cowlove/atari8EspBusBang/hardware/sidecar_smd/README.md

# sidecar_smd: the Sidecar carrier with bare modules (speculative)

The [espBusBangSidecar](../espBusBangSidecar/) carrier with both
ESP32-S3-DevKitC-1 boards replaced by bare **ESP32-S3-WROOM-1-N8R2** modules,
plus what the DevKitC boards used to provide. A sketch of where a production
board could go, not a design to build yet.

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

Layout: the modules' antennas and the microSD slot point off the top edge;
J1 runs along the bottom; the main module's support parts (J5, J6, J3, U3)
are in a left wing and the Sidecar's (J4, J7, U4) in a right wing, beside J1;
the passives sit next to the module pins they serve. The regulators U3 and
U4 are on the back, for hand soldering. Board 110.5 × 35.6 mm.

DRC leftovers: the WROOM footprint's 0.2 mm thermal vias are below the board
setup's 0.3 mm minimum hole (raise the fab capability or lower the minimum);
the modules' silkscreen overhangs the top edge with the antennas; the
"10/02/25" text from the original board sits on J1's pads; four GND pads
reach the pour through one thermal spoke instead of two (starved_thermal);
J1's footprint library ("footprints") isn't in the library table.

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

## Files

| File | |
|---|---|
| `sidecar_smd.kicad_sch` | Generated: don't edit by hand |
| `sidecar_smd.kicad_pro`, `.kicad_pcb` | Copied from espBusBangSidecar (filenames updated) |
| [`../tools/make_sidecar_smd_schematic.py`](../tools/make_sidecar_smd_schematic.py) | Builds it from the espBusBangSidecar schematic and its netlist |

```
kicad-cli sch export netlist -o /tmp/sc.net hardware/espBusBangSidecar/espBusBangSidecar.kicad_sch
python3 hardware/tools/make_sidecar_smd_schematic.py \
    hardware/espBusBangSidecar/espBusBangSidecar.kicad_sch /tmp/sc.net \
    <kicad>/share/kicad/symbols hardware/sidecar_smd/sidecar_smd.kicad_sch
```

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

## What replaced each DevKitC

| Per module | Main (U1) | Sidecar (U2) |
|---|---|---|
| Module | ESP32-S3-WROOM-1-N8R2, `RF_Module:ESP32-S3-WROOM-1` | same |
| 3.3 V regulator | U3 AP7361C-33E (SOT-223, 1 A) from the board rail `+5V` | U4, same |
| Capacitors | C1 10 µ in, C2 22 µ out, C3 100 n at the module | C5, C6, C7 |
| EN (reset) | R8 10 k to 3V3, C4 1 µ to GND: the RC power-on reset the DevKitC had | R10, C8 (`SC_EN`, also on J4) |
| IO0 (boot mode) | R9 10 k to 3V3: boots from flash (also J5 pin 6; the net is `LINK_TX`) | R11 (`SC_BOOT`, also on J4 pin 6) |
| 3V3 net | `3V3` | `SC_3V3` (also J2's SD card and R2-R6) |
| microSD | none | J2, a push-pull microSD socket (Hirose DM3AT-SF-PEJM5, `Connector_Card:microSD_HC_Hirose_DM3AT-SF-PEJM5`) in place of the DevKitC carrier's breakout header: same `SD_*` nets on IO1, IO2, IO42, IO41, IO40, IO39, R2-R6's pull-ups, VDD from `SC_3V3` with C10 100 n, shield to GND. Card detect: the socket's switch runs from GND (DET_B) to `SD_CD` (DET_A), pulled up by R14 10 k to `SC_3V3`, read on Sidecar IO14 |
| Indicator | D2, an LED on MPD_: see below | D1 (below) |
| RGB status LED | none: GPIO48 is the link's BCLK | D1 SK6812MINI (WS2812 protocol) on GPIO48 (`SC_LED`), as on the DevKitC-1 v1.0, from `SC_3V3`, with C9 100 n; DOUT unconnected |

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

## Main module: RFSH and RESET on the USB pins

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

## D2: the main module's indicator, on MPD_

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

## J7: Sidecar breakout

Every Sidecar GPIO with no other job, with power, on a 2×7 header
(`PinHeader_2x07_P2.54mm_Vertical`, odd pins in one row, even in the other).
3V3 and GND are the end pair; USB D−/D+ sit right beside them; a second GND
fills the far end.

| Pin | Net | Pin | Net |
|---|---|---|---|
| 1 | 3V3 (`SC_3V3`) | 2 | GND |
| 3 | IO19 (USB D−) | 4 | IO20 (USB D+) |
| 5 | IO3 (strapping: JTAG source; leave floating at reset) | 6 | IO8 |
| 7 | IO18 | 8 | IO21 |
| 9 | IO35 | 10 | IO36 |
| 11 | IO37 | 12 | IO38 |
| 13 | IO45 (strapping: VDD_SPI; low at reset unless the eFuse is burned) | 14 | GND |

Pins 2-4 are the Sidecar's native USB (GND, D−, D+): a USB cable breakout
there gives USB serial/JTAG without an adapter. IO35-37 are free on the
N8R2's quad PSRAM; an octal-PSRAM module (N8R8) uses them internally.

## Card detect

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

## Soldering

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

## J6: board power

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

## J4 and J5: programming headers (ESP-Prog)

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

## Power during development

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

## Flashing rules

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

## Open questions before this could be built

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
