cowlove/atari8EspBusBang/csim/a800/README.md

# Atari800 CSIM hybrid

The hybrid builds Atari800 from the `atari800` Git submodule in this directory. It configures Atari800 in-place; no separate Atari800 build directory is needed.

## Initialize the submodule

From the `atari8EspBusBang` repository root:

```sh
git submodule update --init --recursive
```

The submodule tracks Jim's `cowlove/atari800` fork on the `csim-pbi` branch.

## Generate and configure Atari800

The submodule checkout may not contain the generated `configure` script. From `csim/a800/atari800`:

```sh
./autogen.sh
CFLAGS='-g -O2 -Wno-error=unused-function' \
  ./configure --with-video=sdl2 --with-sound=sdl2 \
  --disable-audiorecording --disable-dependency-tracking
```

This is the SDL2 configuration (`VIDEO=1`). `autogen.sh` requires the autotools utilities (`aclocal`, `autoheader`, `autoconf`, and `automake`); SDL2 development files are needed for this configuration. Run both commands from the submodule root so configure creates `src/Makefile` there.

If `configure` or `src/Makefile` is missing, the Makefile generates/configures it automatically. The Makefile defaults to `VIDEO=0` (no video or sound); use `VIDEO=1` to enable SDL2:

```sh
make -C csim/a800 VIDEO=1 hybrid
```

Switching `VIDEO` automatically reconfigures Atari800 and reuses the same build and executable directories. `VIDEO=0` is already the default; use `make -C csim/a800 VIDEO=1 hybrid` for SDL2. `run.sh` launches the built emulator directly without Xvfb. If also profiling, combine variables, for example `make -C csim/a800 VIDEO=1 PROFILE=1 hybrid`.

## Build and run

From the repository root:

```sh
make -C csim/a800 hybrid
csim/a800/run.sh
```

`BOOT_CONFIG` selects the firmware boot configuration and defaults to `CSIM`.
Set it to any configuration name supported by `SysConfig`, for example:

```sh
BOOT_CONFIG="SDX_XL" make -C csim/a800
```

Changing `BOOT_CONFIG` automatically rebuilds the CSIM objects that embed the
selected configuration.

To start Atari800 under GDB, with `-xl -nopatchall` and any following arguments passed to the emulator:

```sh
csim/a800/run.sh --gdb -turbo
```

The hybrid executable is written to `csim/a800/build-atari/atari800-csim`. Additional arguments to `run.sh` are forwarded to Atari800.

CSIM uses the real `libsmb2` client from the firmware's `libsmb2` submodule,
`components/libsmb2/libsmb2`, for SMB-backed disks. Initialize it with `git
submodule update --init components/libsmb2/libsmb2`; the CSIM Makefile builds its shared library in the
separate ignored `csim/a800/build-libsmb2` directory and links both runner and hybrid
targets against it. SMB URLs must be reachable from the host running CSIM, and
the URL or configured credentials must permit access.

## CSIM scope and emulator services

CSIM runs the firmware-side code in a host process; by default it does not
itself emulate Atari hardware memory mapping (see bus-cycle mode below for
the exception). Keep the normal firmware paths compiled and
running under CSIM—do not exclude them with `#ifdef CSIM` just because their
hardware services are not implemented by the CSIM stubs. Atari800 supplies
the guest-system behavior, including cartridge mapping, extended-memory
mapping, and RAM-under-OS behavior, according to its startup configuration.

In particular, `run.sh` starts Atari800 with `-xl -nopatchall`, the
`SDX451_maxflash1.car` cartridge, `-turbo`, and `-rambo`. `-rambo` enables
Atari800's RAMBO extended-memory model; SDX's `RAMDISK.SYS` driver still has to
be installed by SDX (for example, from its configuration or a batch command)
to create a DOS-visible RAM disk. `BOOT_CONFIG` selects the firmware
configuration independently of the cartridge passed to Atari800 by `run.sh`,
so those two selections can differ.

## Bus-cycle mode (`BUS_CYCLE=1`)

`BUS_CYCLE=1 csim/a800/run.sh` builds both sides with `-DCSIM_BUS_CYCLE`: every
CPU access in atari800 runs one bus cycle through `csim_bus_cycle()` in
`main/core1.cpp`, so the board's own memory map (`mmu.cpp`, `cartridge.cpp`,
extended banks, PBI ROM) serves the 6502. `csim_bus_cycle()` is a plain C++
reference version of core 1's ESP32 loop (`iloop_pbi()`), not that loop
itself: it does what the loop does, without the timing and asm, and the two
have to be kept in step. When it asserts extSel_ the board handled the
access; otherwise atari800 does. `run.sh` then defaults `BOOT_CONFIG` to `SDX_CSIM_BUS` and gives
atari800 no cartridge and no `-rambo`, since the board supplies both.
Core 0 runs as a coroutine in this mode (2026-11-12): it has its own stack
and runs the real `threadFunc()`/`core0Loop()`, as on the hardware (bmon,
PBI requests with the real stack-program wait, the startup first-write
handshake, utility tasks, interrupt pacing, timeouts, the end-of-run
report). atari800's CPU tick resumes it; it yields back on every 64th
CCOUNT read from its stack and in `busyWait6502Ticks()`, which waits real
emulated time. atari800 is never re-entered. (`swapcontext()` saves the
signal mask with a syscall, so the mode runs about 3x slower than before.)
`CSIM_INTERNAL_FREE=<bytes>` sets how much internal RAM `heap_caps_get_free_size()`
reports (default: plenty), for sizing decisions such as `SDX_CSIM_BUS_AUTO`'s SRAM budget.
`CSIM_BUS_CYCLE_TEST=1` runs a short self-test at startup. Expect it to run
several times slower than the default mode.

What it doesn't cover:

- **Exact halts and PSRAM swaps.** halt_ is emulated approximately
  (2026-11-12): `csim_stubs.cpp` tracks the pin from each cycle's
  release/assert, and while the board holds it atari800's CPU runs no
  instruction, only idle bus cycles and core 0's tick, until core 0's
  release reaches the pin (`busyWait6502Ticks()` runs idle cycles in this
  mode, so `resume6502()` works). Stalls happen only at instruction
  boundaries, and ANTIC's NMIs aren't held off. That's enough to see
  whether a halt stops the 6502, and BANKTEST passes with every PORTB
  switch really halting; the exit line reports `csim halt line on: N
  stalls`. `CSIM_HALT_LINE=0` plays a machine without the line (a 130XE on
  the ECI): halt_ is driven, nothing stalls. Still not covered: evictions.
  `ExtBankPool::isSRAM()` passes every host pointer, every bank counts as
  SRAM, and the status line reads `evict 0/N`. Test evictions on
  hardware.
- **ANTIC.** Its DMA reads use atari800's memory, not the board's map, so
  the display shows atari800's RAM where the board serves memory.
- **Timing.** The body's delays are no-ops; the cycle order is atari800's.
  atari800's monitor history peeks at the code without a bus cycle, so the
  board sees only the CPU's own accesses.

### Bank tests

`spiffs/stress.c` (`make -C spiffs stress.car.gz stress-megacart.car.gz`,
boot configs `BANKTEST` for the AtariMax build and `BANKTEST_MC` for the
MegaCart one) checks that a bank switch reaches the very next bus cycle,
alongside stress's other tests: an STA to PORTB, $D5xx or $D1FF falls
through into the banked window ($4000, the cart window, $D800), and bank B
counts the hit in X. The $D1FF stub runs at $D7FD, in the PBI RAM the board
keeps at $D600-$D7FF (`main/mmu.cpp`; the atari800 fork gives the default
mode the same RAM). A fourth test (AtariMax only) disables BASIC the same
way, falling from ROM into the RAM under it. Each loop prints
`bank ext:misses/tries cart:... pbi:... basic:... cal:N` (`cal`: calibration
failures; the MegaCart build adds `late:`).

MegaCart selects the bank by the data written to $D500, which the board
picks up one cycle late (`main/core1.cpp`), so its build runs the cart test
twice: `cart` with a NOP between the STA and the probe (should hit) and
`late`, the exact fall-through (misses on the board by design).

```sh
CART=../../spiffs/.build/stress.car BOOT_CONFIG=BANKTEST csim/a800/run.sh
CART=../../spiffs/.build/stress-megacart.car BOOT_CONFIG=BANKTEST_MC csim/a800/run.sh
BUS_CYCLE=1 BOOT_CONFIG=BANKTEST csim/a800/run.sh
BUS_CYCLE=1 BOOT_CONFIG=BANKTEST_MC csim/a800/run.sh
```

Everything passes in the default mode, where atari800 switches banks
itself. In bus-cycle mode (2026-11-11) the board passes every PORTB, $D1FF
and AtariMax $D5xx switch and the BASIC test, and MegaCart's `cart`; only
`late` misses, every time. With the MegaCart read-path pickup taken out of
the board (as before 490244a8), `cart` misses every time too. On hardware,
`BANKTEST` uses one SRAM bank, so every PORTB switch also exercises the halt
and PSRAM swap. The MegaCart build leaves the ext test out (`ext:0/0`): its
C stack sits inside the $4000-$7FFF bank window.

## Profiling

Build both the CSIM code and Atari800 with GNU `gprof` instrumentation by setting `PROFILE=1`:

```sh
make -C csim/a800 PROFILE=1 hybrid
```

This adds `-pg` to the CSIM compiler and linker flags and to Atari800's `CFLAGS`, `CXXFLAGS`, and `LDFLAGS`. The normal build remains the default (`PROFILE=0`); switch back with `make -C csim/a800 PROFILE=0 hybrid`. Changing the profile setting automatically refreshes affected objects and Atari800 configuration, while keeping the same build and executable directories.

## Sidecar

CSIM always runs the Sidecar coprocessor app (`sidecar/main/sidecarApp.cpp`)
in the same process: `csim.h` defines `CONFIG_A8BB_SIDECAR_ENABLE`, so the
host's Sidecar code (`main/sidecarHost.cpp`) is on too. The two meet in a
simulated i2slink (`components/sidecar_link/i2slink_csim.cpp`) that replaces
the I2S hardware at the `i2slink.h` boundary:

- each direction is a shared buffer: `i2slink_write()` builds the real wire
  cycle (VSYNC, HSYNC markers, stamps, CRC) and stores it in the peer's RX
  ring, bit-shifted by a random amount per connection, so the reader's real
  lock search and decode (`i2slink_wire.h`) run;
- `csim_sidecar.cpp` wires the host's link pins (virtual GPIOs 100/101 in
  `pinDefs.h`) to the Sidecar's, and polls the Sidecar's loop after every
  link write (so a response is ready when the host's write returns) and on
  every emulated CPU tick;
- there is no timing model: `read()` never waits, and a wait only advances
  simulated time (`esp_timer_get_time()` follows CCOUNT).

At startup the host probes the Sidecar and sends one SIO command; look for
`Sidecar: present; SIO echo ok` in the output.
