cowlove/atari8EspBusBang/hardware/gerbers/pcbway/espBusBangSidecar-bom.csv

Item # | Designator | Qty | Manufacturer | Mfg Part # | Description / Value | Package/Footprint | Type | Your Instructions / Notes
1 | D2 | 1 | Hubei KENTO | KT-0805G | Green LED | 0805 | SMD | Any 0805 LED, colour free
2 | J1 | 1 | TE Connectivity | 5530843-5 | 50-pos 2.54mm card edge connector (PBI) | THT | THT | Insert from the BOTTOM side (opposite the modules), solder on top. The footprint and its silkscreen are on the top layer
3 | J2 | 1 | Generic | 1x08 2.54mm male header | 8-pin 2.54mm male pin header, vertical | THT | THT
4 | J3 | 1 | Generic | 1x03 2.54mm male header | 3-pin 2.54mm male pin header, vertical | THT | THT
5 | J4,J5 | 2 | Generic | 2x03 2.54mm male header | 6-pin 2.54mm male pin header, vertical | THT | THT
6 | J7 | 1 | Generic | 2x08 2.54mm male header | 16-pin 2.54mm male pin header, vertical | THT | THT
7 | J8,J9,J10 | 3 | Generic | 1x02 2.54mm male header | 2-pin 2.54mm male pin header, vertical | THT | THT
8 | R1 | 1 | UNI-ROYAL | 0805W8F0000T5E | 0 ohm resistor | 0805 | SMD
9 | R2,R3,R4,R5,R6 | 5 | UNI-ROYAL | 0805W8F1002T5E | 10k 1% resistor | 0805 | SMD
10 | R7,R12,R13,R15,R16,R17 | 6 | UNI-ROYAL | 0805W8F1001T5E | 1k 1% resistor | 0805 | SMD
11 | U1,U2 | 2 | Generic | 1x22 2.54mm female header | Socket for an ESP32-S3-DevKitC-1: two 1x22 2.54mm female headers per designator | THT | THT | Fit 2 x 1x22 female headers per designator (4 total for U1+U2); DevKitC boards NOT supplied
