cowlove/atari8EspBusBang/docs/sidecar_wiring.pdf

# Main board <-> Sidecar wiring (ESP32-S3-DevKitC-1 pair)

Generated 2026-11-12 by hardware/tools/sidecar_wiring.py. Ground and power come through the carrier board (not drawn). Header pin numbers: DevKitC-1, pin 1 away from the USB end.

## Main board (host app)

J1 | J3USB end
1 | 3V3
2 | 3V3
3 | RST
4 | GPIO4
5 | GPIO5
6 | GPIO6
7 | GPIO7
8 | GPIO15
9 | GPIO16
10 | GPIO17
11 | GPIO18
12 | GPIO8
13 | GPIO3 | strap
14 | GPIO46 strap
15 | GPIO9
16 | GPIO10
17 | GPIO11
18 | GPIO12
19 | GPIO13
20 | GPIO14
21 | 5V
22 | GND
| GND | 1
U0TXD | GPIO43 | 2
U0RXD | GPIO44 | 3
| GPIO1 | 4
| GPIO2 | 5
| GPIO42 | 6
| GPIO41 | 7
| GPIO40 | 8
| GPIO39 | 9
| GPIO38 | 10
| GPIO37 | 11
| GPIO36 | 12
| GPIO35 | 13
strap | GPIO0 | 14
strap | GPIO45 | 15
| GPIO48 | 16
| GPIO47 | 17
| GPIO21 | 18
USB D+ | GPIO20 | 19
USB D- | GPIO19 | 20
| GND | 21
| GND | 22

## Sidecar board

J1 | J3USB end
1 | 3V3
2 | 3V3
3 | RST
4 | GPIO4
5 | GPIO5
6 | GPIO6
7 | GPIO7
8 | GPIO15
9 | GPIO16
10 | GPIO17
11 | GPIO18
12 | GPIO8
13 | GPIO3 | strap
14 | GPIO46 strap
15 | GPIO9
16 | GPIO10
17 | GPIO11
18 | GPIO12
19 | GPIO13
20 | GPIO14
21 | 5V
22 | GND
| GND | 1
U0TXD | GPIO43 | 2
U0RXD | GPIO44 | 3
| GPIO1 | 4
| GPIO2 | 5
| GPIO42 | 6
| GPIO41 | 7
| GPIO40 | 8
| GPIO39 | 9
| GPIO38 | 10
oPSRAM | GPIO37 | 11
oPSRAM | GPIO36 | 12
oPSRAM | GPIO35 | 13
strap | GPIO0 | 14
strap | GPIO45 | 15
| GPIO48 | 16
| GPIO47 | 17
| GPIO21 | 18
USB D+ | GPIO20 | 19
USB D- | GPIO19 | 20
| GND | 21
| GND | 22

Atari RFSH (3.3 V side)

Atari AUDIO (PBI 49)

microSD
4-bit SDMMC

DAT2

DAT3

CMD

CLK

DAT0

DAT1

VDD 3.3 V, GND
10 k pull-ups
Signal | From | To | Header (from -> to) Status | Notes
Link TX | main GPIO0 | Sidecar GPIO9 | J3-14 -> J1-15 | wired | host TX -> Sidecar RX; also main IO0 (BOOT) for serial flashing; PBI audio on espBusBang only
Link RX | Sidecar GPIO46 | main GPIO21 | J1-14 -> J3-18 | wired | Sidecar TX -> host RX; Sidecar carrier: via jumper J3 2-3 (1-2: GPIO21 = RFSH)
BCLK | main GPIO48 | Sidecar GPIO10 | J3-16 -> J1-16 | wired | host drives the link clock; sampler (link off): main’s profile pin GPIO48
phi2 | main GPIO36 | Sidecar GPIO4 | J3-12 -> J1-4 | planned | Sidecar bus profiler: clock
R/W | main GPIO17 | Sidecar GPIO5 | J1-10 -> J1-5 | planned | Sidecar bus profiler; host R/W is GPIO15 on the Sidecar carrier (R/W regroup)
extSel_ | main GPIO47 | Sidecar GPIO6 | J3-17 -> J1-6 | planned | Sidecar bus profiler; open drain on the host, keep it short
D0 | main GPIO38 | Sidecar GPIO7 | J3-10 -> J1-7 | planned | Sidecar bus profiler
D1 | main GPIO39 | Sidecar GPIO15 | J3-9 -> J1-8 | planned | Sidecar bus profiler

## Main board <-> Sidecar wiring (ESP32-S3-DevKitC-1 pair) (continued)

Signal | From | To | Header (from -> to) Status | Notes
A0 | main GPIO1 | Sidecar GPIO16 | J3-4 -> J1-9 | planned | Sidecar bus profiler
RFSH | Atari RFSH | Sidecar GPIO17 | - -> J1-10 | planned | Sidecar bus profiler refresh_; 3.3 V side, never the 5 V bus line; or main GPIO21 where it is refresh_ (espBusBang, .5)
SD DAT2 Sidecar GPIO1 | microSD DAT2 | J3-4 -> - | planned | 10 k pull-up
SD DAT3 Sidecar GPIO2 | microSD DAT3 | J3-5 -> - | planned | 10 k pull-up (also CD)
SD CMD Sidecar GPIO42 | microSD CMD | J3-6 -> - | planned | 10 k pull-up
SD CLK | Sidecar GPIO41 | microSD CLK | J3-7 -> - | planned | up to 40 MHz; keep it short, no pull-up
SD DAT0 Sidecar GPIO40 | microSD DAT0 | J3-8 -> - | planned | 10 k pull-up
SD DAT1 Sidecar GPIO39 | microSD DAT1 | J3-9 -> - | planned | 10 k pull-up
Main EN | Sidecar GPIO11 | main RST (EN) | J1-17 -> J1-3 | planned | open drain: the Sidecar resets the main board (flashing, recovery)
Flash TX Sidecar GPIO12 | main GPIO44 | J1-18 -> J3-3 | planned | via 1 k to main RXD0 = Atari D6: only with the Atari off
Flash RX main GPIO43 | Sidecar GPIO13 | J3-2 -> J1-19 | planned | via 1 k from main TXD0 = Atari D5: only with the Atari off
Audio | Sidecar GPIO47 | Atari AUDIO | J3-17 -> - | planned | via 1 k series resistor (sets the level); host GPIO0 no longer on AUDIO

Solid: wired now. Dashed: planned. Filled pin: has a wire. oPSRAM: octal-PSRAM pin (N8R8, N16R8 modules).
Bus-profiler taps: Sidecar inputs only, no pulls; 330-470 ohm in series at the main board end.
Keep the Sidecar powered (its own USB) whenever the Atari is on: an unpowered ESP32 loads the bus lines.
