cowlove/atari8EspBusBang/hardware/sidecar_pcb_xe/sidecar_pcb_xe.kicad_pcb

## KiCad design hardware/sidecar_pcb_xe/sidecar_pcb_xe.kicad_pcb (2026-11-13)

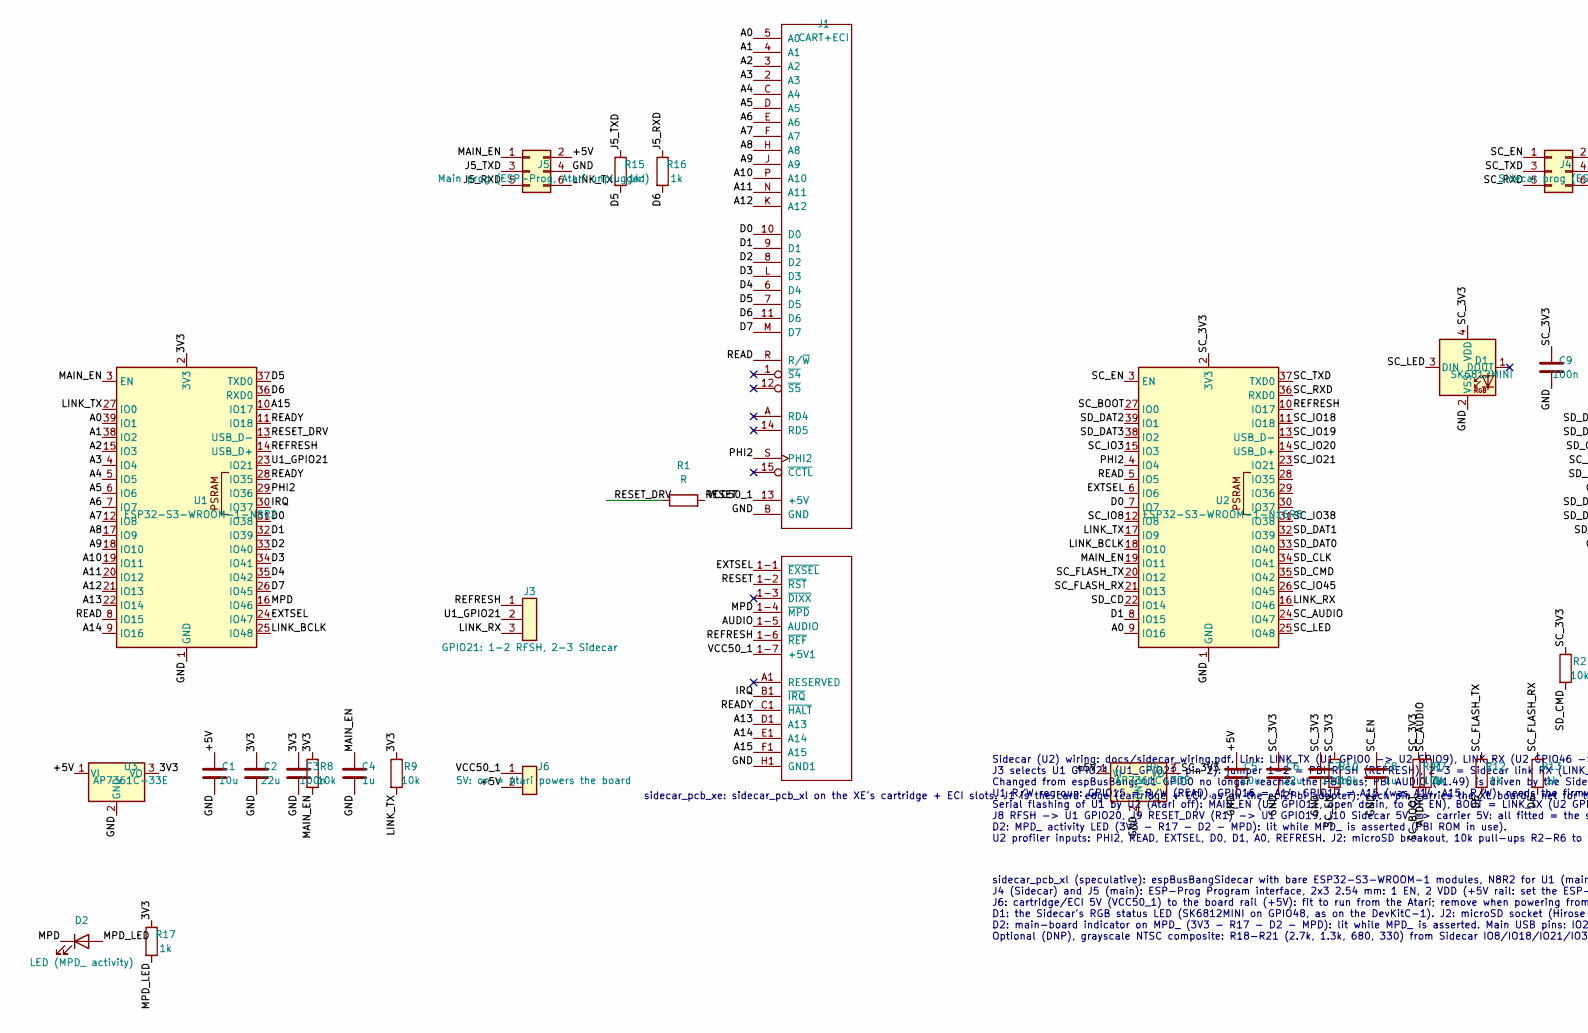
[picture p1: schematic sidecar_pcb_xe.kicad_sch, part in row 1, column 1]

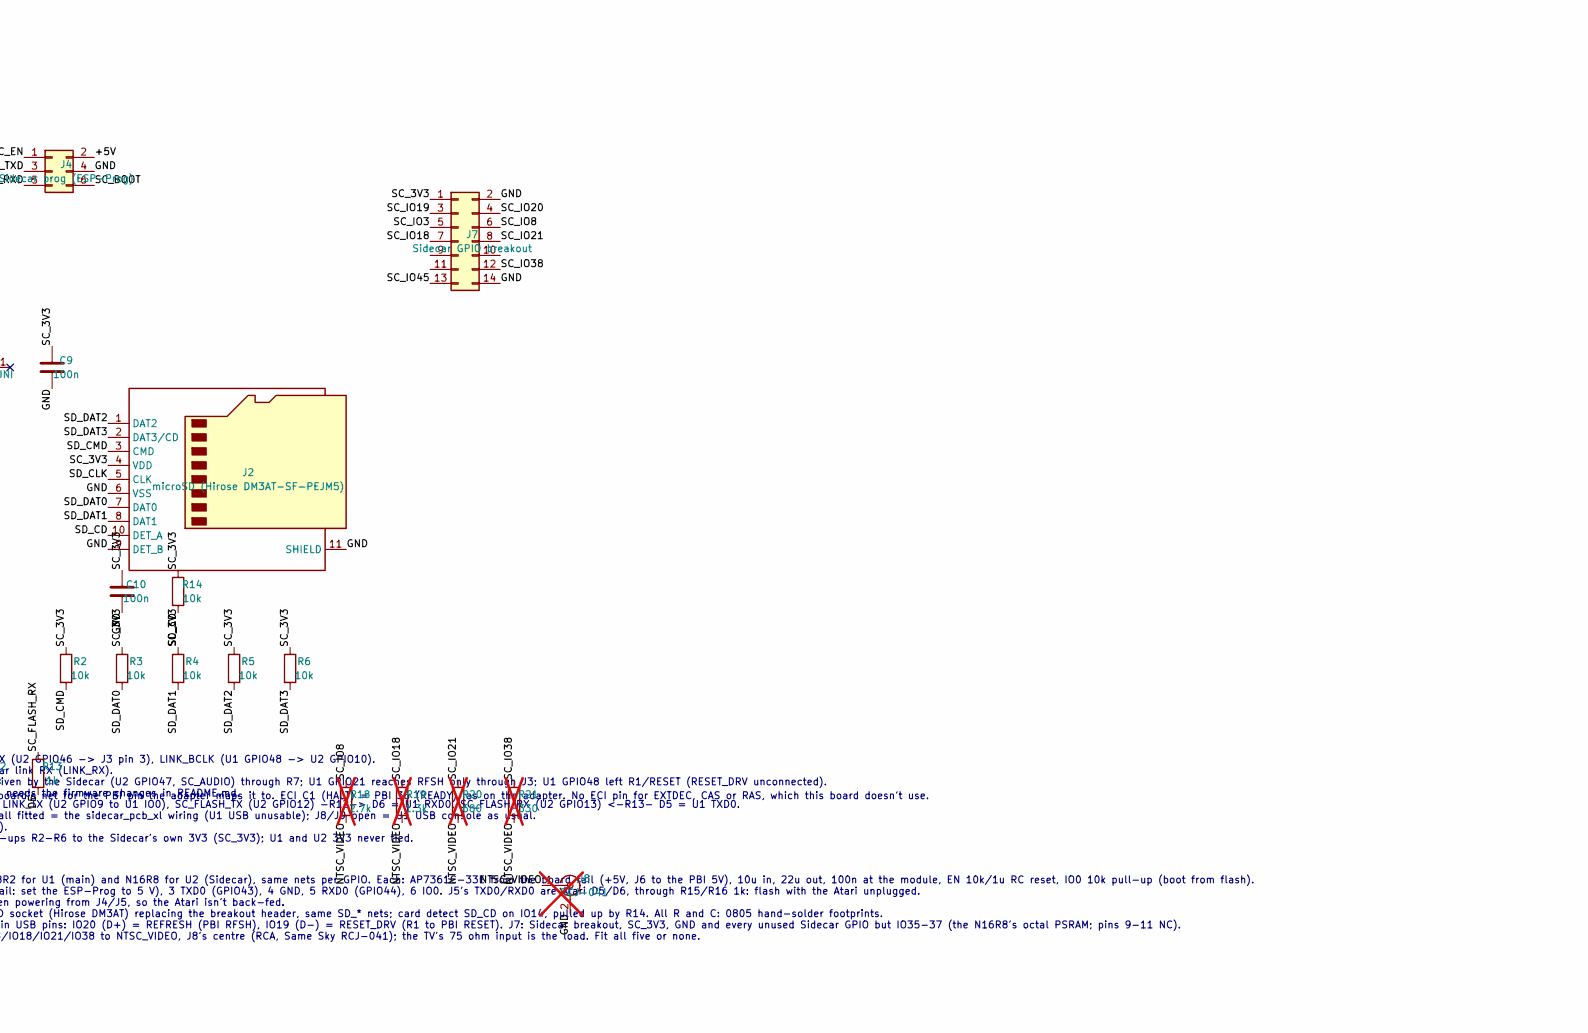
[picture p2: schematic sidecar_pcb_xe.kicad_sch, part in row 1, column 2]

Parts:
C1, C5: 10u; C_0805_2012Metric_Pad1.18x1.45mm_HandSolder
C2, C6: 22u; C_0805_2012Metric_Pad1.18x1.45mm_HandSolder
C3, C7, C9, C10: 100n; C_0805_2012Metric_Pad1.18x1.45mm_HandSolder
C4, C8: 1u; C_0805_2012Metric_Pad1.18x1.45mm_HandSolder
D1: SK6812MINI; LED_SK6812MINI_PLCC4_3.5x3.5mm_P1.75mm
D2: LED (MPD_ activity); LED_0805_2012Metric_Pad1.15x1.40mm_HandSolder
J1: CART+ECI; CART+ECI_V3.0
J2: microSD (Hirose DM3AT-SF-PEJM5); microSD_HC_Hirose_DM3AT-SF-PEJM5
J3: GPIO21: 1-2 RFSH, 2-3 Sidecar; PinHeader_1x03_P2.54mm_Vertical
J4: Sidecar prog (ESP-Prog); PinHeader_2x03_P2.54mm_Vertical
J5: Main prog (ESP-Prog, Atari unplugged); PinHeader_2x03_P2.54mm_Vertical
J6: 5V: on = Atari powers the board; PinHeader_1x02_P2.54mm_Vertical
J7: Sidecar GPIO breakout; PinHeader_2x07_P2.54mm_Vertical
J8: RCJ-041; RCA_SameSky_RCJ-04x_Horizontal; not fitted
R1: R; R_0805_2012Metric_Pad1.20x1.40mm_HandSolder
R2, R3, R4, R5, R6, R8, R9, R10, R11, R14: 10k; R_0805_2012Metric_Pad1.20x1.40mm_HandSolder
R7, R12, R13, R15, R16, R17: 1k; R_0805_2012Metric_Pad1.20x1.40mm_HandSolder
R18: 2.7k; R_0805_2012Metric_Pad1.20x1.40mm_HandSolder; not fitted
R19: 1.3k; R_0805_2012Metric_Pad1.20x1.40mm_HandSolder; not fitted
R20: 680; R_0805_2012Metric_Pad1.20x1.40mm_HandSolder; not fitted
R21: 330; R_0805_2012Metric_Pad1.20x1.40mm_HandSolder; not fitted
U1: ESP32-S3-WROOM-1-N8R2; ESP32-S3-WROOM-1
U2: ESP32-S3-WROOM-1-N16R8; ESP32-S3-WROOM-1
U3, U4: AP7361C-33E; SOT-223-3_TabPin2

Connections:
/3V3: C2.1, C3.1, R8.1, R9.1, R17.1, U1.2 (3V3), U3.3 (VO)
/+5V: C1.1, C5.1, J4.2, J5.2, J6.2, U3.1 (VI), U4.1 (VI)
/A0: J1.5 (A0), U1.39 (IO1), U2.9 (IO16)
/A1: J1.4 (A1), U1.38 (IO2)
/A2: J1.3 (A2), U1.15 (IO3)
/A3: J1.2 (A3), U1.4 (IO4)
/A4: J1.C (A4), U1.5 (IO5)
/A5: J1.D (A5), U1.6 (IO6)
/A6: J1.E (A6), U1.7 (IO7)
/A7: J1.F (A7), U1.12 (IO8)
/A8: J1.H (A8), U1.17 (IO9)
/A9: J1.J (A9), U1.18 (IO10)
/A10: J1.P (A10), U1.19 (IO11)
/A11: J1.N (A11), U1.20 (IO12)
/A12: J1.K (A12), U1.21 (IO13)
/A13: J1.D1 (A13), U1.22 (IO14)
/A14: J1.E1 (A14), U1.9 (IO16)
/A15: J1.F1 (A15), U1.10 (IO17)
/AUDIO: J1.1-5 (AUDIO), R7.2
/D0: J1.10 (D0), U1.31 (IO38), U2.7 (IO7)
/D1: J1.9 (D1), U1.32 (IO39), U2.8 (IO15)
/D2: J1.8 (D2), U1.33 (IO40)
/D3: J1.L (D3), U1.34 (IO41)
/D4: J1.6 (D4), U1.35 (IO42)
/D5: J1.7 (D5), R13.2, R15.2, U1.37 (TXD0)
/D6: J1.11 (D6), R12.2, R16.2, U1.36 (RXD0)
/D7: J1.M (D7), U1.26 (IO45)
/EXTSEL: J1.1-1 (~EXSEL), U1.24 (IO47), U2.6 (IO6)
/GND: C1.2, C2.2, C3.2, C4.2, C5.2, C6.2, C7.2, C8.2, C9.2, C10.2, D1.2 (VSS), J1.B (GND), J1.H1 (GND1), J2.6 (VSS), J2.9 (DET_B), J2.11 (SHIELD), J4.4, J5.4, J7.2, J7.14, J8.2 (Ext), U1.1 (GND), U1.40 (GND), U1.41 (GND), U2.1 (GND), U2.40 (GND), U2.41 (GND), U3.2 (GND), U4.2 (GND)
/IRQ: J1.B1 (~IRQ), U1.30 (IO37)
/J5_RXD: J5.5, R16.1
/J5_TXD: J5.3, R15.1
/LINK_BCLK: U1.25 (IO48), U2.18 (IO10)
/LINK_RX: J3.3, U2.16 (IO46)
/LINK_TX: J5.6, R9.2, U1.27 (IO0), U2.17 (IO9)
/MAIN_EN: C4.1, J5.1, R8.2, U1.3 (EN), U2.19 (IO11)
/MPD: D2.1 (K), J1.1-4 (~MPD), U1.16 (IO46)
/MPD_LED: D2.2 (A), R17.2
/NTSC_VIDEO: J8.1 (In), R18.2, R19.2, R20.2, R21.2
/PHI2: J1.S (PHI2), U1.29 (IO36), U2.4 (IO4)
/READ: J1.R (R/~W), U1.8 (IO15), U2.5 (IO5)
/READY: J1.C1 (~HALT), U1.11 (IO18), U1.28 (IO35)
/REFRESH: J1.1-6 (~REF), J3.1, U1.14 (USB_D+), U2.10 (IO17)
/RESET: J1.1-2 (~RST), R1.2
/RESET_DRV: R1.1, U1.13 (USB_D-)
/SC_3V3: C6.1, C7.1, C9.1, C10.1, D1.4 (VDD), J2.4 (VDD), J7.1, R2.1, R3.1, R4.1, R5.1, R6.1, R10.1, R11.1, R14.1, U2.2 (3V3), U4.3 (VO)
/SC_AUDIO: R7.1, U2.24 (IO47)
/SC_BOOT: J4.6, R11.2, U2.27 (IO0)
/SC_EN: C8.1, J4.1, R10.2, U2.3 (EN)
/SC_FLASH_RX: R13.1, U2.21 (IO13)
/SC_FLASH_TX: R12.1, U2.20 (IO12)
/SC_IO3: J7.5, U2.15 (IO3)
/SC_IO8: J7.6, R18.1, U2.12 (IO8)
/SC_IO18: J7.7, R19.1, U2.11 (IO18)
/SC_IO19: J7.3, U2.13 (USB_D-)
/SC_IO20: J7.4, U2.14 (USB_D+)
/SC_IO21: J7.8, R20.1, U2.23 (IO21)
/SC_IO38: J7.12, R21.1, U2.31 (IO38)
/SC_IO45: J7.13, U2.26 (IO45)
/SC_LED: D1.3 (DIN), U2.25 (IO48)
/SC_RXD: J4.5, U2.36 (RXD0)
/SC_TXD: J4.3, U2.37 (TXD0)
/SD_CD: J2.10 (DET_A), R14.2, U2.22 (IO14)
/SD_CLK: J2.5 (CLK), U2.34 (IO41)
/SD_CMD: J2.3 (CMD), R2.2, U2.35 (IO42)
/SD_DAT0: J2.7 (DAT0), R3.2, U2.33 (IO40)
/SD_DAT1: J2.8 (DAT1), R4.2, U2.32 (IO39)
/SD_DAT2: J2.1 (DAT2), R5.2, U2.39 (IO1)
/SD_DAT3: J2.2 (DAT3/CD), R6.2, U2.38 (IO2)
/U1_GPIO21: J3.2, U1.23 (IO21)
/VCC50_1: J1.1-7 (+5V1), J1.13 (+5V), J6.1

Notes on the sheet:
Sidecar (U2) wiring: docs/sidecar_wiring.pdf. Link: LINK_TX (U1 GPIO0 -> U2 GPIO9), LINK_RX (U2 GPIO46 -> J3 pin 3), LINK_BCLK (U1 GPIO48 -> U2 GPIO10). J3 selects U1 GPIO21 (U1_GPIO21, pin 2): jumper 1-2 = PBI RFSH (REFRESH), 2-3 = Sidecar link RX (LINK_RX). Changed from espBusBang: U1 GPIO0 no lo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
sidecar_pcb_xl (speculative): espBusBangSidecar with bare ESP32-S3-WROOM-1 modules, N8R2 for U1 (main) and N16R8 for U2 (Sidecar), same nets per GPIO. Each: AP7361C-33E from the board rail (+5V, J6 to the PBI 5V), 10u in, 22u out, 100n at the module, EN 10k/1u RC reset, IO0 10k pull-up (boot from f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
sidecar_pcb_xe: sidecar_pcb_xl on the XE's cartridge + ECI slots. J1 is the card edge (cartridge + ECI, as on the eci2Pbi adapter); each pin carries the XL board's net for the PBI pin the adapter maps it to. ECI C1 (HALT) = PBI 36 (READY), as on the adapter. No ECI pin for EXTDEC, CAS or RAS, which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

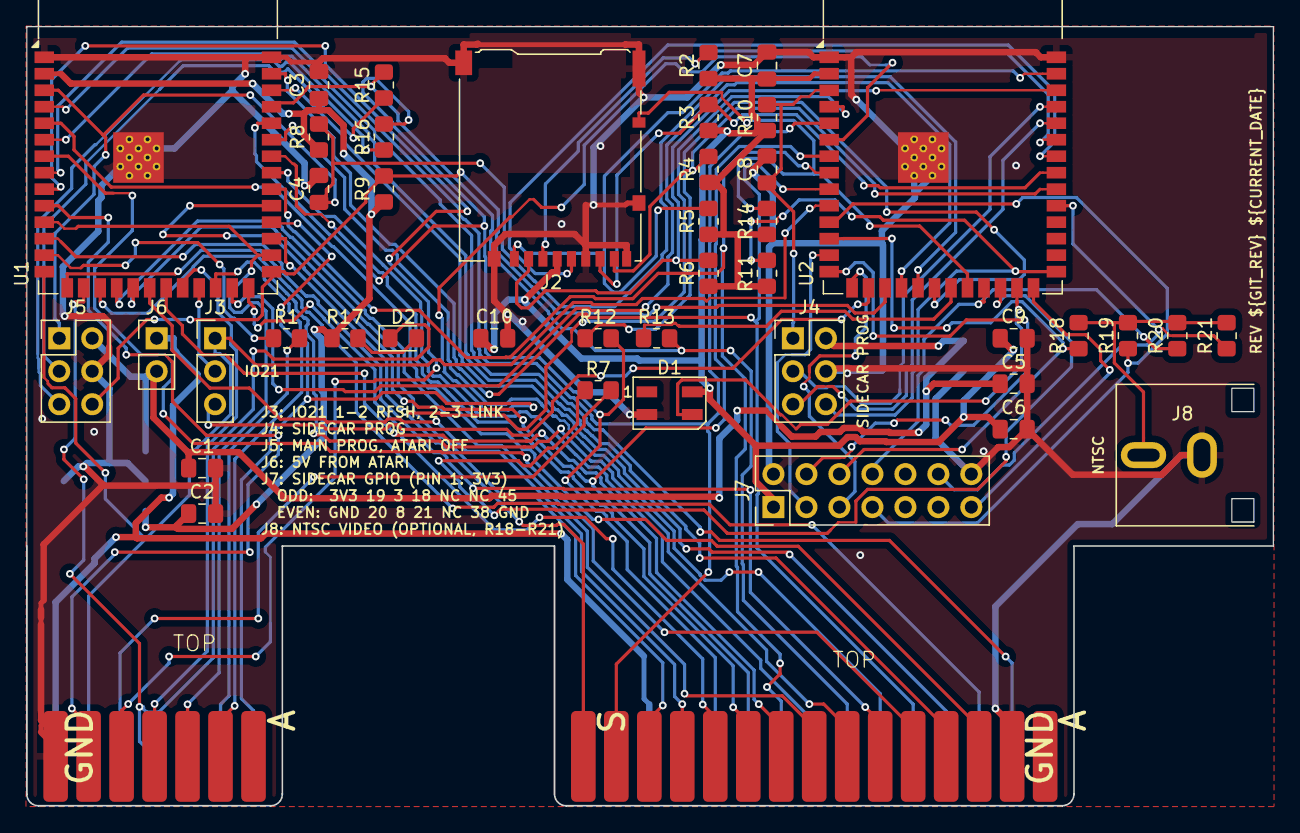
[picture p3: board sidecar_pcb_xe.kicad_pcb from above]

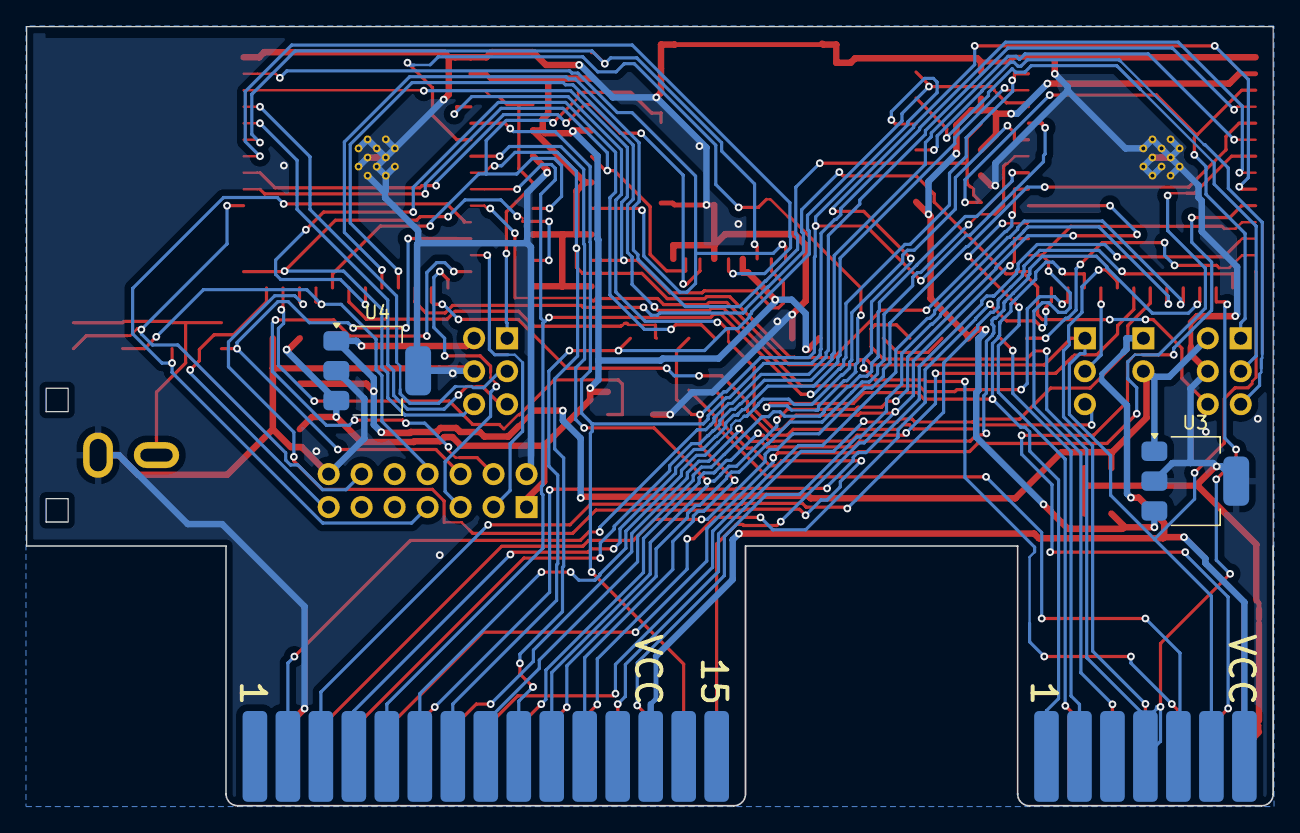
[picture p4: board sidecar_pcb_xe.kicad_pcb from below]

Board: 2 copper layers, 96.0 x 60.0 mm, 45 parts (2 on the bottom side), 71 nets.
