cowlove/atari8EspBusBang/hardware/espBusBangSidecar/espBusBangSidecar.kicad_pcb

## KiCad design hardware/espBusBangSidecar/espBusBangSidecar.kicad_pcb (2026-11-12)

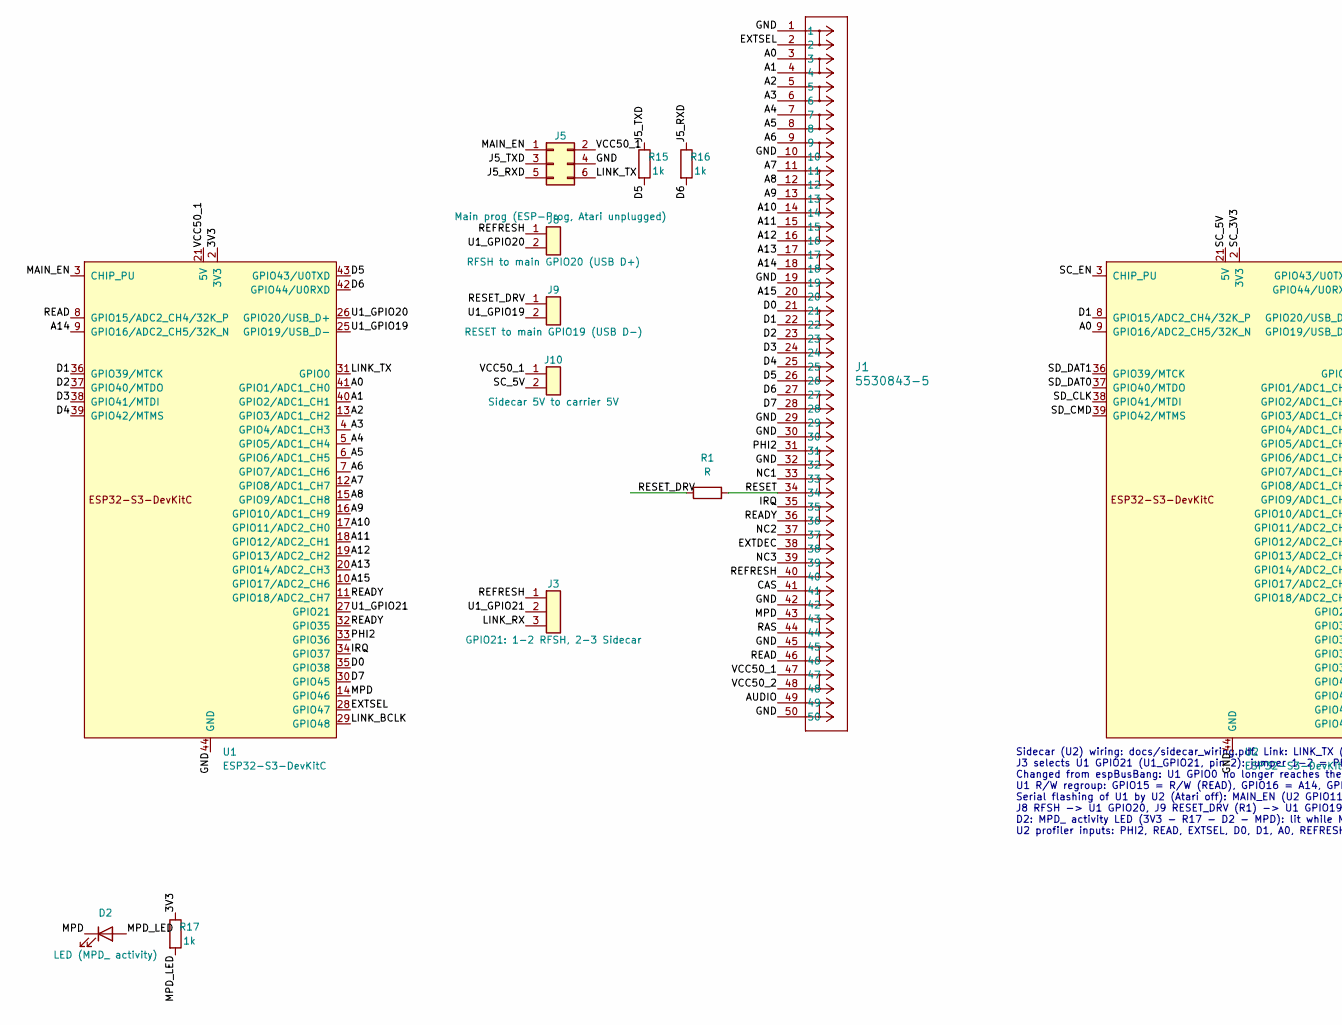
[picture p5: schematic espBusBangSidecar.kicad_sch, part in row 1, column 1]

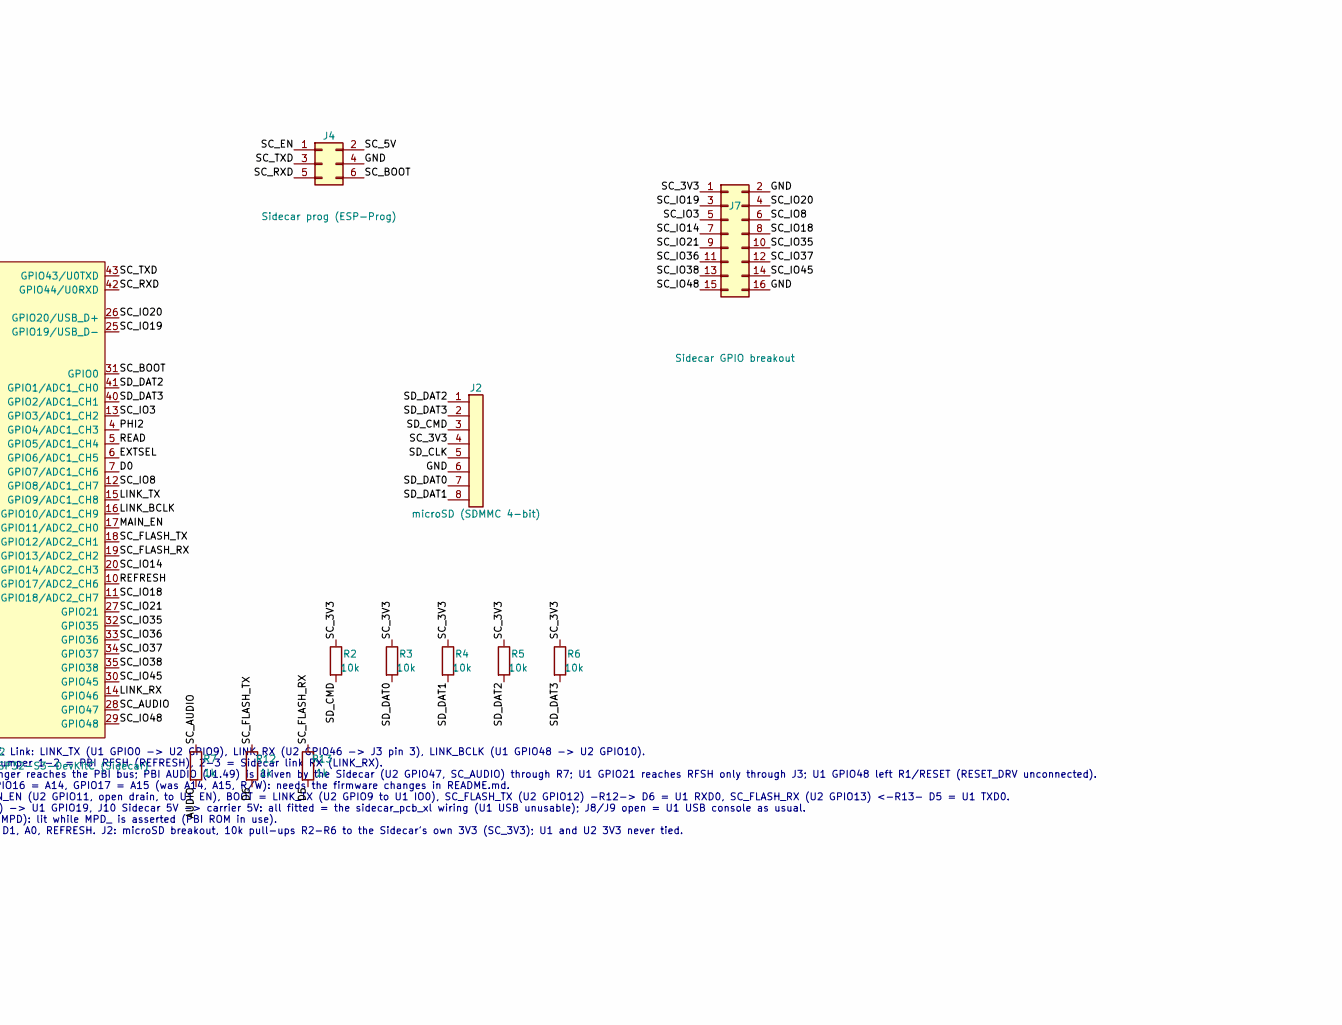
[picture p6: schematic espBusBangSidecar.kicad_sch, part in row 1, column 2]

Parts:
D2: LED (MPD_ activity); LED_0805_2012Metric_Pad1.15x1.40mm_HandSolder
J1: 5530843-5; CONN50_5530843-5_TEC
J2: microSD (SDMMC 4-bit); PinHeader_1x08_P2.54mm_Vertical
J3: GPIO21: 1-2 RFSH, 2-3 Sidecar; PinHeader_1x03_P2.54mm_Vertical
J4: Sidecar prog (ESP-Prog); PinHeader_2x03_P2.54mm_Vertical
J5: Main prog (ESP-Prog, Atari unplugged); PinHeader_2x03_P2.54mm_Vertical
J7: Sidecar GPIO breakout; PinHeader_2x08_P2.54mm_Vertical
J8: RFSH to main GPIO20 (USB D+); PinHeader_1x02_P2.54mm_Vertical
J9: RESET to main GPIO19 (USB D-); PinHeader_1x02_P2.54mm_Vertical
J10: Sidecar 5V to carrier 5V; PinHeader_1x02_P2.54mm_Vertical
R1: R; R_0805_2012Metric_Pad1.20x1.40mm_HandSolder
R2, R3, R4, R5, R6: 10k; R_0805_2012Metric_Pad1.20x1.40mm_HandSolder
R7, R12, R13, R15, R16, R17: 1k; R_0805_2012Metric_Pad1.20x1.40mm_HandSolder
U1: ESP32-S3-DevKitC; ESP32-S2-DevKitC-1
U2: ESP32-S3-DevKitC (Sidecar); ESP32-S2-DevKitC-1

Connections:
/3V3: R17.1, U1.1 (3V3), U1.2 (3V3)
/A0: J1.3, U1.41 (GPIO1/ADC1_CH0), U2.9 (GPIO16/ADC2_CH5/32K_N)
/A1: J1.4, U1.40 (GPIO2/ADC1_CH1)
/A2: J1.5, U1.13 (GPIO3/ADC1_CH2)
/A3: J1.6, U1.4 (GPIO4/ADC1_CH3)
/A4: J1.7, U1.5 (GPIO5/ADC1_CH4)
/A5: J1.8, U1.6 (GPIO6/ADC1_CH5)
/A6: J1.9, U1.7 (GPIO7/ADC1_CH6)
/A7: J1.11, U1.12 (GPIO8/ADC1_CH7)
/A8: J1.12, U1.15 (GPIO9/ADC1_CH8)
/A9: J1.13, U1.16 (GPIO10/ADC1_CH9)
/A10: J1.14, U1.17 (GPIO11/ADC2_CH0)
/A11: J1.15, U1.18 (GPIO12/ADC2_CH1)
/A12: J1.16, U1.19 (GPIO13/ADC2_CH2)
/A13: J1.17, U1.20 (GPIO14/ADC2_CH3)
/A14: J1.18, U1.9 (GPIO16/ADC2_CH5/32K_N)
/A15: J1.20, U1.10 (GPIO17/ADC2_CH6)
/AUDIO: J1.49, R7.2
/CAS: J1.41
/D0: J1.21, U1.35 (GPIO38), U2.7 (GPIO7/ADC1_CH6)
/D1: J1.22, U1.36 (GPIO39/MTCK), U2.8 (GPIO15/ADC2_CH4/32K_P)
/D2: J1.23, U1.37 (GPIO40/MTDO)
/D3: J1.24, U1.38 (GPIO41/MTDI)
/D4: J1.25, U1.39 (GPIO42/MTMS)
/D5: J1.26, R13.2, R15.2, U1.43 (GPIO43/U0TXD)
/D6: J1.27, R12.2, R16.2, U1.42 (GPIO44/U0RXD)
/D7: J1.28, U1.30 (GPIO45)
/EXTDEC: J1.38
/EXTSEL: J1.2, U1.28 (GPIO47), U2.6 (GPIO6/ADC1_CH5)
/GND: J1.1, J1.10, J1.19, J1.29, J1.30, J1.32, J1.42, J1.45, J1.50, J2.6, J4.4, J5.4, J7.2, J7.16, U1.22 (GND), U1.23 (GND), U1.24 (GND), U1.44 (GND), U2.22 (GND), U2.23 (GND), U2.24 (GND), U2.44 (GND)
/IRQ: J1.35, U1.34 (GPIO37)
/J5_RXD: J5.5, R16.1
/J5_TXD: J5.3, R15.1
/LINK_BCLK: U1.29 (GPIO48), U2.16 (GPIO10/ADC1_CH9)
/LINK_RX: J3.3, U2.14 (GPIO46)
/LINK_TX: J5.6, U1.31 (GPIO0), U2.15 (GPIO9/ADC1_CH8)
/MAIN_EN: J5.1, U1.3 (CHIP_PU), U2.17 (GPIO11/ADC2_CH0)
/MPD: D2.1 (K), J1.43, U1.14 (GPIO46)
/MPD_LED: D2.2 (A), R17.2
/NC1: J1.33
/NC2: J1.37
/NC3: J1.39
/PHI2: J1.31, U1.33 (GPIO36), U2.4 (GPIO4/ADC1_CH3)
/RAS: J1.44
/READ: J1.46, U1.8 (GPIO15/ADC2_CH4/32K_P), U2.5 (GPIO5/ADC1_CH4)
/READY: J1.36, U1.11 (GPIO18/ADC2_CH7), U1.32 (GPIO35)
/REFRESH: J1.40, J3.1, J8.1, U2.10 (GPIO17/ADC2_CH6)
/RESET: J1.34, R1.2
/RESET_DRV: J9.1, R1.1
/SC_3V3: J2.4, J7.1, R2.1, R3.1, R4.1, R5.1, R6.1, U2.1 (3V3), U2.2 (3V3)
/SC_5V: J4.2, J10.2, U2.21 (5V)
/SC_AUDIO: R7.1, U2.28 (GPIO47)
/SC_BOOT: J4.6, U2.31 (GPIO0)
/SC_EN: J4.1, U2.3 (CHIP_PU)
/SC_FLASH_RX: R13.1, U2.19 (GPIO13/ADC2_CH2)
/SC_FLASH_TX: R12.1, U2.18 (GPIO12/ADC2_CH1)
/SC_IO3: J7.5, U2.13 (GPIO3/ADC1_CH2)
/SC_IO8: J7.6, U2.12 (GPIO8/ADC1_CH7)
/SC_IO14: J7.7, U2.20 (GPIO14/ADC2_CH3)
/SC_IO18: J7.8, U2.11 (GPIO18/ADC2_CH7)
/SC_IO19: J7.3, U2.25 (GPIO19/USB_D-)
/SC_IO20: J7.4, U2.26 (GPIO20/USB_D+)
/SC_IO21: J7.9, U2.27 (GPIO21)
/SC_IO35: J7.10, U2.32 (GPIO35)
/SC_IO36: J7.11, U2.33 (GPIO36)
/SC_IO37: J7.12, U2.34 (GPIO37)
/SC_IO38: J7.13, U2.35 (GPIO38)
/SC_IO45: J7.14, U2.30 (GPIO45)
/SC_IO48: J7.15, U2.29 (GPIO48)
/SC_RXD: J4.5, U2.42 (GPIO44/U0RXD)
/SC_TXD: J4.3, U2.43 (GPIO43/U0TXD)
/SD_CLK: J2.5, U2.38 (GPIO41/MTDI)
/SD_CMD: J2.3, R2.2, U2.39 (GPIO42/MTMS)
/SD_DAT0: J2.7, R3.2, U2.37 (GPIO40/MTDO)
/SD_DAT1: J2.8, R4.2, U2.36 (GPIO39/MTCK)
/SD_DAT2: J2.1, R5.2, U2.41 (GPIO1/ADC1_CH0)
/SD_DAT3: J2.2, R6.2, U2.40 (GPIO2/ADC1_CH1)
/U1_GPIO19: J9.2, U1.25 (GPIO19/USB_D-)
/U1_GPIO20: J8.2, U1.26 (GPIO20/USB_D+)
/U1_GPIO21: J3.2, U1.27 (GPIO21)
/VCC50_1: J1.47, J5.2, J10.1, U1.21 (5V)
/VCC50_2: J1.48

Notes on the sheet:
Sidecar (U2) wiring: docs/sidecar_wiring.pdf. Link: LINK_TX (U1 GPIO0 -> U2 GPIO9), LINK_RX (U2 GPIO46 -> J3 pin 3), LINK_BCLK (U1 GPIO48 -> U2 GPIO10). J3 selects U1 GPIO21 (U1_GPIO21, pin 2): jumper 1-2 = PBI RFSH (REFRESH), 2-3 = Sidecar link RX (LINK_RX). Changed from espBusBang: U1 GPIO0 no lo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

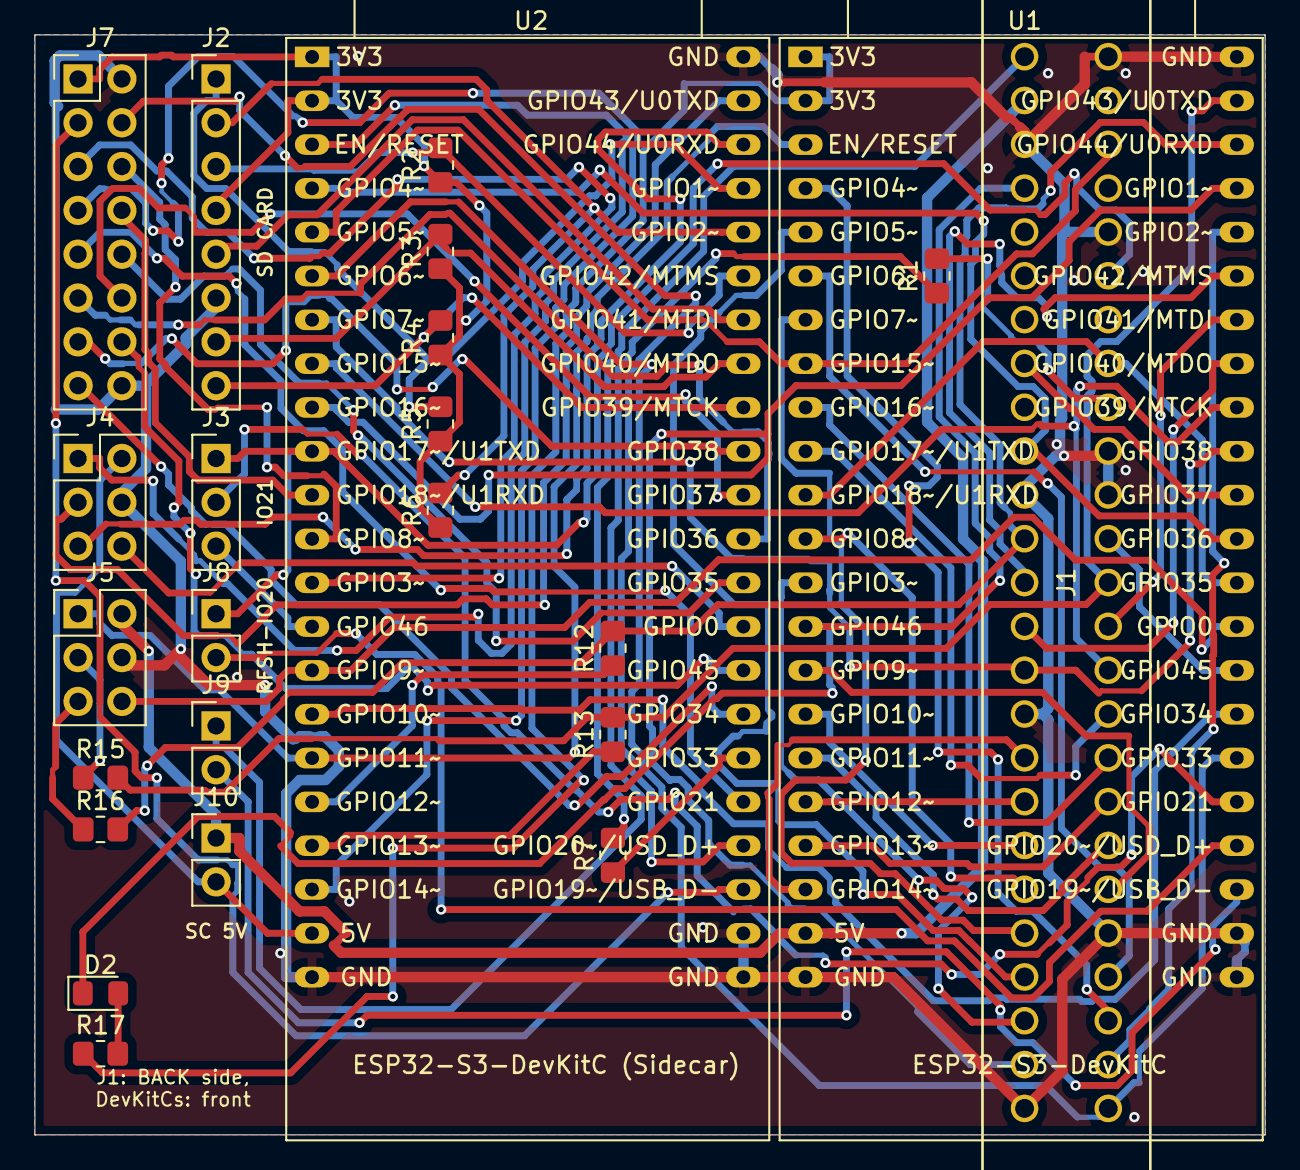
[picture p7: board espBusBangSidecar.kicad_pcb from above]

Board: 2 copper layers, 71.3 x 63.8 mm, 24 parts (0 on the bottom side), 75 nets.
