cowlove/atari8EspBusBang/main/asmDefs.h

//#define HW_600XL
;;// trying to run HW_600XL on 800XL demonstrates a repeatRead timeout very reliably 

#ifdef HW_600XL
#define HALT_6502
#define PERM_EXTSEL
#else
#undef HALT_6502
#undef PERM_EXTSEL
#endif

//#define PERM_EXTSEL


;;// flags for ESP32_IOCB_REQ
;;//////////////////////////////
#define REQ_FLAG_NORMAL       1             // 
#define REQ_FLAG_DETACHSAFE   2         // 6502 is ready for bus detach 
#define REQ_FLAG_COPYIN       4             // data has been copied in per ESP32_IOCB_COPYBUF/LEN
#define REQ_FLAG_STACKWAIT    8

;;// flags for ESP32_IOCB_RESULT
////////////////////////////////
#define RES_FLAG_COMPLETE         1           // command complete
#define RES_FLAG_NEED_DETACHSAFE  2    // re-issue command, need REQ_FLAG_DETACHSAFE
#define RES_FLAG_NEED_COPYIN      4        // re-issue command, need copyin from ESP32_IOCB32_COPYBUF and REQ_FLAG_COPYIN
#define RES_FLAG_COPYOUT          8            // command complete, data is in ESP32_IOCB_COPYBUF for copyout 
#define RES_FLAG_PROBE_SKIP       16           // PBICMD_PROBE_BEGIN: not an AUTO-memory config, skip the probe
#define RES_FLAG_MONITOR          128            // immediately reissue monitor command, repeat until clear 

#define REQ_MAX_COPYLEN 1024

#define PBICMD_WAIT_VBLANK        10
#define PBICMD_INTERRUPT          11
#define PBICMD_UNMAP_NATIVE_BLOCK 12
#define PBICMD_REMAP_NATIVE_BLOCK 13
#define PBICMD_PROBE_BEGIN        15   // memory probe: swap in the probe map
#define PBICMD_PROBE_REPORT       16   // memory probe: results are in the overlay; restore the map
#define PBICMD_NOP                30
#define PBICMD_SET_MONITOR_BOOT   31


#define NATIVE_BLOCK_ADDR 4096
#define NATIVE_BLOCK_LEN 2048

#define PBIROM_BASE 55296             //;; 0xd800
#define DISABLE_BASIC 55328           //;; 0xd820
#define DEVNAM 'J'     //;device letter J drive in this device's case
#define PDEVNUM 2       //;Parallel device bit mask - $2 in this device's case.  $1,2,4,8,10,20,40, or $80   
