cowlove/atari8EspBusBang/components/sidecar_link/sidecar.cpp

// Link protocol v2: see sidecar.h and docs/sidecar-link-v2.md.

#include "sidecar.h"
#include "esp_attr.h"

#include <algorithm>
#include <cstdio>
#include <cstring>

#include "esp_random.h"
#include "esp_timer.h"
#include "sdkconfig.h"
#ifdef CSIM
#include <zlib.h>
#else
#include "esp_cpu.h"
#include "esp_rom_crc.h"
#endif

// The host side's clock: CCOUNT, which touches no bus. esp_timer_get_time()
// reads the SYSTIMER peripheral (a snapshot write, a poll, three reads),
// and on the host every peripheral access from core 0 can delay the core 1
// bus loop's own GPIO register accesses; i2slink itself times with CCOUNT
// too. csim has no CCOUNT: it counts esp_timer microseconds. The 32-bit
// count wraps after about 17 s at 240 MHz, so timeouts must stay below
// that (or be I2SLINK_WAIT_FOREVER).
namespace {
#ifdef CSIM
constexpr uint32_t kTicksPerUs = 1;
inline uint32_t ticksNow() { return static_cast<uint32_t>(esp_timer_get_time()); }
#else
constexpr uint32_t kTicksPerUs = CONFIG_ESP_DEFAULT_CPU_FREQ_MHZ;
inline IRAM_ATTR uint32_t ticksNow() { return esp_cpu_get_cycle_count(); }
#endif

// Microseconds left of timeoutUs since start (0 when it has run out);
// I2SLINK_WAIT_FOREVER stays forever.
inline IRAM_ATTR uint32_t remainingUs(uint32_t start, uint32_t timeoutUs)
{
    if (timeoutUs == I2SLINK_WAIT_FOREVER) {
        return I2SLINK_WAIT_FOREVER;
    }
    const uint32_t elapsedUs = (ticksNow() - start) / kTicksPerUs;
    return elapsedUs < timeoutUs ? timeoutUs - elapsedUs : 0;
}

constexpr size_t kLinkBytes = sizeof(SidecarLinkHeader);

inline IRAM_ATTR SidecarLinkHeader *linkOf(uint8_t *frame)
{
    return reinterpret_cast<SidecarLinkHeader *>(frame);
}
inline IRAM_ATTR SidecarHeader *headerOf(uint8_t *frame)
{
    return reinterpret_cast<SidecarHeader *>(frame + kLinkBytes);
}

// How long a side answering a command waits for the peer to ack its
// previous frame. The peer acks as it reads, so normally it already has.
constexpr uint32_t kRespondAckUs = 5000;

// The Test object's token (its CRC32), computed once at begin(): the host
// answers ReadVersion for it from the hot path, with no time for 100 KB.
DRAM_ATTR uint32_t testObjectVersion = 0;
}  // namespace

uint32_t sidecarCrc32(uint32_t crc, const uint8_t *data, size_t length)
{
#ifdef CSIM
    return static_cast<uint32_t>(crc32(crc, data, static_cast<uInt>(length)));
#else
    return esp_rom_crc32_le(crc, data, length);
#endif
}

IRAM_ATTR uint8_t sidecarTestObjectByte(uint32_t offset)
{
    return static_cast<uint8_t>((offset * 31u + 7u) ^ (offset >> 8) ^ (offset >> 16));
}

// ---------------------------------------------------------------------------
// SidecarPeer: the shared engine
// ---------------------------------------------------------------------------

esp_err_t SidecarPeer::begin(const i2slink_config_t &config, SidecarRole role)
{
    if (link_) {
        return ESP_ERR_INVALID_STATE;
    }
    if (testObjectVersion == 0) {
        uint32_t crc = 0;
        uint8_t block[256];
        for (uint32_t offset = 0; offset < kSidecarTestObjectBytes; offset += sizeof(block)) {
            const uint32_t n = std::min<uint32_t>(sizeof(block), kSidecarTestObjectBytes - offset);
            for (uint32_t i = 0; i < n; ++i) block[i] = sidecarTestObjectByte(offset + i);
            crc = sidecarCrc32(crc, block, n);
        }
        testObjectVersion = crc;
    }
    role_ = role;
    loopback_ = config.loopback;
    primed_ = false;
    havePeer_ = false;
    pendingValid_ = false;
    busy_ = 0;
    // Random starts, so a frame or response left on the wire from before
    // this end restarted can't match a new one.
    nextSequence_ = esp_random();
    txSeq_ = static_cast<uint16_t>(esp_random());
    peerSeq_ = 0;
    peerAck_ = static_cast<uint16_t>(txSeq_ - 1);
    const esp_err_t err = i2slink_init(&link_, &config);
    if (err != ESP_OK) {
        return err;
    }
    // The first frame: Idle (nothing in it needs protecting, so the first
    // real frame needn't wait for its ack).
    memset(tx_, 0, sizeof(tx_));
    SidecarLinkHeader *link = linkOf(tx_);
    link->version = kSidecarProtocolVersion;
    link->mode = static_cast<uint8_t>(SidecarMode::Idle);
    link->frameSeq = txSeq_;
    link->ackSeq = peerSeq_;
    i2slink_write(link_, tx_);
    return ESP_OK;
}

void SidecarPeer::end()
{
    i2slink_deinit(link_);
    link_ = nullptr;
}

IRAM_ATTR bool SidecarPeer::pump(uint32_t waitUs)
{
    lastStatus_ = i2slink_read(link_, rx_, nullptr, waitUs);
    if (lastStatus_ != I2SLINK_NEW) {
        return false;
    }
    const SidecarLinkHeader *link = linkOf(rx_);
    if (link->version != kSidecarProtocolVersion) {
        ++versionMismatches_;   // an old (v1) or newer peer: not ours to answer
        return false;
    }
    peerAck_ = link->ackSeq;
    if (havePeer_ && link->frameSeq == peerSeq_) {
        return false;   // the same frame, rewritten with a new ack
    }
    havePeer_ = true;
    peerSeq_ = link->frameSeq;
    // Ack it at once: a rewrite of our current frame with the new ackSeq
    // (not a new frame, so always allowed).
    linkOf(tx_)->ackSeq = peerSeq_;
    i2slink_write(link_, tx_);
    return true;
}

// A command read while waiting: the host ignores it (it has priority); the
// Sidecar keeps it in pending_ to serve, and its own command is abandoned.
// True if this side must yield.
IRAM_ATTR bool SidecarPeer::noteIncomingCommand()
{
    if (role_ != SidecarRole::Subordinate) {
        return false;
    }
    memcpy(pending_, rx_, sizeof(pending_));
    pendingValid_ = true;
    ++preempted_;
    return true;
}

IRAM_ATTR bool SidecarPeer::waitForAck(uint32_t timeoutUs)
{
    if (linkOf(tx_)->mode == static_cast<uint8_t>(SidecarMode::Idle)) {
        return true;   // nothing to protect
    }
    const uint32_t start = ticksNow();
    while (peerAck_ != txSeq_) {
        const uint32_t remaining = remainingUs(start, timeoutUs);
        if (remaining == 0) {
            return false;
        }
        if (pump(remaining) && !loopback_ &&
            linkOf(rx_)->mode == static_cast<uint8_t>(SidecarMode::Command) &&
            noteIncomingCommand()) {
            return false;   // yield
        }
    }
    return true;
}

IRAM_ATTR void SidecarPeer::writeNewFrame(SidecarMode mode)
{
    SidecarLinkHeader *link = linkOf(tx_);
    link->version = kSidecarProtocolVersion;
    link->mode = static_cast<uint8_t>(mode);
    link->frameSeq = ++txSeq_;
    link->ackSeq = peerSeq_;
    i2slink_write(link_, tx_);
}
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
