cowlove/atari8EspBusBang/(commit log)

2025-07-03 Fixed up gnuplot this examplary build so that it compiles, maybe start a branch
    [ascii2keypress.h, bin2src.py, espEmptyTemplate.ino, pbirom.h]
2025-07-15 Move esp32 project into esp32/. Add tools/ directory
    [partitions.csv]
2025-07-16 Work with stock makeEspArduino and arduino-esp32
2025-07-16 Cleanup, ready to try and swap clock and interrupt pin assignments
    [atari8EspBusBang.ino, core1.cpp]
2025-07-16 Unsuccessful experiment swapping clk and interrupt pins, but checked in some cleanups anyway. Seems that BOTH the clock pin is slightly incompatible with the neopixel on pin 48 and the interrupt line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
    [atari8EspBusBang.ino]
2025-07-16 cleanup ascii art pin diagram
2025-07-19 First stab at new scheme avoiding REMAP command. Seems to work, but RTCLK may be inaccurate due to missed VBI interrupts. Next need to work on scheme to time/avoid unmapping during VBI interrupts
    [atari8EspBusBang.ino, pbirom.asm, pbirom.h]
2025-07-19 Turn off SDMCTL during IO to avoid antic DMA. IO is about 123/iteration
    [atari8EspBusBang.ino, pbirom.asm, pbirom.h]
2025-07-19 Move to new pin layout with readwrite pin lined up for easy address decoding
2025-07-20 Don't print blank psram
2025-07-26 switch to pbi device #2
2025-07-27 changes for investigating interrupt hangs
2025-07-28 lots torn apart investigating interrupt hangs
2025-08-01 Move to idf. Compiles and flashes, but 6502 hangs
    [partitions.csv]
2025-08-03 Move stuff to arduinoLite.h
2025-08-03 Disable interrupts until we inderstand the core1 loop disruption
2025-08-03 Try dedic_gpio to interrupt pin to try and avoid disrupting core1 loop
    [atari8EspBusBang.cpp, core1.cpp]
2025-08-03 Fix bogus output in psramDump
    [atari8EspBusBang.cpp]
2025-08-03 sdkconfig changes: reduce FREERTOS_HZ to 1000 to avoid interrupt delays turn off optimizations
    [atari8EspBusBang.cpp]
2025-08-04 Back out interrupt changes
2025-08-04 Re-enable new interrupt dedic_gpio scheme, but use open drain output
2025-08-04 Fix typo, interrput pin dedic_gpio was associated w/ core1
    [atari8EspBusBang.cpp]
2025-08-04 Switch back to using pinMode() rather than gpio_config
2025-08-04 dedic_gpio interrupt pin doesn't work yet, keep using explicit pin disable
    [atari8EspBusBang.cpp]
2025-08-04 Seems dedic_gpio call resets pinMode
    [atari8EspBusBang.cpp]
2025-08-04 Still trying to get dedic_gpio interrupt working, old clearInterrupt code still enabled
2025-08-05 Introduce pinDisableMask and pinEnableMask to allow interrupt pin to be set by the core1 loop
2025-08-05 Fixes to get pinEnableMask working on HW
    [atari8EspBusBang.cpp, core1.cpp]
2025-08-05 Try interrupts
2025-08-05 Remove pinEnable, instead change all busEnable lines. Re-enable interrupts
2025-08-05 When triggering an interrupt, only change pinEnableMask for page 1 rather than all the pages
2025-08-05 Testing boot stability, no interrupts and 300 sec runtime
    [atari8EspBusBang.cpp, core1.cpp]
2025-08-05 back out busMask changes, seems to be causing crashes, now runs to 300sec 10 time and counting
    [atari8EspBusBang.cpp, core1.cpp]
2025-08-05 again remove busMask, replace the delay with one additional nop
    [core1.cpp]
2025-08-06 Tuned loops, probed timing limits. Seems to run for 300sec, testing with bmon and interrupts now
2025-08-06 Good build, runs 900sec 4+ times, with interrupts and bmon active.
2025-08-06 Fix bug where bmon channel changes were never noticed
    [atari8EspBusBang.cpp]
2025-08-07 Got long interrupt handler working, runs 10 minutes 4+ times
2025-08-07 Introduce optional safewait, only called for io commands that need to enable interrupts or use flash
2025-08-07 Introduce scoped interrupt enable
2025-08-07 Move all bmon trace computations to the idle time at the top of core1 loop
2025-08-07 enable interrupts inside interrupt handler, add "screen X" serial command
2025-08-07 Fix typo that broke the build
    [atari8EspBusBang.cpp]
2025-08-09 print HATABS table on exit
2025-08-09 Add HATABS device driver entry twice- xdos2.51 likes to overwrite the first one
2025-08-09 Move back to spartados until we can figure out point errors
    [atari8EspBusBang.cpp, pbirom.asm, pbirom.h]
2025-08-11 Got turbobasic running, seems DMACTL was what was breaking it, not interrupts
2025-08-12 disabling the bus during psram disk reads seemed to fix the atari error 138 problems, now runs 2 hours 3+ times
    [atari8EspBusBang.cpp]
2025-08-12 disable bus even for sram-based disk IO, seems to fix timeouts. Has run 90 minutes 1 time still running
    [atari8EspBusBang.cpp, pbirom.asm, pbirom.h]
2025-08-13 Hangs with interrupts
2025-08-13 Still only runs 5-10 minutes with interrupts, std basic
2025-08-13 Interrupts enabled, doesn't immediately hit stackprog timeout like before
    [atari8EspBusBang.cpp, pbirom.asm, pbirom.h]
2025-08-13 Fix ascii art pin diagram. Change run time to 15 minutes
2025-08-13 Clear the bmon buffer after *all* pbi commands. Assumes no critical writes to 0xd1ff or PORTB happen via a 6502 interrupt while the 6502 PBI driver is busy waiting on pbiRequest->req
2025-08-14 Avoid disabling bus just to make a serial print. Seems to allow code to run on new hardware, 3+ minutes with interrupts
    [atari8EspBusBang.cpp, pbirom.asm]
2025-08-14 Enable ROM BANKSEL pages, trust page mappings to avoid conflict with atari ROM reads
    [atari8EspBusBang.cpp]
2025-08-14 BANKSEL_ROM and BANKSEL_RAM are mapped identically, setting the stage for them to be removed. All ROM conflicts are handled by memory mapping
2025-08-15 Fix bug: dont set stack-resident req value in shortwait case
    [atari8EspBusBang.cpp, pbirom.asm, pbirom.h]
2025-08-15 Add hotkey for extending/resetting the watchdog timer
    [atari8EspBusBang.cpp]
2025-08-15 Fixed but with onMmuChange cleanup, now boot tbasic but hangs at first command
    [atari8EspBusBang.cpp]
2025-08-15 Holy shit boots and runs turbo basic! Extending the pbiROM mapping all the way to 0xdfff seemed to fix it
    [atari8EspBusBang.cpp, pbirom.asm, pbirom.h]
2025-08-16 Consolidated bankD100 and bankD300 ram into one bank of ram for registers. Variable page sizes now work. Interrupts and 0xd1ff reads require pages <= 256 bytes but without interrupts, page sizes from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
2025-08-16 Add periodic screenshot. Increase D1 write length, trying to investigate ERROR - 136 hangs
    [atari8EspBusBang.cpp]
2025-08-16 Add TODO comment for XE bank switching
2025-08-16 Open-drain data pins doesn't work- comment out
    [atari8EspBusBang.cpp]
2025-08-17 XE bank switching ramdisk stress test runs about 1-2 minutes, then corrupts the basic program, probably under OS ram due to slow bank switching. Going to go back and confirm tbasic tests
2025-08-17 Got it booting with tbasic again. Problems writing to lfs-backed D2 but otherwise going to leave it running for the night
    [atari8EspBusBang.cpp]
2025-08-17 Turn on interrupts
2025-08-18 As -noserialzevolatile gcc option to global project fix mon profiling, was double counting fix bench runtime error
    [atari8EspBusBang.cpp]
2025-08-18 Got interrupts working with 2k bank size.
2025-08-18 log max bmon trace
2025-08-18 bmon trace only looking for 0xd301 writes that unmap OS
2025-08-18 Fix data mask in bmonTrig spec
    [atari8EspBusBang.cpp]
2025-08-19 Rough ideas for cartridge simulation - doesn't work
    [atari8EspBusBang.cpp, joust.h]
2025-08-19 Testing pins for new esp32
2025-08-22 Cartridge mapping works. Boots Joust and Assembler editor. Cannot bank switch fast enough for banked cartridges. Getting ready to explore enabling READY line to pause 6502 for bank switches
2025-08-22 Add better bmon tracking, fix output printf errors. SDX boots and interacts, need to develop a stress test that runs under SDX
    [atari8EspBusBang.cpp]
2025-08-22 Switch back to 2k pages
2025-08-23 Got CompyShop 192K bank switching working, freed up enough memory to run this with SDX
2025-08-23 Runs basic, still doesn't seem to load the "J:" program.
    [atari8EspBusBang.cpp]
2025-08-24 Investigating halting the 6502 instead of stack_prog wait. Doesn't work yet, halt is commented out
    [atari8EspBusBang.cpp, pbirom.asm]
2025-08-25 Switched to SPIFFS. Needs a patched components/spiffs/esp_spiffs.c
2025-08-25 Verify that tcp connection is maintained during periods of ESP interrupts disabled
2025-08-25 More sketched in code for running a web server. Seems to work once IO or interrupts are enabled.
2025-08-25 lwip takes about 88k of dram. Only enough for base XE and wifi. Pluse httpd_server crashes when you try and use it
    [atari8EspBusBang.cpp]
2025-08-25 Build problems, keeps setting FAKE_CLOCK
    [atari8EspBusBang.cpp, wifi.cpp]
2025-08-25 httpd_server runs, but doesn't leave enough memory for SDX or RAMBOXL drive, so need to redo some test scripts
    [atari8EspBusBang.cpp]
2025-08-26 Delay connectWifi until first 6502 interrupt is received. turbo-basic stress succesfully responds to httpd requests for the first time
2025-08-26 Wait longer for core1 to stabilize. 15m+ running
    [atari8EspBusBang.cpp]
2025-08-27 Trying to sort out why heavy esp32 interrupt traffic and wifi blows up core0 bmon loop timing so bad
2025-08-27 Remove printf
2025-08-27 Some wild changes trying to investigate core0 bmon loop timing issues. Looks like some sdkconfig changes for a newer idf version
    [atari8EspBusBang.cpp]
2025-08-27 Fix D000Bank size from 0x600 to 0x800. Writes past 0x600 would have been overwriting D000BankRead, probably wouldn't cause a crash- but.
    [atari8EspBusBang.cpp]
2025-08-27 Print config.sys at the start of x.bat
2025-08-28 Pinpointed broken. Seems to be very odd and sensitive relation to where exactly the main wait loop is placed in memory
    [atari8EspBusBang.cpp, atari8EspBusBang.ino, pbirom.asm, pbirom.h]
2025-08-28 Roll back to d4edd, then add nop fix
    [atari8EspBusBang.cpp, pbirom.asm, pbirom.h]
2025-08-28 First stab at fixing mmu mapping for smaller base memory sizes
    [atari8EspBusBang.cpp, pbirom.asm, pbirom.h]
2025-08-28 Fix 16bit addr overflow in mmu, wouldn't boot
    [atari8EspBusBang.cpp]
2025-08-28 basemem 16 boots, but ramdisk corruption hints theres some problems with the bank switching falling through to the Atari8 natural ram
    [atari8EspBusBang.cpp]
2025-08-29 Arrange for copyout for dumpScreenToSerial() at least in the J1:DUMPSCREEN-triggered case
2025-08-29 Added notes explaning the bug regarding bank switching with less than 32K base ram
    [atari8EspBusBang.cpp]
2025-08-29 Fix bug that was preventing 256B pages
    [atari8EspBusBang.cpp]
2025-08-29 Fix minor problems that would prevent 128B page sizes
    [atari8EspBusBang.cpp]
2025-08-30 cache works! dosx runs 20+m. Lots if impact on the bmon timing traces even when no evictions are taking place, need to investigate
2025-08-30 Move extMem stuff to its own module. Add 0xd800 base ram to avoid write corruption. Experiment with adding extSel on writes to avoid trashing native ram, but it doesn't work. extSel is probably not a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
    [atari8EspBusBang.cpp, core1.cpp]
2025-08-31 Better error handling for SMB connection
    [atari8EspBusBang.cpp]
2025-08-31 Apply bmonExclude() to bmon crash dump
    [atari8EspBusBang.cpp]
2025-08-31 Introduce a really broken, grotty telnet server for GRAPHICS 0 mode. Doesn't handle screen scrolling yet
    [ascii2keypress.h, atari8EspBusBang.cpp, telnet.cpp]
2025-08-31 Fixes to telnet server.
    [telnet.cpp]
2025-09-02 Cleanup of pinDefs.h using new Pin template struct
2025-09-02 Cleanup printfs
2025-09-04 Back out SMB testing until better error handling
    [atari8EspBusBang.cpp]
2025-09-04 quiet down smb logging, make EVERYNTICKS increment lastTsc rather than reset it
    [atari8EspBusBang.cpp, diskSmb.h]
2025-09-04 Create pinchanges branch, try to get LED working
2025-09-04 Got LED working, added some color indication for pbi requests and disk io
2025-09-04 Add scrolling detection to telnet.cpp. Works, with glitches.
    [telnet.cpp]
2025-09-04 Change LED status color scheme
2025-09-07 Keep interrupts disabled over entire handlePbiRequest Do not halt 6502 for pbiRequests back to 5 bit pagrNr for faster mmu
2025-09-07 Back to 5-bit page numbers, bit some bugs that prevented 2k pages
    [atari8EspBusBang.cpp]
2025-09-07 Reduce timeouts, typo with procfs mount point
2025-09-08 Initial working version of ProcFS. Mounted D4:, add test
2025-09-08 Boots from power switch with no external USB power!
2025-09-08 Think we found the resume6502() glitch.
    [atari8EspBusBang.cpp]
2025-09-08 Add printf for copyin/out
2025-09-09 Add on/off stress script for just power cycling sonoff
2025-09-09 Reduce extMem banks to 1, force lots of swapping. Trying to figure out why xdos doesn't boot with > 40K basemem. Something with basicEn
    [atari8EspBusBang.cpp]
2025-09-09 Fix typo that broke SDX build
    [atari8EspBusBang.cpp]
2025-09-09 Try moving atariRam from static array to heap_cap_alloc, to get better alignment for DMA. Doesn't look like DMA will be useful anyway
    [atari8EspBusBang.cpp]
2025-09-10 Undo dma changes. They weren't useful, and the atariRam changes seem to completely break core1 loop
    Revert "Try moving atariRam from static array to heap_cap_alloc, to get better alignment"
    This reverts commit bb7b27251ab6940cd45dd379157c6b65509eeb58.
    [atari8EspBusBang.cpp]
2025-09-11 Fixed mmu corner cases w/ pbi, POST. Fixes bug where POST wouldn't run with baseMemSz > 0x4000. TurboBasic still will not boot if baseMemSz > 0xa0000.
    Checked in code with baseMemSz 64K, only boots SDX. Changed to HALT_6502 wait
    strategy to try and get 600XL to boot. 600XL boots to SDX, but seems to be
    using native ram despite permanent-extSel
    [atari8EspBusBang.cpp, core1.cpp, extMem.h, pbirom.asm, pbirom.h]
2025-09-11 Found commit 1810cdd2a that booted SDX on the 600xl. Merge in changes from that commit: 600xl boots SDX, but does not like interrupts. See notes
2025-09-11 Tried switching to 256b pages and supporting 0xd1ff reads, thinking that perhaps that was what was causing interrupt loops. But still get stack exhaustion at first interrupt
2025-09-11 Set PDIMSK in PBI_INIT and leave it set, don't enable/renable in raise/clear interrupt
2025-09-12 Change x.bat to print screen to capture mem output
2025-09-14 Changes investigating HALT_6502 failures. This seems to run for a while, even though it uses HALT_6502, but immediately re-enables resume6502 and then does stack wait. Seems to imply the 6502 either 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
    [atari8EspBusBang.cpp, pbirom.asm, pbirom.h]
2025-09-14 LOLLL.. Had bus.extsel polarity backwards. But it still worked?!?! 3.3V must have worked as logic-low?
2025-09-15 Better- PERM_EXTSEL, including during busDetach Full HALT_6502 SHORTWAIT
    [atari8EspBusBang.cpp, pbirom.asm, pbirom.h]
2025-09-15 automatic detection of halted 6502 in bmon loop Move keypress handling back into bmon loop from interrupt spot
2025-09-15 Add #error for PERM_EXTSEL requiring baseMemSz == 64K
    [atari8EspBusBang.cpp]
2025-09-16 New PCB pin assignments
2025-09-16 Re-write of core1 loop to avoid the main if(read) {} branch. All R/W logic now handled by page table entries
    [atari8EspBusBang.cpp, core1.cpp]
2025-09-16 pragma away the missing field initializer warnings
    [wifi.cpp]
2025-09-16 Better debugging output trying to track down HW problem w/ new batch of devkit boards
    [atari8EspBusBang.cpp, pbirom.asm]
2025-09-16 Disable PAGESEL_VID for now, some of the hardware doesn't have pin 18 hooked up
    [core1.cpp]
2025-09-16 Revert core1.cpp,h to a6dbbab1b. New changes didn't work on 800xl
    [core1.cpp]
2025-09-16 Print out MAC address on boot
2025-09-18 More sysMonitor work. Breaks esp32 build, need to break code into more .cpp modules
2025-09-18 Fix copyout bug in prev commit
    [csim.h, sysMonitor.cpp]
2025-09-18 Add mdump commands to x.bat to try and track down screen glitches
    [sysMonitor.cpp]
2025-09-18 Try clearing interrupts for a while between sysMon callbacks
2025-09-18 Fixed memory problems by making pinRelease WAYYY earlier in core1 loop
    [atari8EspBusBang.cpp, core1.cpp, pbirom.asm, sysMonitor.cpp]
2025-09-21 Only add bus detach for serial prints
2025-09-21 Moved back to just empty unmap/remap calls, but now won't run interrupts
    [atari8EspBusBang.cpp, pbirom.asm]
2025-09-21 Kinda works, shows correct content, but very jittery. Maybe need to synch with vblank for writing $d402
    [pbirom.asm]
2025-09-21 Tried vblank sync, but didn't really help
    [atari8EspBusBang.cpp, pbirom.asm]
2025-09-21 Fixed bug where pbi->cmd was being used instead of ->req when looking for flags
    [atari8EspBusBang.cpp, pbirom.asm]
2025-09-21 native block map/unmap works pretty good. Fixed screen memory errors, still the occassinal glitch, but pressy solid
    [pbirom.asm, sysMonitor.cpp]
2025-09-21 Remove copyin/out printf
2025-09-21 Fixes for sysMon cart menu
    [atari8EspBusBang.cpp, sysMonitor.cpp, sysMonitor.h]
2025-09-21 Wire in config
2025-09-22 Boots cartridge. Currently no way to get back in monitor once a non-DOS cartridge has been selected.
2025-09-22 revert back to old interrupt startup at 20 sec
    [atari8EspBusBang.cpp]
2025-09-22 Change IRQ startup logic to avoid cartridge boots
    [atari8EspBusBang.cpp]
2025-09-22 Swapping carts works, OPT+SEL reboot works
    [atari8EspBusBang.cpp, pbirom.asm, sysMonitor.cpp]
2025-09-22 Add radio button interface to sysMonitor menu
2025-09-22 Delay wifiRun() until 20 seconds & interrupt, or in first use
2025-09-22 Shuffle around header files to fix build problems
    [atari8EspBusBang.cpp, diskSmb.h, telnet.cpp, util.h]
2025-09-23 Added sysMon menu for interrupt and sysmon intervals, but onKey() doesn't work in hardware yet because we dont have keypress2atascii array ugh
    [ascii2keypress.h, atari8EspBusBang.cpp, sysMonitor.cpp]
2025-09-23 Fix ISR freq calculation, was off by 10
    [atari8EspBusBang.cpp]
2025-09-23 Fix incorrect interrupt frequency
    [atari8EspBusBang.cpp, sysMonitor.cpp]
2025-09-26 Boots, but hangs and errors
    [atari8EspBusBang.cpp, pbirom.asm]
2025-09-26 Still broken, comparing to master-tbasic
    [core1.cpp]
2025-09-26 Revert "Still broken, comparing to master-tbasic"
    Undo mistaken commit to master. This should have been to master-tbasic2
    This reverts commit bd7207cfff7df15f4495d0c026958290a13e9f3a.
    [core1.cpp]
2025-09-26 Revert "Boots, but hangs and errors"
    Accidental commit to master
    This reverts commit 24d98de8a680eff30bff05883da900ec7ef396cd.
    [atari8EspBusBang.cpp, pbirom.asm]
2025-09-26 Increase baseRam to 48K, revert core1.cpp changes
    [core1.cpp]
2025-09-26 Put back missing pbirom.asm COLDST and PBIMSK changes
    [pbirom.asm]
2025-10-01 Introduce defines for disabling basic from the esp32
2025-10-01 Fling around tons of DRAM_ATTR and IRAM_ATTR in .cpp files, didn't change anything
    [const.h, log.h, main.cpp, mmu.cpp]
2025-10-03 Add #pragma O1 for all new files, didn't help. Add template for parameterized "nops"
    [bmon.h, cartridge.h, core1.cpp, extMem.h, mmu.h, pinDefs.h, util.h]
2025-10-04 Rework core1 loop to try and adhere to bus timing docs. Running xdos 6+ min
    [core1.cpp]
2025-10-04 Move extSel to the pinReleaseClockHi Add printfs for drying to debug tbasic pbi rom conflict
2025-10-04 Revert "Experiment trying separate clock phase hi/lo pinRelease values"
    This reverts commit a3e4a87de998327a601e6b4cdd816d6d0833e49a.
    [core1.cpp, main.cpp, mmu.cpp, mmu.h]
2025-10-05 Fix typo in mmuCheckMapped, caused screen prints to fail
    [mmu.cpp]
2025-10-05 Sketched in atariCarts bank mmu, but swapping cartridges at the BankL1 level doesn't work yet
    [main.cpp, mmu.cpp]
2025-10-05 Sketch in BankL1-based cartridge and build-in basic swapping. Doesn't work and currently ifdef'd out
    [mmu.cpp, mmu.h]
2025-10-05 Clean up mmuAllocAndMap base ram a little bit. Fixed a bug where this function allocated but diddn't actually map the RAM. Don't know if it was causing problems. Added comments
    [mmu.cpp]
2025-10-05 Revert "Pre-compute nextBmonHead"
    This reverts commit 5ecfdce409794063fa06c43a59eba666385b1e3e.
    Must be too much register pressure, this change actually slowed things
    down by a couple ticks
    [core1.cpp, mmu.cpp]
2025-10-05 Fixed bugs in BankL1 mapBankRW/etc. Now boots sdx/dosx
    [mmu.cpp]
2025-10-05 Try and sketch in BankL1 cartridge bank switching code directly into bmon loop.
    Doesn't yet work
    [main.cpp]
2025-10-05 shortcutting the cartridge mapping in the bmon loop works
    [main.cpp]
2025-10-06 Doessn't boot w/ BankL1 cartridge swapping without halt, SDX behaves oddly
    [main.cpp, mmu.h]
2025-10-06 Reworking core1.cpp loop. Loop that appears to be stable based on NOP timings instead of while(tsc) loop
    [core1.cpp, profile.h, util.h]
2025-10-07 Weird combo that almost boots SDX. Errors in basic parsing
    [core1.cpp]
2025-10-07 Revert "Blindly move pageData = statement to after REG_WRITE"
    This reverts commit 31e02f6ac6faf7284ee8ab5ee5b66a39314f8b5b.
    [core1.cpp]
2025-10-07 Cleanup. Added missing DRAM_ATTR on new arrays in core1.cpp
    [core1.cpp, mmu.h]
2025-10-07 Change the core1.cpp lastBank array to track writes, not reads.
2025-10-07 First sketchy attempt at plumbing together the core1 based immediate cartridge bank switching
2025-10-07 Move back to testbank[] while debugging some problems
    [core1.cpp]
2025-10-07 dosx (no cart) works with new core1.cpp cartridge bank switching
2025-10-07 Still need to completely unmap base ram for swapping basic in/out Otherwise core1 bank switching will switch back to base ram even if basic is enabled
    [mmu.cpp]
2025-10-07 Disable PAGESEL_VID for now, cutting all the page/bank table size in half. Fixes memory exhaustion in SDX build when trying to use wifi.
    [cartridge.cpp, cartridge.h, core1.cpp, mmu.cpp, mmu.h, util.h]
2025-10-07 Increase profiling to 1024 buckets
2025-10-07 Fix bmon unsigned error
    [main.cpp]
2025-10-11 Make benchmark and trace scripts leave copies indexed by branch and commit. Add power_on and power_off
2025-10-12 Fix bug where bmon was written before write data. Now 600XL runs SDX 1+m
    [core1.cpp]
2025-10-15 remove power_off from bench.sh
2025-10-15 replace tbasic with a llvm compiled autorun.sys
    [main.cpp, mmu.h]
2025-10-15 hello.c changes, fix spiffs.sh
    [hello.c]
2025-10-15 Add a delay after re-enabling the OS to prop up the 130xe
2025-10-16 Sketched in, basic switching works for mapping read pages. Up against tight limits in core1.cpp
    [core1.cpp, hello.c, mmu.cpp, mmu.h]
2025-10-16 trying OS switching in core1.cpp, but having problems with pbi rom.
    [core1.cpp, mmu.cpp]
2025-10-17 16K pages seems to work, basic bank switching doesn't work even on 600XL
    [core1.cpp, hello.c, mmu.cpp, mmu.h]
2025-10-17 Turn back on basic switching in hello.c test script. Misses a handful of times each iteration but runs
2025-10-17 Remove scattered-about #pragma O1, compile main.cpp at Ofast, seems to reduce the number of basic switching misses
2025-10-17 Use while() loop for delay in core1.cpp. Doesn't work very well on 130xe
    [core1.cpp]
2025-10-19 Only write reg1 if it's a read. Explicitly tsc time the reg1 read for writes. Seems to get S2 running. 130xe still won't boot
    [core1.cpp]
2025-10-20 PROF2 was in the wrong spot
    [core1.cpp]
2025-10-20 Fix bugs in cartridge memory mapping, made esp32 crash any time a cart was selected
    [cartridge.cpp]
2025-10-20 Use config for interruptTicks and sysMonitorSec
2025-10-20 Comment out interrupt ticks
2025-10-20 reduce interrupts to every 2 seconds in BASIC config
2025-10-21 tons of cartridge fixups, now doesnt boot anything on s2
    [cartridge.cpp, cartridge.h, main.cpp, mmu.cpp, mmu.h, sysMonitor.cpp]
2025-10-21 Fix typo that mapped the 8k banks of a 16K cart twice
    [cartridge.cpp]
2025-10-23 Turn off interrupts and set run time to 2h for HELLO_CART config
2025-10-23 make HELLO_CARTINT target with interrupts
2025-10-25 hello.c: disable resetWdt() and 0xd1ff = 0
    [hello.c]
2025-10-25 Make sure BOOT_CONFIG "" sets zero interrupts, for bench.sh tests
2025-10-27 Fix dump bmon trace, was still using bmonShift
    [main.cpp]
2025-10-28 Investigate why osMux with OS disabled entries doesn't work
    [mmu.cpp]
2025-10-28 Disable shortcut J: open/close. Seems to crash on enabling serial output though
    [pbi.cpp]
2025-10-28 enabling the periodic serial output seems to cause problems, but enabling CIO file open printf() seems OK (?)
    [hello.c, pbi.cpp]
2025-10-28 Fix bug on mapping of 0xd500 page, shouldn't have caused any problems yet
    [mmu.cpp]
2025-10-28 Re-enable interrupts for HELLO config
2025-10-29 130 boots SDX but crashes in about 1 min, extMem is disabled, 130 native bank mem seems to work
    [main.cpp, pbi.cpp, sysMonitor.cpp]
2025-11-13 remove CIO printfs, add DOS25 config option
2025-11-15 Add commented-out notes for bank40 switching in core1.cpp
2025-11-15 Move towards a bus disable/enable based on mmu page settings rather than globals. Interrupts probably don't work yet
2025-11-16 Remove unused references to volatile globals, replace with 4 nops.
    [core1.cpp]
2025-11-16 Found the halt6502() call that was causing problems
    [main.cpp, mmu.cpp]
2025-11-16 More cleanup, replace pinReleaseMask with constexpr
    [main.cpp, mmu.h]
2025-11-16 move back mem write pin release by one statement
2025-11-16 Increase repeatRead start time to 20 sec, was triggering before 6502 even powered up
2025-11-18 Boots SDX, doesn't seem to recognize compy192 Not enough mem to run compy192 and wifi
    [core1.cpp, extMem.h, main.cpp, mmu.cpp, mmu.h, pbi.cpp, sysMonitor.cpp]
2025-11-18 More fixes for shutdown crash
    [main.cpp]
2025-11-19 Re-implement interrupts with mmu-based bus control lines
2025-11-19 Enable interrupts for SDX
2025-11-20 First stab at getting halt_ based 800xl memory swapping going again
    [extMem.h, main.cpp, main.h, mmu.cpp]
2025-11-20 Avoid call to mmuOnChange before mmuState.extMem is initalized
    [mmu.cpp]
2025-11-20 Fix logic bug, was still crashing
    [mmu.cpp]
2025-11-22 Got halt working, psram/sram swapping doesn't seem to work yet
    [main.cpp, mmu.cpp]
2025-11-22 Boots Rambo256 on 800xl w/ 2K base ram, but l1 bank mmu data structures take up about 64K of memory and it no longer can boot networking
    [extMem.h, main.cpp, mmu.cpp, mmu.h]
2025-11-22 Changes to make new extmem branch boot on xe. Need BOOT_CONFIG switches
2025-12-08 Revert "Commend out accidental sdmactl = 0 in dev branch"
    This reverts commit 73b35de4116599e72065990fb2c35153ca103aed.
    [hello.c]
2025-12-09 Fix typo in smb2 error log
    [diskSmb.h]
2025-12-12 Revert "lead-in nops 3->0"
    This reverts commit c3f5f384ee38d03b538cc93cfd5f69cd01f94722.
    [core1.cpp]
2025-12-18 Print mmu state each screen dump
2025-12-18 fix extmem issues w 600xl
    [extMem.h, mmu.cpp]
2025-12-19 Fix bug with IO to extMem. Now direct IO to extMem works
    [extMem.h, main.cpp, mmu.cpp, mmu.h, sysMonitor.cpp]
2025-12-19 more fixes for mmuCheckMapped function to work with extMem
    [mmu.cpp, mmu.h, pbi.cpp, telnet.cpp]
2025-12-20 leadin nops 0 doesn't even boot, back to leadin nops 2
    [core1.cpp]
2026-10-08 Add debug printf showing TEST_HW_ID.
2026-10-10 Change simplemem to use fakeCio rather than 0x0600 watchdog reset
    [pbi.cpp, simplemem.c, sysMonitor.cpp]
2026-10-11 switch .2 to STRESS
2026-10-13 Remove pbi delay that was the reproducing-case for the iram contention investigation
2026-10-13 Revert back to "by-chance" placement of core0 hotspots, with layout validated by linker verification tool. Implemented explicit placement plan, but it is currently disabled.
2026-10-13 Enable interrupts on SDX_600XL boot
2026-10-13 Re-enable LED on the esp32
2026-10-13 Port all .asm files over to use llvm-mos assembler instead of xa This should remove the project dependence on xa
2026-10-14 Mount host ccache cache dir into podman image. Add more required software packages to setup-build-env.sh
2026-10-15 Add hardware kicad files
2026-10-15 Add .jpg of the esp32 board pinout
2026-10-15 Add link to board pinout in hardware README.md
2026-10-15 Add LCD_CAM DMA startup POC (AI generated)
2026-10-15 Add LCD RGB DMA completion counter (AI generated)
2026-10-15 Add pinless I2S DMA smoke test (AI generated)
2026-10-15 Route I2S BCLK to onboard LED pin (AI generated)
2026-10-15 Stream base RAM directly via I2S DMA (AI generated)
2026-10-17 ideas for independent DMA loop output
2026-10-18 Restore TAS-based MQTT power topics
2026-10-19 Add interruptStartDelay and wifiStartDelay config parameters
2026-10-19 Investigating extmem bank switching faults with interrupts enabled
2026-10-19 Revert "Investigating extmem bank switching faults with interrupts enabled"
    This reverts commit 15f742ac0e9f212b39538aa755742960a3bdf60a.
2026-10-19 Fix typo that prevented STRESS_MC boot from enabling interrupts
2026-10-19 Add prototype call to J1:LOG to log errors
2026-10-19 Capture staged changes in boot snapshots
2026-10-20 Add hand-coded assembly bankStress() routine in stress.c
2026-10-20 Add PROTECT1 macro to control interrupt masking during banking stress Increase extMem bank stress iterations
2026-10-20 First stab at assembly bankStress function, but it fails on the first iteration
2026-10-20 Switch to XE bank switching for stress.c. TODO: support auto-detection of existing bank scheme in stress.c
2026-10-20 Disable fake CIO injection during bench/profile runs Switch back to uncompressed stress.car to make running in emulator easier
2026-10-20 Fix typo in stress.c assembly
2026-10-20 Added delays to stress.c to figure out how much delay is required to get ext bank switching to work. Seems 4 NOPS
2026-10-20 print heap caps on exit. Add a 6-NOP delay to allow stress.c to run on 600XL
2026-10-20 Make bankStress assembly use 0xe3/0xe7 portb ext mem instead of 0x83/0x87 This seems to let it pass
2026-10-20 Removed NOP delays from stress.c 600XL now runs cleanly with interrupts but no HALT, pointing at some interaction between interrupts, HALT, and extended memory banking
2026-10-20 Back out accidental change disabling interrupts in STRESS_MC
2026-10-20 Print better stack debugging on exit
2026-10-21 Switch to -Ofast for core1.cpp, plus comment changes
2026-10-21 Commit PCBWay gerber zips
2026-10-21 Change logs from ESP_LOGI to printf()
2026-10-22 Clean up fusepy scripts, make it use ../../main/diskImage.h, etc
2026-10-22 Add LOOP to autoexec.bat fusepy stress test
2026-10-22 Change to generic DiskStitcherImage pointer, setting up for mounting different types of DiskImages other than smb
2026-10-22 Handle fuse mount with resource types smb:// and proc://
2026-10-22 Renaming cleanup for fusepy,hello_fuse csim code. Now "dstitch"
2026-10-23 Readonly mount of SDFS image works in csim/dstitch simulation. Add long filename collision aliasing.
2026-10-23 Add SDFS create write POC and trace overlay
2026-10-26 Changes to let CSIM build and simulate interrupts and basic disk IO
2026-10-26 Add Atari800 cycle and interrupt hooks
2026-10-26 Hack up pbirom.asm, share the same PBI cmd channel for interrupts, temporarily disable monitor mode.
2026-10-26 Perfect for showing SDX sensitivity to interrupts.
2026-10-26 config changes to mount SDX_hdd.img
2026-10-26 remove confusion about partition number vs mounted "drive number". Implement $46 SIO command for DDEVIC $20
2026-10-26 Handle $46 for mounted drives
2026-10-26 Support up to 16 mounted drives
2026-10-26 Add $53 status bit for $20/$a0 devices
2026-10-26 Pre-mount a partition as per the APT table. Implement drive mapping
2026-10-27 Remove all the #include *.cpp files at the bottom of main.cpp, include them as their own compilation units. This was originally documented as required to get whole-prog optimization for core1.cpp, bu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
2026-10-27 Restore interrupts for CSIM build
2026-10-28 Guard experimental I2S TX DMA engine
2026-10-30 Change profiling bus sample point to 45
2026-10-31 Add rw pin profiling
2026-10-31 Add clock in to profiling sample
2026-10-31 Re-enamble RW pin toggling for profile modes
2026-11-01 Wire in actual libsmb2 to csim emulation
2026-11-02 Switch dev 3 back to SDX_600XL testing
2026-11-05 First stab at porting to ESP-IDF v6.1
    Experimental port from the pinned IDF 5.5 to v6.1, built against
    ~/opt/esp-idf-v6.1 with the existing SPIFFS fs-by-label patch applied
    (tools/container/patches/spiffs-fs-by-label.patch, unchanged). The
    container/native setup pins in tools/container are not yet updated.
    - main/CMakeLists.txt: esp_hw_support/dma moved to esp_driver_dma. Add
    esp_driver_dma (esp_async_memcpy) and move the driver-private I2S/GDMA
    include paths into the CONFIG_A8BB_I2S_TX_DMA_ENGINE block, the only
    code that uses them.
    - Replace removed rom/gpio.h gpio_matrix_in/out with
    esp_rom_gpio_connect_in_signal/out_signal (same arguments, also
    available in 5.5).
    - arduinoLite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
2026-11-05 csim: pin libsmb2 submodule to libsmb2-6.2
    Match the firmware component, which setup-build-env.sh pins to
    d67e213 (the libsmb2-6.2 release tag), so CSIM exercises the same
    libsmb2 code as the ESP32 build. Moves back from 38b5edf, which was
    121 commits past 6.2.
    Existing checkouts must remove csim/a800/build-libsmb2 to rebuild the
    shared library; the CSIM Makefile does not track the submodule commit.
2026-11-05 Update vendored rfc2217-server 0.3.0 -> 0.4.0, keeping local patches
    Upstream 0.4.0 fixes (header/API unchanged):
    - Escape IAC (0xFF) bytes in rfc2217_server_send_data. telnet.cpp
    sends screen text through it and never sends raw telnet commands, so
    this only prevents data bytes being misread as commands.
    - Purge: reply once, with the on_purge callback result (we pass NULL).
    - Log the accepted, not requested, baud rate.
    Local modifications carried forward unchanged (not upstream):
    - On client connect, send WILL ECHO and WILL SGA to request
    character-at-a-time client behavior.
    - Add rfc2217_server_disconnect_client(), which shuts down the client
    socket so the receive thread runs its d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
2026-11-05 Pin build environment to ESP-IDF v6.1
    - setup-build-env.sh: pin v6.1 (fff9895) and install to
    ~/opt/atari8esp-idf-v6.1 so it coexists with the 5.5 checkout at
    ~/opt/atari8esp-idf. v6.1 needs no submodule overrides; the overrides
    file now allows comments. The idf phase scrubs any inherited ESP-IDF
    environment (e.g. a sourced 5.5 export.sh) so install.sh cannot
    install 6.1 Python requirements into the 5.5 venv.
    - container.sh: image tag 6.1-fff9895-llvm-mos. build and flash always
    delete .container-build first, avoiding stale CMake caches that point
    at another image's toolchain; clean/fullclean just remove it on the host.
    - export_build_env.sh: prefer the 6.1 installs.
    - Update R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
2026-11-05 run_capture: only inventory recently modified untracked files
    Long-running test hosts can have hundreds of thousands to millions of
    untracked, non-ignored files (e.g. a stash.OLD log archive), and hashing
    each one with a per-file sha256sum loop made every capture take hours.
    Hash only untracked files modified within RUN_CAPTURE_UNTRACKED_MAX_AGE_DAYS
    (default 7; "all" restores the old behavior), and record the total and
    inventoried counts in the metadata. Snapshot git status with
    --untracked-files=normal so wholly untracked directories collapse to one
    line.
2026-11-06 Sidecar: optional coprocessor link over i2slink (A8BB_SIDECAR_ENABLE)
    Adds the i2slink hands-free I2S DMA link (from i2sDmaSenderBench 0167b64)
    and a command/response protocol on top of it for an optional second
    ESP32 coprocessor:
    - Sidecar (host side): begin/end, probe() (Nop handshake, presence),
    nop/sio/cio transactions. Each command is written once and the
    response is matched on command byte + sequence.
    - SidecarService (Sidecar side): non-blocking service() for an outer
    loop, with stub SIO and CIO handlers. It drops the first command
    after begin() so a restart never repeats a command; probe()'s Nops
    absorb that.
    - Messages: SidecarHeader {command, sequence, flags}, then Atari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
2026-11-06 Sidecar app project and shared sidecar_link component
    - components/sidecar_link: i2slink, i2s_dma_ring and the Sidecar
    protocol, moved out of main/ so both apps share one copy. Its CMake
    finds the private GDMA header on IDF 5.5 and 6.x.
    - atariStructs.h: AtariDCB and AtariIOCB moved out of main.h (which
    includes it) so the Sidecar app can use them without the host's
    headers; csim Makefiles get the include path.
    - sidecar/: a separate IDF project for the Sidecar ESP32, built with the
    host's IDF (tools/export_build_env.sh; idf.py -C sidecar build). It
    links only sidecar_link and runs SidecarService::service() in a
    non-blocking core-1 loop with stub SIO/CIO handlers and a 1 s stat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
2026-11-06 Remove the experimental I2S TX DMA engine (A8BB_I2S_TX_DMA_ENGINE)
    The direct-from-atariRam I2S streaming proof of concept is superseded by
    the Sidecar link (components/sidecar_link). Removes the Kconfig option,
    main/i2s_dma_poc.{c,h}, its startup code in main.cpp, the EOF counter
    in the serial status line, the LED guards that kept the RMT LED off
    GPIO48 while it ran, the public esp_driver_i2s / esp_hw_support/dma
    include dirs it needed, and its csim stubs (including the i2s_std.h stub
    header). docs/VGA_IDEA.md now points at the history.
    atariRam keeps its 16-byte-aligned DMA-capable allocation.
    Claude-Session: https://claude.ai/code/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
2026-11-06 Restore the status LED on GPIO48 when the pin is free
    d4c4520 gave GPIO48 to GPIO profiling and turned the LED off for every
    build. ledPin is now 48 (HAS_STATUS_LED 1) unless GPIO48 is taken: by
    GPIO profiling (PROFILE_MODE GPIO or PIN, i.e. PROFILE_GPIO_SAMPLE) or
    by the Sidecar link (A8BB_SIDECAR_ENABLE). LEGACY profiling doesn't use
    the pin.
    GPIO profiling and the Sidecar can't be combined: CMake stops at
    configure time (PROFILE_MODE is a CMake option, out of Kconfig's
    reach), with an #error in pinDefs.h as a backstop, and the Kconfig help
    says so.
    Claude-Session: https://claude.ai/code/session_01KzPLu6X7tkLHVWEELsKDNN
2026-11-06 csim: run the Sidecar app inside the emulator over a simulated i2slink
    The csim boundary is i2slink.h. i2slink_csim.cpp implements it with
    shared buffers: each write expands the real framed cycle (hsync, tag,
    T/payload/CRC/H) and lands it in the peer's RX ring with a random bit
    shift, so the real lock/search/decode code runs. No timing or wire-delay
    model; the loop stays cooperative and single-threaded.
    - i2slink_wire.h: wire layout and framing/decode helpers shared by the
    hardware i2slink.c and the csim implementation (hardware logic unchanged).
    - sidecar/main: app loop split into sidecarApp.{h,cpp} (begin/poll) so
    csim can embed it; main.cpp keeps the core-1 polling task.
    - main/sidec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
2026-11-06 Sidecar: add a status byte to the frame header
    Both directions keep the same frame: {command, sequence, flags, status}.
    Commands send status 0 (transact() zeroes it). Responses start with
    status 0 and the handler may set it; service() still restores command,
    sequence and flags so they are always echoed, but keeps the handler's
    status. Meaning is per command; nothing sets it yet. The raw data area
    shrinks by one byte (SIO 285, CIO 281; a 256-byte sector still fits).
    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
2026-11-06 TMP: add sidecar.probe() to core0 utility loop
2026-11-06 Sidecar: bench pins, per-second report, Nop counter
    - pinDefs.h: under A8BB_SIDECAR_ENABLE, the host's hardware data pins
    are now TX GPIO0 / RX GPIO21, matching the i2sBench wired pair (BCLK
    stays GPIO48). Provisional: GPIO21 is the Atari refresh_ input, so this
    is for bench smoke tests with no Atari attached.
    - SidecarService::handleNop() is a virtual hook with an empty default.
    - Sidecar app: counts Nop/SIO/CIO commands and logs once a second the
    per-second deltas (commands, frames rx/tx, read errors, framing, jumps)
    and totals.
    Verified on the wired S3 pair (host FAKE_CLOCK build via boot.sh):
    ~20 Nops/s answered from the core0 loop, no read errors.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
2026-11-06 Generate PBIROM_<label> addresses into pbirom.h from the assembler
    pbirom.h now carries, after the ROM bytes, a "#define PBIROM_<label>
    0xADDR" for every label in pbirom.asm (nm types t/T; the OS/hardware
    equates and llvm-mos __rom_* symbols are skipped), taken from the
    assembled ELF's symbol table. The bytes are guarded by
    #ifndef PBIROM_SYMBOLS_ONLY, so other files can include just the defines.
    - Makefile: keep pbirom.elf; pbirom.o65 is objcopied from it; pbirom.h
    is written via a .tmp and renamed.
    - pbi.cpp includes the symbols; the hand-calculated PBIROM_DUMMY_WRITE
    in asmDefs.h is gone (the generated value is the same, 0xd856).
    - .gitignore: main/pbirom.elf, main/pbirom.h.tmp.
    Co-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
2026-11-06 Move test sidecar.probe() into handlePbiRequest()
2026-11-07 Room for a full core dump; fix boot.sh hanging after the capture
    Core dump size. ESP_COREDUMP_CAPTURE_DRAM also walks every 8-bit heap,
    PSRAM included (heap_caps_walk(MALLOC_CAP_8BIT)), so a dump needs up to
    ~2.1 MB of PSRAM heap plus ~0.45 MB of DRAM; the 1 MB partition failed
    with "Not enough space to save core dump!".
    - partitions.csv: drop the unused ota_1 slot (nothing uses OTA); spiffs
    moves to 0x1F0000 (still 0x330000); coredump is 0x2E0000 at 0x520000,
    to the end of the 8 MB flash.
    - tools/partinfo.sh (new): print a partition's offset or size from
    partitions.csv. flash_spiffs.sh, dumplfs.sh, crash_bundle.sh and
    spiffs/Makefile (IMAGE_SIZE) use it instead of hard-coded values,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
2026-11-07 Panic hook: give the core dump 120 s before the RTC watchdog resets
    IDF arms the RTC watchdog for 10 s for the whole panic handler
    (port/panic_handler.c), and the core dump code does not feed it. Erasing
    and writing a DRAM + PSRAM-heap dump (~2.5 MB) takes longer, so the reset
    cut the dump short: the next boot found an erased ("ffff") checksum, and
    idf.py coredump-info rejected the image.
    __wrap_esp_panic_handler now re-arms it for 120 s (when core dumps are
    enabled) before calling the real handler, keeping it as a backstop for a
    hung handler. ESP_SYSTEM_PANIC_REBOOT_DELAY_SECONDS would also stretch it,
    but would delay every panic reboot by as long.
    esp_panic_handler_enable_rtc_wdt() is int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
2026-11-07 Reserve the DRAM the ROM uses to boot core 1 from the heap
    In single-core builds IDF recycles the ROM's reserved DRAM into the heap
    ("recycled by heap allocator in app_main task", heap/port/esp32s3/
    memory_layout.c). But startCpu1() resets core 1 through the ROM, which
    then runs on its APP CPU stack (.stack_app) and re-initializes its own
    data (.bss_ets ... .bss_xtos), writing over heap objects placed there.
    Seen as the reproducible FreeRTOS assert in xTaskRemoveFromEventList
    (tasks.c:3991, pxUnblockedTCB) on the first SMB read, from nvs_flash_init
    taking the partition-list lock: the core dump shows that mutex at
    0x3fcee360, with its xTasksWaitingToSend header at the ROM's
    _Pri_4/_Pri_5_Han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
2026-11-07 Start core0 threadFunc directly rather than creating a thread
2026-11-07 i2slink: keep the host's Sidecar path in IRAM and pace the poll loops
    The i2slink polling loops destabilized the core 1 bus loop through SRAM
    contention. Sidecar::probe/transact/nop/sio/cio were in flash; they are
    now IRAM_ATTR. i2slink_read() and i2slink_hint(), the tight loops, use
    SIDECAR_HOT_ATTR (sidecar_hot.h), which mirrors CORE0_HOTSPOTS_ATTR;
    main/link.lf maps libsidecar_link.a's core0_hotspots section to IRAM
    under CONFIG_A8BB_CORE0_HOTSPOTS_EXPLICIT_PLACEMENT.
    Both loops now pause with sidecar_nez_delay(SIDECAR_POLL_DELAY), a
    loopnez delay with no instruction fetch (10 iterations, ~0.08 us). In
    read() the pause is at the bottom of the loop: take_window() runs in the
    same pass tha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
2026-11-07 i2slink: rest after a failed search; log where the DMA memory landed
    A failed search decodes the ring snapshot at all 16 bit offsets, about
    half a millisecond of continuous SRAM traffic, and read() retried it
    back to back. With no lock there is no window to miss, so rest one wire
    cycle (sidecar_nez_delay, no instruction fetch) before the next
    snapshot; locking can come up to one cycle later.
    i2slink_init now logs the address and 32 KB SRAM bank (numbered as in
    tools/verify_iram_hotspots.py) of the link struct, the RX ring and the
    RX/TX descriptors, to check them against the banks the core 1 bus loop
    uses. i2s_dma_desc_span() reports a channel's descriptor span.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
2026-11-07 i2slink: print the SRAM placement line with printf
    The host runs with logging disabled, so ESP_LOGI never showed it.
    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
2026-11-07 core1: start the stack at the top of a static stack array
    app_cpu_init() loads app_cpu_stack_ptr into a1 as core 1's initial stack
    pointer, but it was the base of a heap_caps_malloc(4096) block. Xtensa
    stacks grow down, so every core 1 frame and register spill went into the
    memory below the block: its heap header and the end of the block before
    it, silently corrupting the heap.
    The stack is now a static 16-byte-aligned 4 KB array in internal .bss,
    and app_cpu_stack_ptr is its top. Being static also fixes its SRAM bank:
    the heap had put it right beside the i2slink buffers, so core 1's stack
    traffic shared a bank with core 0's link polling and DMA.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
2026-11-07 Keep i2slink's DMA memory in one SRAM bank; report hot data banks at boot
    The data-side counterpart of the IRAM hotspot separation: the core 1 bus
    loop's data should share no 32 KB SRAM bank with data core 0 hammers.
    i2slink: the IDF driver allocates each DMA descriptor separately, so the
    RX descriptors (polled by the tripwires, written back by the DMA every
    cycle) were scattered over banks 5..13. The ring attach functions can now
    adopt caller descriptors (i2s_dma_ring_release_descriptors() hands them
    back before the driver would free them), and the link struct holds both
    sets. The struct is allocated 4 KB-aligned, so everything the link's
    polling and DMA touch lands in exactly one bank; i2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
2026-11-07 hotData: report port_IntStack as info, not a collision
    Core 0 has interrupts masked whenever core 1 is running bus traffic, so
    its interrupt stack sharing a bank with core 1's tables is no contention.
    It is still printed, as class "info", but never checked.
    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
2026-11-07 Sidecar: time probe() and transact() with CCOUNT, not esp_timer
    esp_timer_get_time() reads the SYSTIMER peripheral (a snapshot write, a
    spin on its valid bit, three register reads). probe() and transact() called
    it several times per attempt, and on the host those peripheral accesses
    from core 0 delay the core 1 bus loop's GPIO register accesses: a probe()
    run while the 6502 was active destabilized core 1, while a raw
    i2slink_write()/i2slink_read() pair (timed with CCOUNT) did not.
    Both now measure their timeouts with esp_cpu_get_cycle_count() (one
    rsr.ccount, no bus access) and still hand the remaining time down to
    i2slink_read(), which does the waiting. csim, which has no CCOUNT, counts
    es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
2026-11-07 Post-link check: the Sidecar call chain stays in vetted IRAM, no peripherals
    tools/verify_core0_hot_calls.py walks the call graph down from
    Sidecar::probe/nop/sio/cio/transact and i2slink_read/write and fails the
    build on anything core 0 must not do while core 1 drives the bus:
    - IRAM code from outside libsidecar_link.a (per the link map): not
    vetted. This is what catches esp_timer_get_time(), which is IRAM and
    reads SYSTIMER through a pointer in RAM;
    - ROM routines off an allowlist (memcpy, memset, memmove,
    esp_rom_crc32_le, _xtos_set_intlevel);
    - flash or unknown call targets, and indirect calls whose l32r literal
    can't be resolved;
    - l32r literals holding a periph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
2026-11-07 Reclaim 13 KB of the ROM core 1 boot DRAM reservation
    The rom_app_cpu_boot span (0x3fceb710-0x3fceee34) is needed only while
    the ROM boots core 1. Once core 1 reaches app_cpu_main(), setup() hands
    all of it to the heap except .data_xtos (0x3fcedf60-0x3fcee378): core 1
    keeps the ROM's vectors, and faults dispatch through the tables there,
    so keeping them preserves the core 1 Guru report. That gives 13,068 of
    14,116 bytes back.
    This relies on measurements of the current ROM and IDF, so every boot
    checks them. The parts to reclaim are filled with a pattern before
    startCpu1(), and are reclaimed only if the pattern survives core 1's
    boot. -DROM_BOOT_PROBE=1..4 re-verifies the rest: ROM writes, h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
2026-11-07 Sidecar link loopback mode, for testing without a Sidecar
    i2slink_config_t.loopback: RX hears this end's own TX, so it expects its
    own tag; with rx_gpio == tx_gpio the data pad keeps its input enabled,
    as the shared BCLK pad already does. csim connects such a link to itself.
    In loopback every Sidecar call (probe(), nop(), sio(), cio()) gets its
    own command back as the response through the normal transact() path, so
    the host's real call sites can be exercised with no Sidecar board.
    Sidecar::loopbackCheck() goes further: a Nop with a fresh pseudo-random
    body, echoed byte for byte or SidecarResult::Mismatch. It is CCOUNT- and
    memory-only, and a root of the post-link hot-call check.
    CONFIG_A8B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
2026-11-07 Sidecar link: the host drives BCLK, so a wired pair is safe in loopback
    The host is now the clock source in every mode and the Sidecar
    follows. The host then drives the same two wires, BCLK and its own TX,
    whether it is talking to a Sidecar or looping back. So
    CONFIG_A8BB_SIDECAR_LOOPBACK no longer needs the Sidecar disconnected.
    A wired Sidecar still receives and executes the host's commands in
    loopback; its answers go out on its own TX wire, which the host then
    ignores.
    Both ends must be updated together: a new host with an old Sidecar
    would have both driving BCLK.
    Also fix the Sidecar app build, broken since 586c763: it never set the
    new i2slink_config_t.loopback field (-Werror=missing-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
2026-11-07 Status line: Sidecar link reads, new packets and faults
    Append "sidecar new T (D) err T (D)" to the periodic serial status line:
    NEW payloads and faulted reads (torn, CRC, no lock, stalled), total and
    since the last line, in the io: style. When there are new faults, add
    the per-kind breakdown for the interval. TIMEOUT doesn't count as a
    fault (a healthy link with nothing new). Skipped when the link never
    started. It runs in handlePbiRequest2(), with core 1 cold, and
    i2slink_stats() is a struct copy.
    Checked in csim:
    00:00:00 io: 0 (0) irq 0 halt 0 evict 0/0 sidecar new 3 (3) err 0 (0)
    Claude-Session: https://claude.ai/code/session_0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
2026-11-07 CRITCAL: enable sidecar loopback, enable unprotected sidecar.probe() in pbiRequest
2026-11-07 Sio: one diskSpec parser for the host and Sidecar drives
    Move the host's atariDisks[8] into a Sio class in components/disk_image,
    shared with the Sidecar app. Sio owns D1: through D8:. mount() parses every
    diskSpec (.atr, .atr.gz, spiffs:, smb:, proc:, and .img in csim), and
    unmount()/mountAll()/disk(n) go with it. Later it will also take over the
    SIO DCB handling from pbi.cpp.
    The only per-app parts are resources: setFs() for the SPIFFS volume,
    setNetworkUp() for smb: (the host passes wifiRun) and setProcFsNodes() for
    proc: (the host's files move to main/procFsNodes.h). mount() refuses a
    diskSpec whose resource the app has not supplied, with a message.
    The SMB and proc images move into th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
2026-11-07 Mount diskSpecs on the Sidecar with "sidecar!"
    The host now mounts its drives with mountDiskSpecs() (main.cpp), one level
    above Sio. It replaces Sio::mountAll(), which is removed. A diskSpec that
    starts with "sidecar!" goes, minus the prefix, to sidecar.mount(); the rest
    go to sio.mount(). It runs right after sidecarHostSetup(), so the link is up
    and probed first.
    Sidecar::mount(unitId, diskSpec) sends a new Mount command
    (SidecarCommand::Mount = 3). Its body is SidecarMountBody { unit, reserved }
    and it carries the diskSpec NUL-terminated in the data bytes. The unit is
    1-based, as in the DCB's DUNIT. The reply status is a SidecarMountStatus
    (Mounted, Failed or BadRequest). mount() waits up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
2026-11-07 SidecarHost: the host's layer over the Sidecar link
    The Sidecar protocol (components/sidecar_link) is shared with the Sidecar
    app. What only the host does with it now lives in a SidecarHost class
    (main/sidecarHost.h/.cpp), so host types such as PbiIocb and the DCB stay
    out of the shared code.
    - SidecarHost owns the Sidecar link object. sidecarHost.begin() replaces
    sidecarHostSetup(), and the status line and hot-data check reach the link
    through sidecarHost.sidecar().
    - sidecarHost.mount() wraps Sidecar::mount() and keeps a uint32_t bit
    vector of the DUNITs the Sidecar has mounted. A unit's bit is set only
    when the Sidecar reports it mounted, and cleared on unmount or failure.
    moun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
2026-11-07 Sidecar app: its own proc: disk (LOG, and HALT in csim)
    The Sidecar app gives its Sio its own proc: files, separate from the
    host's (main/procFsNodes.h), so "sidecar!proc:" mounts now:
    - LOG, copied from the host: a write prints "LOG: '...'".
    - HALT, csim only: a write sets the host's exitReason and exitFlag = -5,
    as the host's HALT does. csim runs the Sidecar app in the host's
    process; the node and its extern declarations are #ifdef CSIM.
    Tested in csim: with SDX_CSIM (run.sh), D3: sidecar!proc: mounts and the
    script's LOG writes arrive. A HALT written from the SDX prompt (temporary
    boot input) ended the run with exit reason -5.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
2026-11-07 Plain .atr disks without PSRAM, and flash_spiffs.sh --plain-atr
    For boards without PSRAM, such as an octal-PSRAM module whose PSRAM pins
    the Sidecar link uses:
    - Sio::mount() copies a plain .atr into PSRAM only when there is PSRAM
    (heap_caps_get_free_size(MALLOC_CAP_SPIRAM) > 0). Otherwise
    DiskImageATR uses it in place on SPIFFS, so writes persist across
    reboots. An .atr.gz without PSRAM fails with "no PSRAM to inflate it
    into (a plain .atr works without)". Nothing changes where there is
    PSRAM: the host, csim and quad-PSRAM boards.
    - spiffs/Makefile builds spiffs-plain.bin: everything in spiffs.bin, plus
    an uncompressed .atr beside each .atr.gz that has no plain one (d1, d2,
    d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
2026-11-08 SidecarHost: check the live mmuState for SIO buffers
    The Sidecar shortcut runs with the bus attached, but it checked
    mmuStateSaved, which only disableBus() refreshes. PORTB and $D1FF writes
    since the last detach change the live mapping, so a buffer could look
    mapped when it wasn't: no copy-in or copy-out, and the data went to ESP
    RAM the Atari never sees.
2026-11-08 Free disk images on unmount: DiskImageATR/IMG destructors
    Sio::unmount() deletes the old image on every remount, and the Sidecar
    gets a Mount for each drive on every host boot. Without destructors, a
    plain .atr kept its SPIFFS file open (the Sidecar allows 5) and a PSRAM
    copy was never freed, so remounts after a few host reboots failed.
2026-11-08 StructLog: fixed ring buffers, and log the Sidecar's requests
    StructLog used a std::deque, whose push_back/pop_front allocate and free
    through flash code: unsafe on core 0 with core 1 hot. It is now a fixed
    array with a head and count (size a template parameter) and add() calls
    nothing. print() notes when entries were dropped.
    SidecarHost::handlePbiRequest() now logs each DCB into the shared DCB
    log as it arrives, and the PbiIocb as it returns (result, req flags,
    copybuf/copylen) into a new "Sidecar PBI log", to follow the copy-in and
    copy-out path on hardware. The SIO handling itself moves unchanged to
    handleSio().
2026-11-08 SidecarHost: log PORTB, buffer and data per Sidecar SIO request
    A new fixed ring, structLogs->sidecarSio, records for each request the
    Sidecar handled: unit, command, sector, Atari buffer and length, the
    last PORTB ($D301) and $D1FF writes, the result and DSTATS returned,
    whether the data went straight to the mapped buffer or through
    pbiROM[0x400], the ESP address used, and the first 16 data bytes sent
    or returned. It prints after the Sidecar PBI log.
    This is to check whether a buffer in the $4000 bank window that the
    live mmuState reports as mapped is really what the 6502 reads.
    add() stays a plain copy: safe with core 1 hot.
2026-11-08 Sidecar app: report slow SIO commands and failed writes
    Prints any SIO command that takes over 50 ms (the host times out and
    shows the Atari 138 past its limit), with its status and DSTATS, and a
    failed sector write with SPIFFS_errno(), as failed reads already do.
2026-11-08 Sidecar link: wait through link faults, 2 s SIO timeout, log link status
    - Sidecar::transact() returned LinkFault as soon as i2slink_read()
    reported TORN, CRC, NO_LOCK or STALLED (after sync_timeout_us, about
    four wire cycles), however much of the timeout was left. The link
    keeps resending the command and stale replies are ignored by
    sequence, so keep waiting until the deadline and report the last
    fault only if time runs out. probe() still bounds each try.
    - kSioTimeoutUs: 500 ms -> 2 s, for in-place SPIFFS writes that
    trigger garbage collection on the Sidecar.
    - The sidecarSio ring records lastLinkStatus() per request, so a 138
    shows whether it was a timeout or a link fault.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
2026-11-08 spiffs: expand only PLAIN_ATRS in spiffs-plain.bin, check free blocks
    --plain-atr expanded every .atr.gz. On miner6 that included the 1.4 MB
    toolkit.atr, which left 6 of 816 blocks erased. SPIFFS rewrites a sector
    into new pages and garbage-collects the old ones, so every Sidecar write
    failed with SPIFFS_ERR_FULL (-10001) while reads kept working.
    PLAIN_ATRS (default "d1 d2") now names the disks to expand, and a missing
    one is an error. After spiffsgen runs, the build counts the image's erased
    blocks, prints them, and fails (deleting the image) below MIN_FREE_BLOCKS
    (default 32, 128 KB).
2026-11-08 Re-add sidecar.probe() call in handlePbiRequest for loopback mode
2026-11-08 Disable all struct logs, investigating instability in test device 5 and 6
2026-11-08 Allocate structLogs in internal RAM, assert it
    Plain new put StructLogs in PSRAM: CONFIG_SPIRAM_MALLOC_ALWAYSINTERNAL
    is 0, so every malloc prefers PSRAM. Core 0 adds to these rings with
    core 1 hot, and a PSRAM access goes through the cache and the MSPI bus
    that core 1 shares. That is the likely cause of the instability on test
    devices 5 and 6 that 809b496 worked around by turning the logs off.
    Allocate it with heap_caps_malloc(MALLOC_CAP_INTERNAL | MALLOC_CAP_8BIT)
    and placement new, assert esp_ptr_internal() at boot, and leave the logs
    off with a message if internal RAM runs out. This turns the logs back on.
2026-11-08 Remove the CIO opens struct log
    StructLog<std::string> opens was the one struct log whose add() could
    allocate: building and assigning a std::string mallocs (in PSRAM, with
    CONFIG_SPIRAM_MALLOC_ALWAYSINTERNAL at 0) and frees for any name longer
    than 15 characters. Remove it along with its print overload. StructLog
    entries are now plain structs only, as the log.h comment now says.
2026-11-08 Move the structLogs allocation into structLogsInit(), call commented out
    structLogsInit() allocates the logs in internal RAM and asserts it, as
    setup() did directly. The call in setup() is commented out for now, so
    the logs stay off while test devices 5 and 6 soak-test that turning
    them off (809b496) is what cured the instability.
2026-11-08 bench-idf.sh: build in build-bench/ with the Sidecar off
    The project's sdkconfig now turns the Sidecar on, and the bench profiles
    need GPIO48, the link's BCLK, so the bench build stopped. Turning the
    option off in sdkconfig would rebuild all of IDF on every switch.
    The script now builds in build-bench/, whose own sdkconfig is generated
    from the project's sdkconfig plus sdkconfig.bench (CONFIG_A8BB_SIDECAR_ENABLE
    off). Each build directory stays incremental, and the bench's cached -D
    options (BOOT_CONFIG, FAKE_CLOCK, PROFILE_*, RUN_SEC) no longer end up in
    build/. IDF reads SDKCONFIG_DEFAULTS only when it creates an sdkconfig,
    so the script regenerates build-bench/sdkconfig whenever the chec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
2026-11-08 Drop bus.refresh_ from Sidecar builds, gate its uses on HAVE_REFRESH
    The guard on bus.refresh_ tested A8BB_SIDECAR_ENABLE, without the CONFIG_
    prefix. Nothing defines that name, so refresh_ (GPIO21) existed in Sidecar
    builds too, where GPIO21 is the link's RX.
    pinDefs.h now defines HAVE_REFRESH unless CONFIG_A8BB_SIDECAR_ENABLE is
    set, and declares refresh_ only with it. Its uses are gated on it:
    - main.cpp: bmonLog()'s refresh filter, the empty refresh branch after
    the bmon halt handling, the 'F' marks in two debug dumps, and the
    FAKE_CLOCK pull-up. The pull-up is the one that touched the pin, and in
    a Sidecar FAKE_CLOCK build it pulled up the link's RX line.
    - bmon.h: the bmonExclud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
2026-11-08 Sidecar: gate SIO diagnostics on structLogs, report bank-4 core 0 data
    SidecarHost::handlePbiRequest() filled its SidecarSioRecord on every
    request, even with the struct logs off: it read d000Write[0x301] and
    [0x1ff] and copied 16 data bytes each way, touching core 1's hot banks
    while core 1 runs the bus. Only the add() calls checked structLogs. Now
    the d000Write reads, the DCB log and the data copies all run only when
    structLogsInit() has turned the logs on. mmuCheckRangeMapped() stays: it
    is how handleSio() finds the Atari buffer.
    The boot bank report gains a core0r class for core 0 data touched about
    once per request or frame: the sidecarHost object (Sidecar::rx_) and
    i2slink's static ta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
2026-11-08 verify_iram_hotspots.py: check the Sidecar call chain's IRAM banks
    The Sidecar chain runs on core 0 from handlePbiRequest() while core 1
    drives the bus, polling for as long as a Sidecar request takes. Its code
    stayed out of iloop_pbi's bank only by luck of layout. The post-build
    check now holds it to the same rule as the other core 0 hotspots:
    SidecarHost's hook, handler and handleSio, mmuCheckRangeMapped,
    Sidecar::probe/nop/sio/cio/loopbackCheck/transact, i2slink_read/write and
    the static helpers that get their own symbols (tripwire_step,
    t_bits_save, decode_at, decode_u32).
    They are optional, since which ones get linked depends on the config, but
    a name may match only one symbol. The chec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
2026-11-08 pinDefs.h: correct the Sidecar link pin comment
    GPIO0 is not free: on the current host board it is routed to the PBI bus
    audio input (and is a strapping pin), which keeps loopback from locking
    on miner6 board 5. Future revisions isolate it. GPIO21 is the refresh_
    input, which Sidecar builds now give up (no HAVE_REFRESH), so the pair
    is not limited to bench tests with no Atari attached.
    Claude-Session: https://claude.ai/code/session_01KzPLu84tNxwvX3ZoVEHczK
2026-11-08 i2slink: one I2SLINK_RX_BCLK_INVERT for both peers
    The RX sampling edge was a per-config field, set separately in the
    Sidecar app and in both of sidecarHost.cpp's configs (wired and
    loopback). Like the frame rate, the two peers must agree on it, so it is
    now a single compile-time define next to I2SLINK_FRAMES_PER_SECOND, and
    the config field is gone. Default 0 (rising edge), as all three set it
    since 531df73. The old field comment said to keep it true, so the new
    one gives its history instead.
    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
2026-11-08 Sidecar app: note the likely future link pins (46/9/10)
    A comment by sidecarLinkConfig records the candidate pins and why: TX
    GPIO46, RX GPIO9, BCLK GPIO10, adjacent on a DevKitC-1's J1. They avoid
    the octal PSRAM pins that 35/36/37 hit on an N8R8 module, and they stay
    safe if the wrong firmware lands on either board. Not in use yet: the
    wired rigs are still on 35/36/37.
    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
2026-11-08 PROFILE_MODE=GPIO works with the Sidecar; only PIN is refused
    GPIO mode only samples the bus pins (a dedic_gpio input bundle, before
    each PBI command): it adds GPIO-matrix input routes and drives nothing,
    so it can share GPIO48 (the link's BCLK; i2slink keeps its input
    enabled) and GPIO21 (the link's RX). PIN mode also makes core 1 drive
    GPIO48, so it is the one that can't be used with the Sidecar.
    - main/CMakeLists.txt: PROFILE_GPIO_SAMPLE for GPIO and PIN, and a new
    explicit PROFILE_GPIO_PIN_OUTPUT for PIN only. Only PIN + Sidecar is a
    fatal error now.
    - profile.h: no longer derives PROFILE_GPIO_PIN_OUTPUT. It documents the
    three modes and checks the combinations (PIN needs a PROFn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
2026-11-08 PROFILE_MODE=GPIO: sample the bus right after each Sidecar call
    Move PROFILE_BUS() out of ScopedInterruptEnable (both calls, around
    disableBus()) to just after sidecarHost.handlePbiRequest() returns,
    before req is cleared. GPIO profiling now samples the live bus only
    after Sidecar requests; requests handled locally (handlePbiRequest2)
    and loopback builds no longer sample.
    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
2026-11-08 csim BUS_CYCLE=1: atari800 runs on the board's memory map
    Step 3. With make/run.sh BUS_CYCLE=1 (default off), the atari800 fork
    (6127b9fe) sends every CPU access through csim_bus_cycle(). Wherever the
    board asserts extSel_ it answers: base RAM, its cartridge (with the D5xx
    bank switching), its extended banks and its PBI ROM. Everything else
    stays atari800's.
    - core1.cpp: csim_bus_cycle() now returns whether the cycle asserted
    extSel_ (output enabled, driven low), not whether it drove the data
    pins. Every page the board answers has extSel in its control word.
    Writes it doesn't claim (I/O, cartridge ROM) pass through to atari800
    after the board has snooped them.
    - csim_stubs.cpp: csim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
2026-11-09 banktest: does a bank switch reach the very next bus cycle?
    spiffs/banktest.c, an AtariMax 128 cartridge, checks for the hardware
    behavior. From RAM stubs, an STA to PORTB ($3FFD) or $D503 ($9FFD) falls
    through into the banked window, where bank A has RTS and bank B has
    INX, RTS. Each report counts the iterations whose opcode fetch saw B.
    Calibration calls check the seeding, and IRQs and NMIs are off; ANTIC
    DMA stays on, so a miss proves the fault but a clean run is not proof
    of a fix.
    - BANKTEST boot config: no disks, RAMBO256 with one SRAM bank, so on
    hardware every PORTB switch also halts for a PSRAM swap.
    - spiffs/Makefile: make banktest; spiffs.bin carries banktest.car.gz.
    - run.sh: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
2026-11-09 banktest: count failures, report a summary every ~5 s
    A failed calibration printed a line every time, so the 6502 spent its
    time scrolling the screen instead of switching banks. Count misses and
    bad calibrations per test and per bank, and print a three-line summary
    every 300 jiffies (RTCLOK keeps counting because the VBI runs between
    rounds): rounds and PASS/FAIL, then for ext and cart the misses out of
    the iterations run, and how often bank A or bank B calibrated wrong.
    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
2026-11-09 banktest: test $D1FF too; the board keeps PBI RAM at $D600-$D7FF
    $D600-$D7FF is reserved for PBI devices and undecoded on a stock machine.
    mmuInit() now maps its reads to the same d000Write pages its writes
    already went to, so it acts as 512 bytes of RAM (like the 1400XL), $FF
    until written (the XL pull-ups). A VBXE at $D640/$D740 would conflict.
    banktest's third test falls through from STA $D1FF at $D7FD into $D800.
    The OS ROM is off for it, so the deselected $D800 is RAM seeded with RTS.
    The selected one is the PBI ROM, whose unused checksum bytes hold
    INX, RTS while it runs and go back to $FFFF after. It reports a "pbi"
    line beside ext and cart.
    csim: the default mode passes all three (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
2026-11-09 banktest: test BASIC disable from RAM; drop printf
    Disable BASIC through PORTB and fall into $A000 from RAM, with the cart
    off. Seeds under BASIC send a late fetch through the ROM's 2-byte opcode
    (probed at startup: LDA $CA stock, LDX $08 Altirra) into a JMP to a miss
    counter. It passes today because base RAM writes mirror into the Atari's
    RAM; it guards that. Every enable is followed by a non-$A000 read, so a
    late board never contends with the ROM. The enable direction isn't
    tested: it could drive the bus against the ROM until core 1 is fixed.
    Replace printf with small output helpers; bank 0 had overflowed.
    Claude-Session: https://cl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
2026-11-09 core1: map PORTB and $D1FF at the head of the bus cycle
    The ext bank ($4000), BASIC ($A000) and OS/PBI ($C000/$D800) selects
    were applied at the end of a read cycle, so a PORTB or $D1FF write took
    effect one read late. Map them at the head of iloop_pbi_cycle(), before
    the address read, so the very next cycle sees the switch, as on the real
    MMU. The cart bank select stays in the write cycle, where it already
    was correct; the head now maps it into $A000.
    csim BUS_CYCLE=1: banktest passes ext, cart, pbi and basic (it missed
    every ext and pbi switch before); the SDX regression is unchanged.
    Timing is untuned: the head does more before the address read and both
    exit paths do less, so LEADIN_NOPS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
2026-11-09 core1: move the bmon push to the exit paths, re-time from the asm
    Mapping the banks at the head put ~18 more instructions before the
    address read. Move the bmon push into the read and write exit paths, drop
    4 of the lead-in nops and re-time the exit delays (RD +2, WR -5) as
    offsets on hwType.h's tuning. A static count of the generated code
    (TESTPOOL1, one cycle per instruction, two per loopnez pass) against
    master: address read and extSel +7 cycles, read data out -9, read
    release +1, write sample -1, write release 0. Unmeasured; a first stab
    for the profiler.
    csim BUS_CYCLE=1: banktest still passes all four; SDX regression
    unchanged.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
2026-11-09 core1: leave the BASIC select in the exit paths, as before
    Only the ext bank and the OS/PBI select need the head. The OS select
    must be on time: the OS-to-RAM copy trick re-enables the ROM from code
    in $C000-$FFFF, so a late board would drive RAM over it. BASIC goes back
    to one read late (the read path after the data drive), plus the write
    path right after the cart mux, so cart switches still reach the next
    cycle. Both run in idle time.
    Static count against master (TESTPOOL1): address read and extSel +3
    cycles, read data out -12, read release +1, write sample 0, write
    release +1. csim BUS_CYCLE=1: banktest passes all four; SDX regression
    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
2026-11-09 core1: pin enable right after the ctrl load; one-cycle loopNezDelay()
    - iloop_pbi_cycle(): r0 is a local. A compiler barrier after the
    GPIO_ENABLE1_W1TS store keeps the page data load and the address
    decode behind it; the compiler had scheduled three of them in front.
    PROFILE2 (pin enable) moves 3 cycles earlier, level with master.
    - loopNezDelay(): a one-nop.n body, one cycle per pass, and no jump
    over alignment padding (the assembler aligns the loop body itself).
    That saves ~4 cycles per call. Core 0's two hand-tuned poll loops go
    from 15 to 30 passes and busyWait6502Ticks() from ticks*66 to
    ticks*132, so their timing is unchanged.
    - The core 1 exit delays convert hwType.h's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
2026-11-09 core1: drop a redundant zero-extend from the OS/PBI select
    GCC ORed the PORTB and $D1FF bits as bytes and zero-extended the result
    again; an empty asm on the loaded $D1FF byte keeps it a full register.
    The head is 12 instructions. Exit delays +1 each keep the read release
    and write sample where master has them.
    Static count vs master (TESTPOOL1): PROFILE1 10/12, PROFILE2 23+L/22+L,
    PROFILE3 46+L/37+L, PROFILE4 90+L/90+L, PROFILE5 71+L/71+L, PROFILE6
    72+L/72+L. csim BUS_CYCLE=1: banktest passes all four; SDX unchanged.
    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
2026-11-09 L1Block: ctrl first, so core 1's ctrl address is one addx2
    At offset 512 (behind pages[]), the ctrl lookup also needed an addmi,
    since l16ui's offset reaches only 510. Nothing depends on the field
    order. Exit delays +1 each keep the read release and write sample.
    Static count vs master (TESTPOOL1): PROFILE1 10/12, PROFILE2 23+L/21+L,
    PROFILE3 46+L/36+L, PROFILE4 90+L/90+L, PROFILE5 71+L/71+L, PROFILE6
    72+L/72+L. csim: banktest passes all four in BUS_CYCLE=1; SDX
    unchanged in both modes.
    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
2026-11-09 extBanks[]: index by the raw PORTB byte
    MmuState::extBanks[] grows from 32 entries (PORTB bits 2-6) to 256 (the
    whole byte), so core 1's head indexes it with the loaded PORTB byte and
    drops the extui: the head is 11 instructions. The 8 PORTB values that
    differ only in bits 0, 1 and 7 share their bank's L1Block, so
    mmuOnChange()'s page-table patch after a PSRAM swap reaches all of them;
    premap[] and the allocation stay per bank. Each MmuState copy (mmuState,
    mmuStateSaved, mmuStateDisabled) grows 296 -> 1192 bytes, +2688 DRAM.
    Exit delays +1 each keep the read release and write sample.
    Static count vs master (TESTPOOL1): PROFILE1 10/11, PROFILE2 23+L/20+L,
    PROFILE3 46+L/35+L, PROFILE4 90+L/9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
2026-11-09 core1: drop the barrier after the pin enable
    e0e5d2a added a compiler barrier after the GPIO_ENABLE1_W1TS store, so
    the page data load and address decode followed it and the pin enable
    came 3 cycles earlier. On miner6 #1 (TESTPOOL1, SDX_XL) that alone
    breaks the bus: the night-G base (c4d4523 plus the startup and bmon
    publish fixes) runs ~90 s, the same with only the barrier added fails
    with a stackprog timeout at ~20 s. HEAD without it runs the full 300 s
    (1,165-1,236 I/Os, ~170k halts) at every WR_DELAY_ADJ from -2 to +3,
    past the D1:A/D2:A compare failure that stops b5daf67 and night-G at
    ~90 s under the same debug settings.
    The one-cycle loopNezDelay() was fine: e0e5d2a's write delay co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
2026-11-09 pbi: PROFILE_MODE=GPIO sample point before handlePbiRequest2()
    Non-Sidecar builds (which have refresh_, so the data channels can drop
    refresh cycles) had no PROFILE_BUS() call; sample the live bus before
    the ScopedInterruptEnable detaches it, with the 6502 in the stack loop.
    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
2026-11-09 link: align iloop_pbi to 64 bytes
    iloop_pbi's address followed whatever IRAM code was linked before it,
    so unrelated core 0 changes moved it and shifted core 1's timing (the
    old loopNezDelay's alignment padding and the fetch alignment both depend
    on it). On miner6 #1, adding a counter to resume6502() (not run before
    the first halt) stopped the 6502 booting; the same build with this
    alignment ran SDX_XL for the full 300 s. Pin it so core 1's layout is
    fixed while its delays are tuned.
    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
2026-11-09 tools: static core 1 cycle count per sample point, as a post-build step
    tools/core1_cycle_count.py disassembles both iloop_pbi instances and
    counts one bus cycle from the clock-fall poll exit to each sample point
    (P1 address read, P2 pin enable, P3 read data, P4 read release, P5 write
    sample, P6 write release) on the read and write paths: one cycle per
    instruction, taken branch or forward jump 3, not taken 1, loopnez
    n * body + 2 (measured for both loopNezDelay() forms), and "+L" for the
    GPIO_IN APB read latency. GPIO registers are found from the l32r
    literals, tracked along each path. It prints one CORE1 CYCLES line per
    instance and never fails the build.
    The counts are relative: they comp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
2026-11-09 core1: read release one APB tick after master's (RD_DELAY +6)
    PROFILE_MODE=GPIO on miner6 #1 and #2 (SDX_XL, Sidecar off), read
    extSel release mean in sampler buckets (~8.5 ns), master 74.8 / 74.5:
    RD_DELAY_ADJ 0: 73.3 / 73.1 (~12 ns early; breaks "not earlier
    than master")
    +3: 74.9 / 74.8 (level with master)
    +6: 76.3 / 76.4 (one APB tick, ~12.5 ns, later)
    Three cycles is one 80 MHz APB tick for the GPIO write. Take +6 for a
    step of margin. The other edges were already level with master or
    later (write release 73.7 vs 72.1, read data ~39 vs ~41.6); extSel
    assert is ~1 bucket later than master's (the head is one instructio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
2026-11-09 Profiling cleanup to get bench-idf.py to run again and show all the sampled pins even in PROFILE_MODE=PIN. See profiling notes in profile.cpp, there are still outstanding issues with the data.
2026-11-09 FAKE_CLOCK: phase-lock the fake clock, R/W and A0
    The three LEDC timers ran at testFreq, /8 and /4 with fractional
    dividers (80 MHz / 1.5 MHz = 53.33) and were started one by one, so R/W
    and A0 slid through the whole bus cycle. Core 1's R/W/address sample and
    the profiler's burst capture then saw different values, and every bench
    cycle was binned at random.
    Now all three use the 80 MHz APB clock with one divider, exactly 27.0
    (the driver rounds to 1/256 and these freq_hz values land on it), so a
    timer count is half a clock period and they can't drift. The clock is
    high for count 0 and low for count 1; A0 (4 clock periods) and R/W (8)
    start their high phase at count 1 (hpoint), so every A0 a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
2026-11-09 FAKE_CLOCK: assert extSel_ on the bench's test-page writes
    Base RAM pages map writes with ctrl 0, so a write to the bench's test
    address ($0180/$0181) never drove extSel_ and the write path's extSel_
    drive and release didn't show in the profile. The test page's write
    entry already goes to dummy RAM; give it the extSel_ ctrl bit too, so
    bench writes are claimed like a board-owned page.
    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
2026-11-09 FAKE_CLOCK: place R/W and A0 edges outside the sample windows; skip phases
    The previous phase-lock put every R/W and A0 edge at a fixed point, but
    the driver's pause/reset/resume left them 21 and 39 cycles after the
    clock fall, inside the window where core 1 reads the address (~22 after
    the fall) and before the profiler's R/W look (~80). And with every
    signal locked, the sampler's fixed loop time aliased: captures kept
    landing on one R/W/A0 phase (93% "writes", 5% of captures with an A0
    edge).
    - Divider 7 x 8 counts per clock period (80 MHz / 56 = 1.43 MHz), so an
    hpoint step is 87.5 ns. A0 and R/W are aimed one count before a clock
    fall.
    - The timers are held in reset and released toge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
2026-11-09 FAKE_CLOCK: move the bench bus into fakeBus.cpp; latch the timer phase
    setup() now calls setupFakeBusInjection() (pins and the phase-locked
    clock/R/W/A0) and setupFakeBusMmu() (the test page), from the new
    fakeBus.cpp; the fake clock constants and the test address move to
    fakeBus.h, where main.cpp's testFreq still reads them. main.cpp's unused
    ledc_struct.h/ledc_reg.h includes go.
    The timer start and phase measurement now set PARA_UP with each conf
    write, so the low-speed timers' pause/reset take effect at once: the
    measured counter leads (A0 3, R/W 4 counts) and the edge positions are
    the same on every boot. The edges still land about a count (A0) and half
    a count (R/W) after the aim, so a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
2026-11-09 profile: GPIO-mode tallies back; window and buckets for the slower bench clock
    - 81e5589 left the extSel, data, address, R/W and clock tallies inside
    #ifdef PROFILE_GPIO_PIN_OUTPUT, so PROFILE_MODE=GPIO recorded nothing.
    Only the profile-pin tally is PIN-only now; the rest run in both modes.
    - Under FAKE_CLOCK the pre-fall wait uses fakeClockHz (fakeBus.h), not
    1.78 MHz, so captures start ~10 cycles before the fall on the bench too.
    - 110 samples (was 90), so a capture covers past the next clock fall at
    the bench's 1.43 MHz (168 cycles).
    - Hist2::maxBucket 192 (was 128); add() clamps into the last bucket
    instead of masking, since 192 isn't a power of two.
    Bench, both modes: the ne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
2026-11-09 core1: pick the $4000/$C000 blocks from registers; stop storing them
    The head stored the PORTB/$D1FF-selected blocks into mmuState.l1Blocks[]
    and the decode loaded l1Blocks[index] back right after the address read.
    On the bench (PROFILE_MODE=PIN, FAKE_CLOCK) that store-then-load cost
    ~5 cycles between the address read (P1) and the pin enable (P2); moving
    just the stores past P2 brought P1/P2 level with master.
    The head now loads extBanks[portb] and osEnL1BlockMux[osSel] into
    registers, and the decode substitutes them for the $4000 and $C000
    blocks with two branchless moveqz (GCC turned the ternaries into beqi
    branches). Core 1 no longer keeps mmuState.l1Blocks[l1Block40] and
    [l1BlockC0] cur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
2026-11-10 FAKE_CLOCK: map the bench test page as board memory; FAKE_BUS_TEST_ADDRESS
    The test page now reads from its own buffer (the two A0 addresses read
    0xff and 0x00) with extSel_ and the data bus driven, and writes to dummy
    RAM with extSel_, whatever baseMemSz is (BENCH has 2 KB). So the address
    can move: -DFAKE_BUS_TEST_ADDRESS (default 0x0180, even; passed through
    main/CMakeLists.txt) puts the bench in another block, e.g. 0x4180 for
    core 1's $4000-block select.
    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
2026-11-10 core1: read PORTB and $D1FF from one base register; no head l32r
    With the moveqz decode's extra live registers, GCC reloaded
    &d000Write[0x100] (for the $D1FF read) from the IRAM literal pool with
    an l32r every cycle, ahead of the address read. The ternary build had a
    register free and hoisted it out of the loop. That literal sits in SRAM0
    next to core 0's IRAM and ICache, so it can stall intermittently, which
    fits the bench result: some moveqz cycles ran ~8 ticks late, and no
    fixed HEAD_NOPS_ADJ helped. Derive $D1FF from the PORTB base (addmi
    -512, offset 255) instead.
2026-11-10 core1_cycle_count: list in-cycle l32r loads; --strict fails on one before P1
    Each l32r inside iloop_pbi's cycle is reported with its static cycle and
    the sample point it precedes. An l32r in the head (before the P1 address
    read) is what broke the moveqz block-select build until 546f756; the
    build now runs the tool with --strict, so that case fails the build.
    Checked on eb0f80e's core1.cpp (fails: d000Write+0x100 at cycle 1) and
    546f756 (passes; the GPIO_OUT1/GPIO_IN1/pinReleaseMask/bmon loads
    before P3-P6 are listed, not failed).
    Claude-Session: https://claude.ai/code/session_01KzPLu7BCcGY1T6QsDX9Laa
2026-11-10 core1: split the write delay; WR_SAMPLE_NOPS before the data sample
    WR_DELAY ran before the write-data sample (P5), so it set the sample and
    the release (P6) together. The sample now takes WR_SAMPLE_NOPS exact
    nop.n cycles (default 6), and WR_DELAY runs after the GPIO_IN1 read,
    setting only the release. WR_DELAY gives back the sample nops so the
    release stays put (as RD_DELAY does for RD_DATA_NOPS), and it is clamped
    at 0: a negative count would make loopnez spin ~2^32 times.
    Bench PROFILE_MODE=PIN (CC:CC): P5 102-106 -> 90/92 ticks (target 90,
    over the ~88 ticks hardware write data takes to settle, not counting on
    APB read latency); P6 122 -> 120/122. WR_DELAY_ADJ now moves only the
    releas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
2026-11-10 core1 timing: five independent cycle counts straight from hwType.h
    The cycle delays were derived through a chain: hwType.h's leadinNops,
    rdExitDelay and wrExitDelay (two-cycle passes of the old loopNezDelay)
    were translated in core1.cpp (2 * rd + 24, 2 * wr - 5, a head
    instruction count), shifted by *_ADJ knobs, and cross-subtracted
    (RD_DATA_NOPS off the read delay, WR_SAMPLE_NOPS off the write delay).
    Now each machine's HwTypeTiming lists headNops, rdDataNops,
    rdReleaseDelay, wrSampleNops and wrReleaseDelay in CPU cycles, and
    core1.cpp uses them as they are. They are independent: moving one point
    leaves the later ones relative to it, so to keep a later point put, take
    the same amount off i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
2026-11-10 hwType.h: TESTPOOL1/2 back to 9c64810's tuning to re-baseline
    Both rows return to 59/6/6 (static P4 102, P5 63, P6 72), the timing .1
    and .2 ran when their GPIO profiles were taken (9c64810), which asked
    for opposite write-release changes (.1: rd/wr +10; .2: rd +6, wr -10).
    Fresh samples from both, on known identical tuning, come first. The
    iloop_pbi code matches that build's.
    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
2026-11-10 hwType.h: TESTPOOL1/2 read release +6, write release to 0
    Fresh PROFILE_MODE=GPIO samples from .1 and .2 on f884bf8 (59/6/6)
    agree: the read release needs +6 and the write release -10. Only -6 is
    available without moving the write sample below its 90-tick target, so
    wrReleaseDelay goes to 0: no loop, and no count register to load.
    Static D500_ADDR: P4 102 -> 108, P6 72 -> 66; P5 63 -> 62, because the
    release loop's movi had been scheduled before the sample read. Other
    rows compile unchanged.
    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
2026-11-10 hwType.h: TESTPOOL1/2 back to 59/6, write release 6 -> 4
    65/6/0 (d8c41296) didn't boot on .1 or .2 (IO timeout at 127 s, no
    I/O). On the bench its read cycle ended 4-8 ticks later, with no room
    before the next clock fall. Back to the 59/6 read and sample timing,
    trimming the write release by 2 and keeping its loop: the only code
    change from f884bf8 is the loop count (3 -> 1). Static D500_ADDR: P4 102,
    P5 63, P6 72 -> 70.
    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
2026-11-10 hwType.h: TESTPOOL1/2 65/6/0 again, to retest with staggered boots
    All 14 failed boots of d8c41296's 65/6/0 (IO timeout at 127 s) started
    within 1-9 s of the other machine's, a possible power-on interaction.
    Same rows again; iloop_pbi is byte-identical to d8c41296's. This time
    .1 and .2 boot at least 30 s apart.
    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
2026-11-10 hwType.h: TESTPOOL1/2 back to 59/6/4
    The staggered retest (888b6708, .2 and .1 powered on 111 s apart) failed
    the same way: IO timeout at 127 s with no I/O on both. So a read release
    at rdReleaseDelay 65 (P4 108) never boots on the 800XLs; it isn't a
    synchronized-boot artifact. Back to 0b35a5e's 59/6/4, which boots;
    iloop_pbi is byte-identical to it.
    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
2026-11-10 hwType.h: TESTPOOL1/2 write sample +2 (59/8/4)
    .1 failed a disk compare at the same place (D1:A D2:A/D differ: byte
    8936) in every run on 59/6/6 and 59/6/4. It ran clean overnight and on
    546f756 + WR_DELAY_ADJ=-6, where the write sample was about 6 cycles
    later: the delay split (9d19c997) moved static P5 from 69 to 63, and
    that earlier sample has never been validated on hardware. wrSampleNops
    6 -> 8 for now; the release loop stays, so it also moves 2 later.
    Static D500_ADDR: P5 63 -> 65, P6 70 -> 72, P4 102. The only code change
    is the sample loop count (3 -> 5).
    Claude-Session: https://claude.ai/code/session_01KzPLu7BCcGY1T6QsDX9Laa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
2026-11-11 core1: issue the pin-enable store (P2) before the data-pointer work
    extSel must be asserted before phi2 rises: on .1/.2, moving P1/P2 6 cycles
    later fails to boot, while moving only the read-data drive 6 later boots.
    GCC had scheduled the pages[] load and the address extract ahead of the
    ENABLE1_W1TS store; a barrier that renews r0 now keeps them after it.
    Static P2 28 -> 25 on TESTPOOL1/3/5; other points move by at most 1.
    Bench PIN (800XL row, same-day A/B): P2 56-58 -> 54-56 ticks; P4 and the
    loop end unchanged; P5 about 1-2 later.
    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
2026-11-11 mmu: assert mpd_ only on $D800-$DFFF in the PBI ROM block
    mpd_ only disables the OS math-pack ROM at $D800-$DFFF, so the PBI
    device's extSel_ response is used there (extSel_ can't override ROM).
    The PBI block ORed it into all 128 ctrl entries of $C000-$FFFF, 98 of
    them without extSel_: OS ROM fetches, the $D0-$D4 chip reads, and the
    fall-through register writes. The hardware ignores it there, so trim it
    to the $D800-$DFFF pages, which all have extSel_.
    Rule from here on: no ctrl entry has mpd_ without extSel_. mmuInit()
    reports any PBI-block entry that breaks it. Core 1's planned
    dedicated-GPIO extSel_/mpd_ assert relies on it (tests mpd_ only when
    extSel_ is set).
    Changes the bus during P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
2026-11-11 core1: inline the bus cycle back into iloop_pbi()
    csim no longer calls the cycle body on its own (377f840f), so it goes
    back into the loop: one function, which lets each path's tail branch to
    the loop's own labels next.
    Not byte-identical: GCC now lays the clock poll out with both tails
    jumping to one probe at the bottom of the wait, with the cycle body right
    after it. A late arrival (clock already low) costs j 3 + probe 1 + untaken
    bnez 1 = 5 cycles on both paths; before, the tails jumped to the first
    unrolled probe and took a branch into the body, 7. The rest is register
    renaming. Static counts unchanged (TESTPOOL1/3/5); bench PIN P1/P4/P6
    (800XL row, early arrivals) match 09e1a1f8's swee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
2026-11-11 profile: drive the PIN-mode profile pin with immediate-mask instructions
    PROFILE_GPIO_PIN_SET/CLEAR loaded profileGpioOutMask from DRAM and kept
    it in a register for ee.wr_mask_gpio_out. In core 1's cycle that is one
    register too many once the loop pins its GPIO bases: the bench PIN build
    of the asm-goto poll spilled the GPIO_IN base to the stack and reloaded
    it before every address read, so the bench measured the instrumentation
    instead of the loop. ee.set_bit_gpio_out / ee.clr_bit_gpio_out with an
    immediate mask (channel 0, profileGpioOutMask's only value) need neither.
    Only PROFILE_MODE=PIN builds change; bench baselines taken before this
    are not comparable.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
2026-11-11 core1: clock poll in asm goto, one probe at the end of each path's tail
    Each path's tail now ends with its own probe (ee.get_gpio_in + beqz to
    the next cycle's head), so a late arrival costs 4 cycles on either path
    (was 5 with GCC's layout in 0363e1da, 7 before that); otherwise it jumps
    to a shared wait loop (unrolled probes, 2-cycle resolution). asm goto
    fixes the layout: written as plain C gotos, GCC folded it back into one
    shared probe. RELEASE_PLACEMENT=3 keeps its own per-tail wait.
    With asm goto edges GCC stopped keeping loop invariants in registers and
    reloaded the GPIO bases from the IRAM literal pool inside the cycle (an
    l32r before P1, which --strict rejects). So the GPIO_IN, ENAB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
2026-11-11 hwType.h: read release +1, write sample +2 on every row (0dfb4756's head)
    The asm-goto poll's shorter head moved the static read release (P4) 1
    cycle and the write sample (P5) 2 cycles earlier on every machine class.
    Put them back at production's positions; .1 ran exactly this for 600 s
    (TESTPOOL1 60/10/4 via -D, e0, 17,031 I/O). Static, D500_ADDR, now equal
    to 0363e1da at P4/P5/P6: TESTPOOL1 101/66/72, TESTPOOL3 93/64/70,
    TESTPOOL5 91/73/76 (D500_DATA's P5/P6 1 earlier). The head stays
    earlier: P1 10, P2 24, P3 34. Row comments now give the measured counts.
    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
2026-11-11 core1: EXTSEL_DEDIC: extSel_ from core 1's dedicated output (config B)
    Opt-in (-DEXTSEL_DEDIC=1/2, default 0: production unchanged, byte for
    byte). extSel_ and mpd_ are sampled at phi2's rising edge (30-50 ns
    setup), and extSel_'s APB pin-enable edge lands ~25 ticks after its
    store, at or after the rise. Driven from core 1's dedicated GPIO output
    channel 1 instead (open-drain pad, output enable left on, inverted in the
    GPIO matrix), the pin moves within a few ticks of the instruction.
    - Assert: bbci on the page's ctrl word + ee.set_bit_gpio_out, right
    before the APB pin-enable store; release: ee.clr_bit_gpio_out. Both
    immediate forms, no registers beyond pageEn (a mask register spilled)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
2026-11-11 core1: EXTSEL_DEDIC drives mpd_ too (core 1 dedicated channel 2)
    mpd_ is sampled at the same phi2 rising edge as extSel_. In config B the
    APB pin-enable edge comes 6-8 ticks later than in production (the release
    store at the top of the loop stalls the head), which would put mpd_ past
    the rise on every $D800-$DFFF access while the PBI ROM is in.
    - Assert, nested after extSel_ (mmu.cpp's rule, 7cea93d0: mpd_ never
    without extSel_): bbci extSel -> set ch1 -> bbci mpd -> set ch2. The
    mpd_ test only follows the extSel_ set, so extSel_'s edge is unchanged.
    - Release: one ee.clr_bit_gpio_out for both channels; pinReleaseMask
    drops mpd_ as well.
    - Pin setup like extSel_'s: open drain, inverte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
2026-11-11 sdkconfig: Sidecar off (and its loopback)
    The test pool's profiling runs need it off (PROFILE_MODE=GPIO samples
    GPIO48, the Sidecar link's BCLK, and with refresh_ back as an input the
    data histograms drop ANTIC refresh cycles). .1-.4 have been carrying this
    as a local sdkconfig change; committing it lets them fast-forward clean.
    Re-enable for Sidecar work (929550b1 turned it on).
    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
2026-11-11 core1: EXTSEL_DEDIC asserts extSel_/mpd_ with one dedicated-GPIO write
    With EXTSEL_DEDIC the ctrl[] words carry extSel_ and mpd_ at GPIO33's
    and GPIO34's enable bits (ctrlExtSel, ctrlMpd) instead of the pins' own.
    Those pins have no pads on the ESP32-S3 and the QSPI PSRAM doesn't use
    them (user-verified, with a bench boot), so the per-cycle GPIO_ENABLE1_W1TS
    write of the word does nothing for them, and their bits 1 and 2 are
    exactly dedicated channels 1 and 2. Core 1 asserts both lines with one
    ee.wr_mask_gpio_out of the ctrl word as value and mask, replacing two
    bbci branches and two ee.set_bit_gpio_out (the mpd_ skip was a taken
    branch on nearly every cycle). The word's other bits reach on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
2026-11-11 core1: MegaCart bank switch at most one cycle late (was: next write)
    MegaCart (D500_DATA) selects the bank by the data written to $D500. The
    write path maps the cart before that cycle's data is sampled, so it used
    the previous value, and only write cycles recomputed the bank: after
    STA $D500 the switch waited for the next write, while the 6502 kept
    fetching the old bank (code in the cart is mostly reads).
    The read path now recomputes MegaCart's bank from $D500's shadow too,
    just before its existing $A000 re-map, so whichever cycle follows the
    bank write (read or write) picks it up and the switch reaches the cycle
    after it: at most one cycle late. It costs nothing on the worst path:
    the read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
2026-11-11 stress: fold banktest's next-cycle bank tests into both stress carts
    banktest.c (an AtariMax-only cartridge) goes; its four tests (PORTB ext
    bank, $D5xx cart bank, $D1FF PBI ROM, BASIC disable) now run every stress
    loop in both stress builds, printed as
    " bank ext:misses/tries cart:... pbi:... basic:... cal:N".
    - AtariMax: the 8 KB window holds one bank, so the bank tests, their stub
    tables, the screen move and the report builder live in bank 1 and call
    nothing in bank 0 (no libc, volatile copy loops instead of memcpy,
    decimal by subtraction instead of division, no ?: that compiled to
    "bit __set_v" in bank 0's libc). Checked by relocation (--emit-relocs):
    bank 1 references only b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
2026-11-11 core1: map $4000/$C000 into l1Blocks[] behind the address read (~4 cycles off P1 -> extSel_)
    The decode picked the head's $4000/$C000 blocks with two addi + two
    moveqz after the address read, on the dependent chain from r0 to the
    extSel_ assert. The head now stores them into mmuState.l1Blocks[1]/[3]
    right after the read issues: the core runs on until an instruction needs
    r0, so the stores are hidden in the APB read, and the decode is a plain
    table load. (Stored before P1, as tried earlier, they stalled the read.)
    That also freed a register: the head lost its rematerialized constant
    and the read path its GPIO_OUT1 literal load.
    headNops 0 -> 1 on every hwType.h row keeps P1 exactly where the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
2026-11-11 hwType.h: one write-sample delay (10) for every machine
    GPIO profiles of the 2026-11-11 soak put the last write-data change at
    78-88 ticks on .1-.5 (.1 82, .2 84, .3 88, .4 88, .5 78), with no pattern
    by model: the 130XE settles earliest. The 130XE rows' 18 (P5 77) was left
    over from blind multi-knob tuning before the profiling. So 10 everywhere
    (static P5 69, what .1/.2 ran): .3/.4 sample 2 cycles later than they
    did, .5/.6 8 cycles earlier, which takes 8 cycles off every 130XE write
    cycle (the write path ends the worst-case loop). All TESTPOOL loops are
    now identical. Where P5's read latches on hardware is still unmeasured;
    .6 (Sidecar) has no profile yet.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
2026-11-11 Switch .6 to GPIO sampling as well
2026-11-11 bus_profiler: the GPIO burst capture as a component, shared with a Sidecar app
    The host's PROFILE_MODE=GPIO/PIN capture (wait for a phi2 fall, read the
    eight-pin dedicated-GPIO bundle 110 times back to back, add each pin's
    edges to histograms by distance from the fall) moves from main/profile.cpp
    into components/bus_profiler, for the coming Sidecar profiler app.
    - The capture is an always_inline template (skip phases, refresh_ input,
    profile-pin edges, half-cycle ticks), so each app wraps it with its own
    placement: the host keeps profileGpioSampleBurstForCycles() in its
    CORE0_HOTSPOTS section. Pins come in a BusProfilerPins config.
    - Hist2 moves to the component; profile.h includes it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
2026-11-11 sidecar_profiler: a Sidecar app that profiles the bus instead of the link
    Firmware for the Sidecar board: samples the Atari bus pins it is wired to
    with bus_profiler's burst capture and prints the HIST histograms every
    10 s, while the Atari and the host run normally. The host's own capture
    only runs while the 6502 waits in the PBI driver; this one sees real ROM
    reads, ANTIC DMA, and core 1 while core 0 is busy.
    - Pins (Sidecar <- host): GPIO4 <- 36 phi2, GPIO36 <- 48 profile pin and
    GPIO35 <- 21 refresh_ (both the rigs' existing link wires), GPIO5 <- 17
    R/W, GPIO6 <- 47 extSel_, GPIO7 <- 38 D0, GPIO15 <- 39 D1, GPIO16 <- 1
    A0. All inputs, no pulls; 35 is never an output (the link driv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
2026-11-11 Sidecar link pins: 46/9/10, off the octal PSRAM pins
    The Sidecar end of the link moves from 35/36/37 to TX GPIO46, RX GPIO9,
    BCLK GPIO10 (adjacent on the DevKitC-1's J1). Host pins are unchanged:
    GPIO0 -> 9, GPIO21 <- 46, GPIO48 -> 10. On miner6 board 6, a Sidecar held
    in reset held host GPIO21 (also the Atari refresh_ input) low through its
    octal-PSRAM GPIO35.
    sidecar_profiler follows the same wires: profile 36 -> 10, refresh_ 35 -> 46.
    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
2026-11-11 core0: startup write timeout is a fatal exit, not a printf
    The halt-release wait printed "no 6502 writes seen" with interrupts
    masked (core0Loop runs under portDISABLE_INTERRUPTS), and newlib's stdout
    lock calls abort() there: the fallback crashed every time it fired, as on
    a bench board with no clock. Record the reason with core0_exit() and
    return; threadFunc stalls core 1 and unmasks interrupts before printing.
    Exit code -6.
    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
2026-11-12 Drop sidecar_profiler; wiring diagram for the main board <-> Sidecar pair
    The Sidecar app will run the bus profiler on its free core instead, alongside
    the link, so the separate app goes. components/bus_profiler stays for that.
    docs/sidecar_wiring.py draws docs/sidecar_wiring.pdf from one wire table:
    the link (TX 0->9, RX 46->21, BCLK 48->10) and the planned profiler inputs,
    including the Sidecar's own refresh_ input on GPIO17 from the Atari's RFSH
    (3.3 V side), since host GPIO21 is the link's RX.
    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
2026-11-12 USB-Serial-JTAG as the only console; boot.sh burns the flash-voltage eFuse
    GPIO43 is Atari D5 and was UART0 TX, the primary console: the
    second-stage bootloader's log and early app printfs drove D5 on every
    boot. The console is now USB-Serial-JTAG only (the tools already read
    it there), so nothing prints on GPIO43.
    GPIO45 is Atari D7 and the VDD_SPI strap: with D7 high at an ESP reset the
    chip could pick 1.8 V flash. tools/efuse_check.sh, run by boot.sh with the
    Atari off, burns set-flash-voltage 3.3V where missing (S3 only, not with
    1.8 V PSRAM) and reports the ROM-log eFuse. It never fails a boot.
    AGENTS.md: the boot-pin hazard TODO, with what's done and what's left
    (the pad's reset-defa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
2026-11-12 Sidecar: optional microSD card at /sd; wiring diagram shows it
    A 4-bit SDMMC microSD on six adjacent Sidecar pins (DevKitC-1 J3-4..9:
    GPIO1 DAT2, 2 DAT3, 42 CMD, 41 CLK, 40 DAT0, 39 DAT1), in the socket's
    pin order. sidecarAppBegin() mounts its FAT volume at /sd at 40 MHz,
    retrying once at 20 MHz unless the card simply isn't there, and never
    formats. No card or no FAT volume: one log line, and the Sidecar runs as
    before (31 ms on the bench board without a card).
    docs/sidecar_wiring.py: the microSD block and its six wires (planned);
    the table continues on a second page.
    Claude-Session: https://claude.ai/code/session_01KzPLu7BCcGY1T6QsD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
2026-11-12 disk_image through the VFS: no raw SPIFFS API; Sidecar drops its idle GC
    The disk images (ATR, .atr.gz, the directory stitch, csim's .img) use
    open/read/lseek/write/stat/opendir on whatever is mounted, instead of the
    raw SPIFFS API through the patched-in spiffs_fs_by_label(). Sio resolves
    a diskSpec path through roots(), first match wins: {"/spiffs", ""} on the
    boards, so "/d2.atr.gz" is /spiffs/d2.atr.gz and "/sd/x.atr" is used as
    given; {"", "../../spiffs"} in csim, its old fallback. setFs() is gone.
    gzipImageInflate() takes a read callback (cartridge.cpp keeps raw SPIFFS
    for now). The cartridge picker lists /spiffs with listFiles().
    The Sidecar no longer needs the IDF patch: no raw SPIFF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
2026-11-12 FAKE_SIO bench smoke test; every build polls the PBI request blocks
    FAKE_SIO (with FAKE_CLOCK; CMake refuses it alone): twice a second,
    core0_utilityTasks() fills in the PBI request block and the DCB for a D1:
    sector 1 read, with no result checking, and BENCH mounts /d1.atr.gz as D1:.
    It points SAVMSC at $0400: handlePbiRequest2()'s first request maps 800
    bytes of screen, and BENCH's base memory ($0000-$07FF, minus the stack
    page) can't hold them at SAVMSC 0, so it asked for a 6502 copy-in that
    never came. REQ_FLAG_NORMAL, not STACKWAIT: no 6502 reaches the stack
    program. The run's end prints pokes, I/Os handled and the last result.
    Bench (FAKE_CLOCK + FAKE_SIO, BENCH): 62 pokes, 61 I/Os, r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
2026-11-12 hardware: espBusBangSidecar carrier schematic (second DevKitC, SD, audio, R/W regroup)
    A copy of the espBusBang carrier with the Sidecar: U2, a second
    ESP32-S3-DevKitC, on the link (main GPIO0 -> GPIO9, GPIO46 -> main GPIO21,
    main GPIO48 -> GPIO10), the bus-profiler taps (PHI2, R/W, extSel_, D0, D1,
    A0, RFSH on GPIO17), a microSD breakout header J2 with 10 k pull-ups on the
    Sidecar's own 3V3, and audio out GPIO47 -> 1 k -> PBI AUDIO.
    Main-board changes: GPIO0 leaves PBI audio; GPIO21 goes through jumper J3
    (1-2 RFSH, 2-3 link RX); GPIO48 leaves R1/RESET; and the R/W regroup
    (GPIO15 R/W, GPIO16 A14, GPIO17 A15), which puts R/W next to the page bits
    so core 1's ctrl[] index is one extui: 3 cy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
2026-11-12 hardware: sidecar_smd, the Sidecar carrier with bare WROOM-1 modules (speculative)
    Both DevKitC boards become ESP32-S3-WROOM-1-N8R2 modules with every GPIO's
    net unchanged, plus what the DevKitCs carried: per module an AMS1117-3.3
    from the board's +5V rail (10u in, 22u out, 100n at the module), the EN RC
    reset (10k/1u) and an IO0 pull-up. J4 (Sidecar) and J5 (main) are 6-pin
    debug/flash headers with one pinout: 5V, GND, BOOT, EN, RX, TX. J5's RX/TX
    are the main module's UART0, i.e. Atari D6/D5, so it's for the Atari off.
    Jumper J6 joins the board rail to the PBI 5V; open, the boards run from
    J4/J5 without back-feeding the Atari.
    hardware/tools/make_sidecar_smd_schematic.py generates it from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
2026-11-12 hardware: the Sidecar can serial-flash the main board; sidecar_smd LED, SD socket, card detect
    Both carriers: the Sidecar gets what esptool's serial protocol needs to
    flash the main board, Atari off: MAIN_EN (Sidecar GPIO11, open drain, to the
    main EN/CHIP_PU), BOOT through the link's existing wire (Sidecar GPIO9 on
    main IO0), and a UART (Sidecar GPIO12 TX / GPIO13 RX) to the main UART0,
    i.e. Atari D6/D5, through 1 k R12/R13. With the Atari on, MAIN_EN still
    resets a hung main board. espBusBangSidecar's README describes it; the
    wiring diagram has the three wires.
    sidecar_smd only:
    - D1, the DevKitC-1's RGB LED: SK6812MINI on Sidecar GPIO48 (SC_LED),
    from the Sidecar's 3V3, 100 n, DOUT no-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
2026-11-12 hardware: ESP-Prog headers, AP7361C, USB-pin RFSH/RESET, breakout, stand-in jumpers, MPD_ LED
    sidecar_smd:
    - J4/J5 follow Espressif's ESP-Prog Program interface, 2x3 2.54 mm: 1 EN,
    2 VDD (+5V rail; ESP-Prog at 5 V), 3 TXD0, 4 GND, 5 RXD0, 6 IO0. The
    ESP-Prog does the auto-reset; no extra parts.
    - J5's TXD/RXD reach main UART0 (Atari D5/D6) through R15/R16, 1 k.
    Serial flashing of the main module only with the Atari unplugged; the
    unattended test farm uses OTA only. During development the board is
    powered through J5/J4 (only the 600XL supplies 5 V on the PBI pin).
    - Regulators: AP7361C-33E (1 A, SOT-223, stable with ceramic caps)
    instead of the AMS1117, which wants a tantalum.
    - T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
2026-11-12 hardware: espBusBangSidecar's resistors and LED on 0805 hand-solder footprints
    R1 (from espBusBang), R2-R7, R12, R13, R17 and D2 move from through-hole to
    KiCad's 0805 hand-solder footprints, as on sidecar_smd: only headers and
    connectors stay through-hole. Applied in one pass over the generated
    schematic. sidecar_smd is unchanged (it already converted them).
    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
2026-11-12 hardware: sidecar_smd's J7 breakout is a 2x7 header
    3V3 and GND on the end pair (pins 1, 2), the Sidecar's USB D-/D+
    (IO19/IO20) beside them on 3/4 for a USB cable breakout, the other unused
    GPIOs (IO3, 8, 18, 21, 35-38, 45) on 5-13, and a second GND on 14.
    PinHeader_2x07_P2.54mm_Vertical. kicad-cli: netlist checked, ERC 94 as before.
    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
2026-11-12 Initial pcb placement
2026-11-12 hardware: sidecar_smd placed; J1 rotated 180° to plug in the right way
    J1 (PBI) was reversed: on the original carrier, installed, J1's odd row
    (pin 1) is on top at the left (its DevKitC's USB ports point right as seen
    from the Atari's front; J1 soldered from the back, as here). J1 now sits at
    0°, same strip. Not mirrored either way: same footprint, same copper side.
    Placement: wings beside J1 for each module's regulator and headers (left:
    J5, J6, J3, U3, C1/C2; right: J4, J7, U4, C5/C6/C9), passives next to the
    module pins they serve (3V3 decoupling and EN RC by pins 2-3, J5's 1 k by
    D5/D6, SD pull-ups by the socket, indicator LEDs along the bottom), antennas
    and the SD slot still off the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
2026-11-12 hardware: sidecar_smd autorouted; headless Freerouting tooling
    tools/autoroute.sh exports Specctra DSN through pcbnew (routing boundary
    inset 0.5 mm for KiCad's edge clearance), runs Freerouting headless with a
    pass limit and a timeout, imports the session, pours GND on both layers
    with stitching vias, drops GND tracks DRC flags for clearance, and runs
    DRC. The optimizer stage is off by default: 90 s a pass, no gain here.
    sidecar_smd: regulators U3/U4 moved to the back; net classes 0.25 mm
    default, 0.5 mm power; routed with no clearance errors or unconnected
    items.
    Claude-Session: https://claude.ai/code/session_01KzPLu7BCcGY1T6QsDX9La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
2026-11-12 hardware: rename sidecar_smd to sidecar_pcb_xl
    The PBI variant of the bare-module Sidecar carrier, ahead of an XE
    (cartridge + ECI) twin. Files, generator (make_sidecar_xl_schematic.py)
    and references renamed; the generator keeps its old UUID namespace so
    the schematic-to-PCB links hold (schematic parity: 0 issues).
    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
2026-11-12 hardware: sidecar_pcb_xe, the bare-module Sidecar carrier on the XE's cartridge + ECI edge
    sidecar_pcb_xl's circuit with J1 swapped for the eci2Pbi adapter's
    cartridge + ECI card edge, each pin on the XL net of the PBI pin the
    adapter maps it to (ECI HALT = PBI READY, as on the adapter; EXTDEC,
    CAS, RAS have no ECI pin and nothing else uses them). Schematic and
    board are generated from the XL ones (make_sidecar_xe_schematic.py,
    make_sidecar_xe_pcb.py), placed for an 80.6 mm card, and autorouted:
    no clearance errors, nothing unconnected, schematic parity clean.
    autoroute.sh: the routing boundary follows the real outline (inset),
    with keepouts over the off-board parts of its box and a fence a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
2026-11-12 hardware: AGENTS.md with the headless KiCad/Freerouting workflow
    Tools and paths on miner6, which boards are generated from which,
    regeneration and parity checks, pcbnew Python gotchas, placement rules,
    and how autoroute.sh routes (and why).
    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
2026-11-12 hardware: DevKitC Sidecar carrier gets ESP-Prog headers and a breakout; laid out and routed
    espBusBangSidecar adds J4 (Sidecar) and J5 (main, through R15/R16 to
    D5/D6) ESP-Prog headers and J7, a 2x8 breakout of the 13 unused Sidecar
    GPIOs with SC_3V3 and GND, as on sidecar_pcb_xl: the DevKitC sockets
    make those pins hard to reach. They're added after the sheet note so
    every existing UUID stays; make_sidecar_xl_schematic.py sets them aside
    and the XL and XE schematics regenerate byte for byte.
    The board: tools/netlist_to_pcb.py (headless Update PCB from Schematic)
    brings it up to the schematic, place_sidecar_devkitc.py places it (U1
    and J1 where espBusBang has them, J1 from the back and the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
2026-11-12 hardware: WROOM thermal vias to 0.3 mm; sidecar_wiring.py into hardware/tools
    KiCad's ESP32-S3-WROOM-1 footprint drills its 12 ground-pad vias at
    0.2 mm, under OSH Park's 0.254 mm minimum; on sidecar_pcb_xl/xe they're
    0.3 mm now (same 0.6 mm pads, 0.15 mm ring). DRC: drill_out_of_range
    gone, lib_footprint_mismatch on U1/U2 expected.
    The wiring-diagram generator moves to hardware/tools; the PDF stays in
    docs/, where the firmware's comments point.
    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
2026-11-12 sidecar: SD card falls back to SPI mode for SPI-only breakouts
    After 4-bit SD mode fails (40 then 20 MHz), the Sidecar tries the card
    in SPI mode on four of the same pins (CS = DAT3/GPIO2, MOSI = CMD/42,
    MISO = DAT0/40, CLK = 41) through sdspi on SPI2, at 20 then 4 MHz. The
    common SPI breakouts' one-way level shifters can't carry SD mode, but
    SPI mode works through them. The log says which mode mounted.
    Bench (no card): both modes time out in 53 ms total and the app runs
    on. One leftover 'gpio: conflict found for GPIO[2]' warning: the SDMMC
    host keeps its pin reservation after a failed init; harmless.
    Claude-Session: https://claude.ai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
2026-11-12 hardware: plain-English silkscreen labels and a revision stamp
    tools/silk_labels.py labels the headers on sidecar_pcb_xl, sidecar_pcb_xe
    and the DevKitC carrier: a short name against each header where it fits
    (IO21, SIDECAR PROG, SD CARD, RFSH-IO20, ...), and a J<n>: name legend
    block on every board (J3: IO21 1-2 RFSH, 2-3 LINK; J6: 5V FROM ATARI;
    J7's odd/even pin map; J8-J10 on the carrier), front if it fits, else
    back. Placement avoids pads, silkscreen, part bodies and the edge (vias
    are tented), so DRC is unchanged on all three boards; nothing moved or
    rerouted. The labels are a KiCad group, silk_labels, replaced on rerun.
    Each board also carries 'REV ${GIT_REV} ${CURRENT_DATE}': GIT_RE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
2026-11-12 sidecar_pcb_xl: drop the old 10/02/25 silkscreen date
    The REV stamp replaces it; it also sat on J1's pads.
    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
2026-11-12 export_pcbway.sh: export the XL, XE and DevKitC Sidecar boards too
    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
2026-11-12 gerbers: PCBWay exports for the XL, XE and DevKitC Sidecar boards (rev e61bf60c)
    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
2026-11-12 export_pcbway.sh: paste layers, and BOM/CPL files for PCBWay assembly
    tools/assembly_files.py maps each part to a manufacturer part number
    (the schematics have none) and writes the BOM and placement CSVs for the
    XL, XE and DevKitC Sidecar boards. R1 is 0 ohm; the DevKitC carrier gets
    sockets only; the PBI connector goes in from the bottom.
    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
2026-11-12 gerbers: paste layers and BOM/CPL for the three Sidecar boards (rev 79eee35d)
    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
2026-11-12 sidecar_pcb_xl/xe: Sidecar module to ESP32-S3-WROOM-1-N16R8
    The main module stays an N8R2. The N16R8's octal PSRAM uses IO35-37
    inside the module, so they come off J7 (pins 9-11 now NC, the others
    keep their pins) and their traces are removed; nothing else moved.
    DRC unchanged, 0 unconnected, schematic parity clean. The J7 legend
    shows NC; the BOM table knows the N16R8.
    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
2026-11-12 gerbers: re-export with the N16R8 Sidecar (rev 0a55c7d7)
    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
2026-11-12 hardware: 4-bit composite-video ladder for the Sidecar, on J7 (documented, off-board)
    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
2026-11-12 sidecar_wiring: a bus-sampler-only drawing for a bare main board (miner6 .5)
    docs/sidecar_sampler_wiring.pdf: the 8 bus_profiler inputs in bit order
    (phi2, profile pin, R/W, extSel_, D0, D1, A0, refresh_) plus GND, and a
    warning not to wire the link: on a bare test-pool board main GPIO21 is
    refresh_, and the Sidecar's link TX would fight RFSH. Both drawings note
    the taps' series resistors and keeping the Sidecar powered.
    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
2026-11-12 sdkconfig: system monitor off (CONFIG_A8BB_SYSMONITOR, default n)
    With it on, 600XL-class boards (.3/.4) are short of internal RAM at boot:
    free heap 21.1 KB -> 17.8 KB and the largest block 12.8 KB -> 7.7 KB
    against 541490af, and the PBI boot's WiFi start fails to create the
    event-loop task (ESP_ERROR_CHECK 0x103 in esp_netif_create_default_wifi_sta),
    abort, panic reboot, every boot. The monitor's hot-bus work is
    bookmarked; turn it back on per board when it's wanted.
    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
2026-11-12 csim: approximate halt_ emulation in bus-cycle mode; memory autodetection design note
    csim_stubs.cpp tracks halt_ from each cycle's W1TC/W1TS (the GPIO
    variables hold only the last mask written); while it's held, the atari800
    fork's CPU (7ad26047) runs no instruction, only idle bus cycles and core 0's
    tick, until core 0's release reaches the pin. busyWait6502Ticks() runs idle
    bus cycles in this mode, so resume6502()'s release lands, as core 1 applies
    it on hardware. CSIM_HALT_LINE=0 plays a machine without the line (130XE on
    the ECI). The exit line reports stalls and halted cycles.
    Checks (BUS_CYCLE=1): 60 s SDX_CSIM_BUS boot as before (7 I/O, irq 562),
    12 stalls, one per bank switch; CSIM_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
2026-11-12 Halt-line test at PBI init (memory autodetection, step 1)
    PBI_INIT arms PBICMD_HALT_TEST, then counts in zero page ($CB) until the
    ESP posts a verdict at HALT_TEST_RESULT ($D860, in the old 6-NOP pad, so
    nothing earlier in the ROM moves; ~2 s timeout). Core 0 runs the test
    from its utility tick, a step per tick (no busy wait between samples:
    in csim that would freeze the CPU and look like a working halt): once
    the count moves, page 0's write ctrl gets the halt_ bit and pinReleaseMask
    drops it, so core 1 asserts and holds halt_ on the next count; two ticks
    later, a count that stood still means the line works. Then the bit is
    cleared and the 6502 released (held ~100 ms with the line, once per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
2026-11-12 Native memory probe sketch: overlay at $DC00, PROBE_BEGIN/PROBE_REPORT
    PBI_INIT JSRs to an overlay in COPYBUF ($DC00, 248 bytes, loaded with
    pbiROM[] at boot). It issues PBICMD_PROBE_BEGIN (the ESP puts a probe map
    in mmuStateSaved: board RAM at $0000-$3FFF and $C000-$FFFF as before,
    $4000-$BFFF, extBanks[], basicEnL1BlockMux[] and cartBanks[] on the
    dummy block, so native RAM answers), probes with NMIs and DMA off (RAM at
    $4000-$BFFF by 1K with $55/$AA, restored; a signature at $4000 under
    every PORTB value of bits 2-7, read back), and issues PBICMD_PROBE_REPORT
    (the ESP prints the native RAM top and the PORTB groups that share RAM,
    and restores the map). mmuOnChange() leaves banks alone du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
2026-11-12 csim: core 0 as a coroutine in bus-cycle mode (step 1)
    Core 0 gets its own ucontext stack: atari800's CPU tick advances the fake
    CCOUNT and resumes it, and it yields back when it waits, at every 64th
    CCOUNT read from its stack (csim.h) or in busyWait6502Ticks(), which now
    waits real emulated time (the 6502 runs or sits halted meanwhile) instead
    of running idle cycles. atari800 is never re-entered. The coroutine still
    runs csim's existing core 0 pass (bmon drain, utility tasks, interrupt
    timer); the real core0Loop() is next. Default mode is unchanged.
    Checks (BUS_CYCLE=1): 60 s SDX boot 7 I/O, irq 569 (was 562), halt test
    present, probe 48K; self-test PASSED; 130XE (-xe, CSIM_HALT_LINE=0)
    ab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
2026-11-12 csim: bus-cycle mode runs the real threadFunc()/core0Loop() on core 0's coroutine
    The coroutine now runs threadFunc() as the hardware does (core0Loop(): bmon
    drain, PBI requests, utility tasks with the real interrupt pacing and
    timeouts, then the end-of-run report), and csimCore0Finish() ends the run.
    csim_app_core0_pass() (csim's own pieces of core 0) is left for the
    default mode only. core0Loop()'s #ifndef CSIM blocks are still in place.
    Checks (BUS_CYCLE=1): 60 s SDX boot 7 I/O, halt test present, probe 48K,
    hardware DONE report; irq 238 (the real interrupt pacing; csim's timer
    gave 569); halt test holds ~123k cycles (two real 50 ms utility ticks);
    self-test PASSED; 130XE absent, 5 RAMs;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
2026-11-12 csim bus-cycle: run core 0's real waits (startup handshake, bmon wait, stack-program wait)
    With core 0 on its own coroutine, the three #ifndef CSIM carve-outs in
    its runtime path now compile in bus-cycle mode too: core0Loop()'s startup
    wait for the 6502's first writes, its inner bmon wait, and
    handlePbiRequest()'s wait for the 6502 to reach the stack-resident loop
    (the DUMMY_WRITE store). They yield through their CCOUNT reads.
    Checks (BUS_CYCLE=1): 60 s SDX boot 7 I/O, no stackprog timeout, halt test
    present, probe 48K; self-test PASSED; 130XE absent, 5 RAMs; BANKTEST
    0/61800 ext and cart, 0/6 pbi. Default mode unchanged.
    Claude-Sessi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
2026-11-12 Halt-line check in PROBE_BEGIN, straight-line in handlePbiRequest()
    Replaces the tick-based sketch (42de1119). After the stack-program wait
    for PBICMD_PROBE_BEGIN (6502 in the stack-resident loop, bus attached,
    core 0 interrupts masked): page 1's read ctrl gets halt_ and
    pinReleaseMask drops it, so core 1 holds halt_ from the loop's next fetch;
    three DUMMY_WRITE samples ~100 cycles apart, all equal = halt line works;
    release. The stack loop's sta DUMMY_WRITE becomes inc DUMMY_WRITE (same 3
    bytes) so the byte changes every pass. Removed: PBICMD_HALT_TEST, the
    PBI_INIT counter loop and HALT_TEST_RESULT, and the utility-tick state
    machine. Held ~300 cycles instead of ~100 ms.
    csim BUS_CYCLE (c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
2026-11-12 ExtBankPool AUTO layout; the probe counts distinct native banks (AUTO step 1)
    extMemPlanAuto() (pure, extMem.h): with a halt line and PSRAM, fill out
    to RAMBO256 (board sets on PORTB bits 5-6 = 01/10/11 after any native
    sets, PSRAM-backed, fronted by min(budget, banks) SRAM banks, none without
    SRAM for one); otherwise SRAM-only whole sets of 4, the largest of stock
    XE, Compy 192 and a 4-position layout that fits, native sets on the last
    positions. ExtBankPool::init() gains AUTO plus haltAvailable and
    nativeBanks parameters; explicit layouts are unchanged (TODO noted: they
    allocate 16 banks + a spare whether mapped or not). The memory probe now
    records memProbeTopKb and memProbeNativeBanks (d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
2026-11-12 mmu: use-tracking base RAM allocator and teardown (AUTO step 2)
    mmuAllocAddBaseRam() now allocates in pieces of at most 4K (good-fit heap:
    they fill holes and leave the large blocks to 16K bank buffers and WiFi)
    and records each page's owning piece. mmuFreeUnmapBaseRam(start, end)
    unmaps those pages in every L1Block the MMU can reach (mmuForEachL1Block():
    the static blocks and whatever mmuState/mmuStateSaved's tables point at,
    so snapshot, cartridge and bank-block copies too), clears baseMemPages[],
    and frees each piece when its last page goes. Pages it didn't allocate are
    left alone. For AUTO's shrink of the 64K boot map after the probe, instead
    of re-running mmuInit(). Resumable SIO scatte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
2026-11-12 SDX_AUTO: memory layout from the PBI-init probe (AUTO step 3)
    New boot configs SDX_AUTO (hardware disks) and SDX_CSIM_BUS_AUTO (csim's)
    boot with 64K of base RAM (2K atariRam plus mmuAllocAddBaseRam() pieces
    by range), no board banks and the halt line unused. At PROBE_REPORT,
    autoMemConfig(2K, 48K free): native RAM to 48K+ frees the pieces above
    $0800 except $D800-$DFFF (as a 2K boot has; a 600XL keeps 64K);
    ExtBankPool AUTO with an SRAM budget that keeps 48K free, backing off
    until the 16K buffers fit; the bank blocks rebuilt into mmuStateSaved
    (mmuBuildBankBlocks(), factored out of mmuInit() and freeing the previous
    build); haltAvailable, pinReleaseMask and the PORTB-write halt
    (mmuSetPort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
2026-11-13 SDX_AUTO: keep 32K of internal RAM free, not 48K
    Boot-time free internal RAM on today's configs: 130XE (SDX_XE192, 4 SRAM
    banks) 33-39K, 600XL (SDX_600XL) 51K, 800XL (SDX_XL) 79K, WiFi fine on
    all. With a 48K reserve a 130XE (~103K free before banks) got 3 banks,
    not a whole set: no board banks. 32K keeps its 4 (as SDX_XE192); a 600XL
    gets 2 SRAM fronts with ~35K left (it failed WiFi at 17.8K).
    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
2026-11-13 Memory probe: test RAM with BASIC off; a two-line report
    First hardware runs of SDX_AUTO (.1 800XL, .3 600XL, .5 130XE) all
    reported native RAM under 48K, so nothing shrank: the RAM test ran with
    PORTB as the OS left it, and with BASIC enabled $A000-$BFFF is ROM
    (PBI_INIT turns BASIC off only after the probe; csim's atari800 had it
    off). The overlay now sets PORTB to $FF (OS on, BASIC off, no bank,
    self-test off) for the RAM test and restores it after. The report's
    burst of long lines (the bank groups) never reached the hardware console;
    it's two short lines now: halt samples, RAM map, native bank count, and
    the raw $4000 readbacks.
    csim: 800XL RAM to 48K, base 2K, 12 PSRAM banks, SDX 4 Ext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
2026-11-13 Halt-line check: count the stack loop's DUMMY_WRITE writes in bmon
    On .5 (130XE: the ECI has no halt line, so the PBI->ECI adapter leaves it
    unconnected) the first SDX_AUTO run reported a halt line: DUMMY_WRITE's
    value in pbiROM stood still across the samples although the 6502 kept
    running. The verdict now counts writes to DUMMY_WRITE in bmon over the
    held window (core 1 logs every write whatever the map or data path; INC
    makes two per pass): none means the 6502 stopped. The value samples stay
    in the report for diagnosis.
    csim: halt line 'yes (0 writes)'; CSIM_HALT_LINE=0 'no (27 writes)'.
    Claude-Session: https://claude.ai/code/sessio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
2026-11-13 Memory probe report: flush and pause after each line
    The two report lines were still missing from the hardware console (.1),
    while the AUTO lines printed just after them came through.
    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
2026-11-13 Memory probe: AUTO configs only; halt usability inferred from native banks
    The board's halt_ drives PBI READY: an XL's 6502 RDY (a clean pause), but
    through the PBI->ECI adapter a 130XE's ECI HALT, which stops the 6502 and
    floats its bus. A halt test can't tell them apart (.5 reported 'halt',
    0 writes while held, and AUTO's halt layout then never booted), and the
    test itself held halt_ ~300 cycles at every PBI init on every config:
    normal SDX_XE192 boots on .5 failed on f9d9c5e3 (stalls at 11 and 2029
    I/O). So: the halt test is gone and the stack loop is sta DUMMY_WRITE
    again; halt usable = no native banks (XL/600XL), an XE's isn't (an 800XL
    with an XE-style upgrade is taken for an XE: SRAM-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
2026-11-13 WiFi: preinit the driver in setup(), start and connect later
    wifiPreinit() (NVS, netif, event loop, STA interface, esp_wifi_init() and
    the event handlers: memory only, no radio) runs in setup() when WiFi is
    enabled, before the boot heap report, the ROM DRAM reclaim guard and core
    1, and after the fixed extended banks are allocated. wifi_init_sta() keeps
    mode, config, esp_wifi_start() and the connect, deferred as before.
    Why: SDX_AUTO on .1 (800XL) sized its banks at PBI init with WiFi not yet
    initialized (6 SRAM fronts, 39K free) and esp_wifi_init() then failed with
    no memory when SDX first used the SMB drive: abort, panic reboot. With the
    driver's static buffers and task claimed first, AUT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
2026-11-13 EXPERIMENT: core 1's hot data out of SRAM bank 3 (.data -> .bss)
    cf24ba7c (system monitor off) broke .5 (130XE) although nothing core 1
    does changed: without the monitor's data, mmuState and the L1Block
    tables moved into SRAM bank 3, the bank where IRAM code ends (WiFi RX,
    esp_flash) and .data begins, with core 0's interrupt stack. Here
    mmuState, the static L1Blocks, d000Read/d000Write, bmonArray/Head/Tail
    and lastPageOffset drop DRAM_ATTR and their initializers, so they land in
    .bss (banks 4-5); setup() sets mmuState.pinReleaseMask and d000Read[0].
    pbiROM is still in bank 3.
    Claude-Session: https://claude.ai/code/session_01KzPLu7BCcGY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
2026-11-13 Core 1 hot data in .bss, out of IRAM code's SRAM bank; build check
    Finishes the exp-core1hot-bss experiment (0d15227c: two clean 6-minute
    SDX_XE192 runs on .5, which cf24ba7c's layout failed within minutes).
    Core 1's hot data (mmuState, the static L1Blocks, d000Read/d000Write,
    pbiROM, bmonArray/Head/Tail, lastPageOffset) lives in .bss, not at the
    front of .data, where it shared SRAM bank 3 with the end of IRAM code
    (WiFi RX, esp_flash) and core 0's interrupt stack. pbiROM now comes from
    pbiROMImage[] (flash rodata); a static initializer in mmu.cpp copies it
    and sets the non-zero initial values (pinReleaseMask, d000Read[0]) before
    app_main() on the ESP32 and before csim's atari800 maps the RO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
2026-11-13 hardware: setup-hardware-tools.sh, the headless KiCad + Freerouting install
    Installs what hardware/AGENTS.md's Tools table lists: KiCad 9 from
    ppa:kicad/kicad-9.0-releases (checks kicad-cli and pcbnew for
    /usr/bin/python3; warns about the snap), Freerouting 2.5.0 into
    ~/opt/freerouting (freerouting.jar link), and the Temurin JRE pinned to
    25.0.5+8 (miner6's) into ~/opt/jre25. Each step skips what's there;
    'kicad', 'freerouting' or 'java' runs one. Tested here: skips on the
    installed tools; Freerouting and JRE downloads into a scratch dir (jar
    byte-identical, JRE 25.0.5+8, Freerouting starts).
    Claude-Session: https://claude.ai/code/sess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
2026-11-13 hardware: optional NTSC composite out on sidecar_pcb_xl/xe (R18-R21 ladder, RCA J8)
    A 4-bit grayscale ladder from the Sidecar into an RCA jack, all DNP
    (fit all five or none): R18-R21 = 2.7k, 1.3k, 680, 330 from Sidecar
    IO8/IO18/IO21/IO38 (also on J7) to NTSC_VIDEO, the centre of J8, a Same
    Sky RCJ-041 right-angle jack (Digi-Key CP-1418-ND); the TV's 75 ohm
    input is the load. Values and levels: espBusBangSidecar README.
    - make_sidecar_xl_schematic.py adds them after every other part, so
    earlier UUIDs (and the board links) keep; place() takes dnp. Netlists:
    no existing pin changed net on either board; XE still differs from XL
    only at J1 (ECI C1 still READY).
    - J8's footprint (new hardw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
2026-11-13 Docs: why ECI HALT can't stand in for RDY on the 130XE
    The 130XE's ECI pin C is "!HALT from Antic" (service manual), ANTIC's
    HALT output to the 6502C, also latched by the XE's U35 glue logic to time
    ANTIC's cycles (a U35 replacement design notes it); the ECI has no RDY (a
    hobbyist ECI->PBI adapter bodges RDY from ANTIC pin 15). Through the
    eci2Pbi adapter the board's halt_ drives HALT: it stops the CPU and floats
    its bus, so it's unusable for bank swaps. Git never recorded the reason
    (halt was dropped on the XE by experiment: 9ba21ffe, 510ca061, ed6eb4c8).
    docs/memory-autodetect.md: the reason and sources in "Halt line"; the
    stale "halt_ isn't connected on the XE" note marked superseded; th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
2026-11-13 hardware/gerbers/pcbway: regenerated at 9141d3b7 (NTSC J8 on XL/XE)
    export_pcbway.sh from a clean tree, so the boards' silkscreen stamp reads
    REV 9141d3b7. sidecar_pcb_xl/xe now carry the optional NTSC ladder and
    RCA jack (fdaf2e54); the other three boards are unchanged apart from the
    stamp. BOM/CPL files unchanged (the new parts are DNP).
    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
2026-11-13 hardware tools: run on KiCad 10 as well as 9
    Found on a24 (KiCad 10.0.6, Ubuntu 26.10):
    - pcbnew's SWIG iterators lost next(): GetTracks(), GetDrawings() and
    GraphicalItems() raised AttributeError. tools/kicad_compat.py aliases it
    (a no-op on 9); the pcbnew scripts import pcbnew through it. Also
    board_polygon_outlines() for GetBoardPolygonOutlines()'s new required
    argument (silk_labels.py, specctra.py).
    - kicad-cli pretty-prints netlists: tools/kicad_netlist.py normalizes both
    layouts to 9's compact one for the existing regexes (the four readers;
    netlist_to_pcb.py no longer splits components on a newline). 10 also
    suffixes some pin functions with the pin number (GND_22);
    mak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
2026-11-13 Sidecar: bus sampler on core 0, serial flasher for the main board
    Both on the bench pair (main E8:F6:0A:D2:EE:78 FAKE_CLOCK/BENCH, Sidecar
    FC:01:2C:2D:8A:3C), wired per docs/sidecar_wiring.pdf.
    Sampler (sidecarSampler.cpp): a core-0 task with its own dedicated-GPIO
    bundle runs bus_profiler's capture in 2 ms interrupt-masked chunks, from
    IRAM, and prints the HIST tables every 10 s. Pins: phi2 4, R/W 5,
    extSel_ 6, D0 7, D1 15, A0 16, refresh_ 17 (internal pull-up: an unwired
    bench pair reads every cycle as real), BCLK 10 in the profile slot (not
    recorded). A pin survey at start reports which pins toggle and the phi2
    rate, and picks the 6502 (1.78 MHz) or FAKE_CLOCK (1.43 MHz) capture.
    extSel_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
2026-11-13 Sidecar flasher: 2 Mbaud with a checked fallback; spiffs-sidecar.bin staging
    - mainFlasher: 2 Mbaud after sync (bench: app 16.2 s vs 20.9 s at
    921600; 5 Mbaud also ran, 13.3 s, but the carrier boards' 1 k series
    resistors argue for margin). A READ_REG of the chip-detect word right
    after the switch checks the rate in 500 ms; on any failure the flasher
    resets the main board and starts over at 921600 (tested with a forced
    mismatch: caught within a second, then written and verified). Reports
    the erase time separately (1.7 s for the app).
    - spiffs/Makefile: spiffs-sidecar.bin, spiffs.bin's files plus the main
    board's firmware in main/ from MAIN_BUILD (default ../build);
    tools/flas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
2026-11-13 Sidecar flasher: refuse download mode with an Atari on the bus
    Before every download-mode reset (flash, dl) the Sidecar holds the main
    board in reset (EN low: all its pins released; harmless to a running
    Atari) and watches phi2, R/W, extSel_, D0, D1, A0, refresh_ and both
    UART wires (Atari D5/D6 at the main board) for 50 ms. Any edge is then an
    Atari running: refuse (ESP_ERR_INVALID_STATE), name the lines, release
    the main board to boot. The flash UART is started only after the check,
    so it never drives D6 of a live bus.
    Released lines float: the first version saw phi2 'active' on the bench
    with no Atari. The check now holds weak internal pull-downs on them
    (extSel_/refresh_ keep the sample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
2026-11-13 Sidecar flasher: refuse a main board running a FAKE_CLOCK build
    Before anything else, with the main board still running, enterDownload
    Mode() measures phi2 (falling edges over 10 ms of GPIO-register reads).
    A normal main build never drives phi2; a FAKE_CLOCK build does (APB 80 MHz
    / 56 = 1.43 MHz, with R/W and A0), and so does an Atari (1.77/1.79 MHz).
    Any clock: refuse without resetting the main board, naming FAKE_CLOCK when
    the rate is 1.35-1.50 MHz. Then the in-reset Atari check, as before.
    buscheck also prints the rate.
    Bench: with the FAKE_CLOCK build running, flash app and dl refused
    (1.399/1.400 MHz measured) and the main board kept running (the sampler
    saw its clock throughout). Wit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
2026-11-13 Sidecar flasher: one rule, any phi2/D0/D1 edge refuses reset and flash
    Replaces the clock-rate test and the in-reset check with a single,
    stricter rule: before every reset, download-mode reset and flash, phi2,
    D0 and D1 are watched for 50 ms (weak pull-downs meanwhile, so undriven
    lines can't float into false edges), and any transition refuses with the
    main board left untouched. A running Atari toggles all three; so does a
    main board running a FAKE_CLOCK build, the bench's stand-in for a live
    Atari system. No rates or thresholds. reset is now checked too; the
    flasher's own resets after a checked download-mode entry are not.
    buscheck reports the lines and the verdict; buscheck selftest (idle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
2026-11-13 Sidecar flasher: pull-downs on phi2/D0/D1 for the Atari probe only
    A main board off its Atari leaves the probed lines floating (the real
    case when flashing it out of the machine). Unpulled they read mostly 0-4
    edges in 50 ms, but one burst of 1,173 on phi2 was seen. Now each gets a
    weak internal pull-down for the 50 ms probe (5 ms to settle first) and
    loses it right after, so the taps are inputs only otherwise. The 10,000
    edge threshold stays as the second guard.
    Bench, normal main build, 20 rounds of dl/buscheck/reset plus 3 selftest
    pre-checks: all 63 probes phi2=0 D0=0 D1=0, no refusals. Self-test (1 MHz
    on D0): ~98,400 edges, passed 3/3, and the crosstalk it used to put on
    the floating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
2026-11-13 Sidecar link v2: symmetric frames, object fetch, diagnostic mode
    Both directions now carry the same frame: a link header {version 2,
    mode Idle/Command/Response, frameSeq, ackSeq} then one message header.
    No side writes a new frame until the peer has acked its current one;
    ack-only rewrites are always allowed. The main board is the priority
    peer: the Sidecar yields (Preempted) and its caller retries.
    Stateless, receiver-driven fetch in either direction: ReadVersion
    {object -> size, CRC32 version} and ReadChunk {object, offset -> data,
    zero length = EOF}; sidecarFetch() rechecks the version afterwards.
    Objects: Firmware (Sidecar, /spiffs/main/app.bin), Core (main, not yet
    served), Test (both,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
2026-11-13 Sidecar diagnostic mode: detach the bus; serve the link from startup
    All of core 0's link service is now core0_serviceSidecar(), called from
    core0_utilityTasks() and from core0Loop()'s wait for the 6502's first
    writes, so main answers the Sidecar before the Atari runs or with no
    Atari at all. Entering diagnostic mode (for core dump fetches and
    firmware updates, which touch main's flash) detaches the bus for good,
    re-enables interrupts and serves the link until reset; a running Atari
    crashes, which is accepted. The hot bmon loop is untouched.
    Bench: a no-FAKE_CLOCK build with no Atari answered during the startup
    wait (100 KB in 0.84 s), entered diagnostic mode and stayed in it past
    the 30 s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
2026-11-14 Sidecar SetDiagnostic flags: Diagnostic, FetchFirmware, Panic
    SetDiagnostic now carries flags; any flag implies Diagnostic and they
    only add up until reset. Panic serves the link 100 ms (so the Sidecar
    reads the response) and then abort()s, to test the core dump path;
    FetchFirmware is accepted and reported but not built yet. Documented:
    the planned hardware holds the Atari's reset low in diagnostic mode.
    A 10 ms vTaskDelay after re-enabling interrupts lets the console print.
    Sidecar console: diag, diag ota, diag panic.
    Bench: diag panic wrote a core dump (724 KB, abort() in
    core0_diagnosticMode(), decoded with esp-coredump) and rebooted.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
2026-11-14 Sidecar boot status: main reports reset reason and core dump token
    BootStatus (7, main to Sidecar) is sent once per boot from
    SidecarHost::begin(), before core 1 starts: reset reason, flags (core
    dump partition, core present, ota_1 slot), the core dump's size and
    token (the first 4 bytes of its stored SHA-256: a 32-byte read, no
    rehash), the app's ELF SHA-256 token and GIT_VERSION.
    The Sidecar acks it and then acts: an unseen core dump means main just
    crashed, so it puts main in diagnostic mode at once (retrying up to 10 s
    while main finishes setup) and records the token in /spiffs/lastcore.
    The core fetch itself is not built yet.
    Bench: an unseen core put main in diagnostic mode 272 ms af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
2026-11-14 Sidecar core dump fetch: main serves Core in diagnostic mode
    Main registers its core dump (flash address, size, stored-SHA-256 token)
    as the Core object at boot. Sidecar::pollDiagnostic(), the diagnostic
    mode loop, serves it with esp_flash_read() and otherwise answers as
    poll() does; poll() (the hot path) still answers Core Unavailable.
    On a new core in main's boot report the Sidecar enters diagnostic mode
    at once, fetches the dump, recomputes the SHA-256 IDF stores in its last
    32 bytes, records the token in /spiffs/lastcore only on success, then
    prints "SIDECAR HALT: ..." and halts (console only); main stays in
    diagnostic mode. Storing the dump is not built (no room yet): core dumps
    still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
2026-11-14 master: don't serve the Sidecar link from core0_utilityTasks()
    The link poll's delays in the utility pass beside the hot bus (a beam-
    window wait per new frame, up to ~2.4 ms for a lock search, up to 5 ms
    for an ack) are too much risk, and it starved the drained-bmon PBI
    fallback poll. The call is commented out with the consequences
    documented: once the 6502 runs, main no longer answers Sidecar->main
    commands (ping, SetDiagnostic, Test/Core reads), so a Sidecar can't put
    a running main in diagnostic mode; main->Sidecar commands (SIO, CIO,
    Mount, BootStatus) are unaffected, as are the startup wait and
    diagnostic mode, which still serve the link. Production builds have the
    link off anyway. The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
2026-11-14 Merge exp-sidecar-ota's link and Sidecar work into master (squashed)
    Everything from exp-sidecar-ota except its partition table (ota_1 beside
    a 1 MB core dump) and its stack-only core dumps: master keeps
    partitions.csv and CONFIG_ESP_COREDUMP_CAPTURE_DRAM.
    - Diagnostic mode decided only in the Sidecar's reply to BootStatus,
    entered in setup() before core 1 starts or the bus is attached; no link
    polling anywhere in the bmon loop; SetDiagnostic removed. main probes
    for the Sidecar up to 3 s, complains, boots normally if absent.
    - OTA from the Sidecar (SidecarHost::installFirmware()); on master's
    one-slot layout it reports "no update slot" (the "next" slot is the
    running one there, n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
2026-11-14 i2slink_peek(): drop a stale lock (periodic live framing check)
    After main restarted (an OTA's restart), the Sidecar's stream came back at
    another bit offset; the Sidecar's peek kept its old lock and, finding T's
    bits unchanged at the stale position, returned "nothing new" forever, so
    it never answered main's probe (main booted "EXPECTED A SIDECAR"). The
    old hint()+read() path checked framing on every window; the peek only on
    a copy. Now its nothing-new path also checks the HSYNC markers in the live
    ring, at most once per half wire cycle (they're the same bytes in every
    frame, so the check holds mid-DMA), and drops the lock on a mismatch; the
    next peek searches.
    Bench: 8 main resets in a ro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
